AdithyaKesanJayakanth/PLE-SBS-Capstone/README.md

# PLE-SBS — Pre-Launch Emergency: The Slidewire Basket System

A student engineering study of a gravity-driven slidewire escape system for crew and close-out technicians at a crewed launch pad, with a sizing method for any launch pad (span ≈ 100 m + 4 × crew access height) and a worked example for a low, 42 m pad. It goes from the safety problem and its requirements, through physical models and a simulator, to a design that has been run, checked against NASA systems and revised.

> [!IMPORTANT]
> **My special add-on to the existing egress system: one wire, a switch yard and a bay for every pod.**
>
> Existing slidewires give every basket its own wire and brake it at the end of that wire. PLE-SBS keeps the proven ride but moves the braking off the wire. At the bottom, self-indexing points send each pod into its own braked bay beside the bunker, so:
>
> - all the pods share **one wire** and leave about 8 s apart (37 s with a single dock);
> - one wire clears 24 people in 113 s in a design headwind, close to six separate wires (111 s);
> - a pod whose magnetic brake has failed still stops at 1.4 g in its bay's drag-chain bed;
> - nothing needs power: the points, brakes and release interlock are all passive.
>
> See Section 6.2 of the paper and the switch-yard option in the simulator.

**Simulator:** https://adithyakesan.com/ple_sbs/

- **Paper** (≤ 7 pages): `paper/PLE-SBS.pdf`, editable copy `paper/PLE-SBS.docx`, source `paper/paper.md`
- **Simulator**: `web/index.html`. Pick any rocket and pad, choose a single dock or a switch yard, a catch net or drag-chain bed, fail a magnetic brake, and watch the evacuation. A Materials & BOM tab lists what the chosen design is made of.
- **Physics**: `sim/core.js`, one dependency-free file shared by the website and the paper's figures
- **Scale model** (1:50, print-only, the wire is the only purchase): `scale_down/` has the 26 STL files, a fit-and-motion check (also run in FreeCAD), sketches, renders, BOM, build log and test results, including the one-wire switch yard with three self-indexing bays
- **Poster** (A0 landscape): `PLESBS_Poster.pdf`, source `poster/PLESBS_Poster.tex`. Rebuild with `.venv/bin/python poster/make_poster_figs.py && (cd poster && tectonic PLESBS_Poster.tex) && cp poster/PLESBS_Poster.pdf .`

Author: Adithya Kesan Jayakanth, Padma Seshadri Bala Bhavan, K.K. Nagar, Chennai. Mentor and guide: Mrs. Abhitha Peter, Class 12 physics teacher.

## Where the idea came from

PLE-SBS is inspired by the roller coaster. A roller coaster is a machine for giving people forces safely. In an earlier project I built "Safe Thrills", a Python model that designs the most thrilling coaster that stays within human g-force and jerk limits. The lesson that stuck: the ride is good because it runs close to what a body can take, and safe because it never crosses that line.

After I presented my F1 airflow simulations and the roller-coaster model at ISRO's Satish Dhawan Space Centre, the Gaganyaan directors suggested, based on those two projects, the problem of getting a crew off a fuelled launch pad in an emergency. I started from NASA's slidewire baskets at Kennedy's Launch Complex 39 and measured my design against them.

So this is a coaster designed for the worst day instead of the best one. Gravity drives it, a brake limits it, and 1.5 g is the line it must not cross (requirement R4). The brakes are eddy-current brakes of the kind used on roller coasters. The only score is how fast the last person is behind a blast door.

The slidewire basket is NASA's idea. The sizing method for any pad, the finding that passive braking works only in a narrow band of geometry, and the switch yard are mine. ISRO suggested the problem; it did not assign, review or approve the design.

## Run the simulator

Open `web/index.html` in a browser. No build step and no server are needed. Or serve the folder and open `http://localhost:8737/web/`:

```bash
python3 -m http.server 8737
```

## Rebuild the paper

Needs Node 18+, Python 3, pandoc, poppler (`pdfinfo`) and Google Chrome.

```bash
python3 -m venv .venv && .venv/bin/pip install matplotlib numpy
```

```bash
./paper/build.sh
```

This runs the tests, re-runs every study into `data/results.json`, redraws `figures/*.png`, builds the PDF and DOCX, and fails if the PDF is longer than 7 pages. Use `./paper/build.sh --quick` after editing only the text.

## Tests

```bash
node --test test/*.test.js
```

## Publish on GitHub Pages

1. Create a GitHub repository and push this folder.
2. Settings → Pages → Deploy from branch → `main`, folder `/ (root)`.
3. The simulator will be at `https://<user>.github.io/<repo>/web/`. The root `index.html` redirects there.
4. Put that URL into `paper/paper.md` (the `simulator:` line and ref [16]) and rebuild.

## Layout

```
sim/core.js                  physics: hazard, cable, pod dynamics, evacuation, Monte Carlo, trade, sensitivity, scale-model fit
sim/export.js                runs every study in the paper -> data/results.json
figures/make_figures.py      paper figures from data/results.json
paper/                       paper.md (source), template.html + paper.css (layout), build.sh
poster/                      PLESBS_Poster.tex (A0 poster), make_poster_figs.py -> poster/img/
scale_down/                  print-only model: make_parts.py -> stl/, make_drawings.py -> sketch_*.png, BOM.md, README.md
web/                         simulator UI (index.html, app.js, style.css)
data/scale_model.csv         scale-model runs (template; add measurements)
docs/scale-model-protocol.md how to test the 1:50 tabletop rig
docs/scale-model-bom.md      rig parts list, prices, assembly; docs/scale-model-bom.csv
cad/make_parts.py            parametric 3D-printed parts -> cad/stl/*.stl (+ cad/parts_preview.png)
cad/make_drawings.py         rig layout and trolley assembly drawings
test/core.test.js            physics unit tests
site/build.sh                packages the simulator as a static site (published at adithyakesan.com/ple_sbs/)
private/                     author notes (sources, checklist); git-ignored, never published
```

## AI assistance

I used an AI assistant as a programming assistant, tutor and reviewer under the policy in [docs/ai_usage_policy.md](docs/ai_usage_policy.md): drafting and debugging the simulator and its tests, the part generators and the figure scripts, explaining the physics and numerical behaviour when I asked, and reviewing the writing. The requirements, the danger levels, the design decisions and their failures, the sizing rule, the switch-yard add-on and the conclusions are mine, and every number in the paper is produced by the code in this repository and checked against a closed-form case, a reference value or a hand calculation. [docs/ai_use_log.md](docs/ai_use_log.md) lists the assistance actually used and how each output was verified.

## Honesty notes

- All results are model predictions from public data and stated assumptions. This is not a certified safety analysis.
- The reference launcher and pad are generic; their dimensions are estimates.
- Unconfirmed facts are marked `[VERIFY]` in the paper and listed in `docs/author-checklist.md`.
- The scale-model pictures in the paper and poster are renders of the part files; photographs and timed runs go in `scale_down/photos/` and `scale_down/results.csv`.
