AdithyaKesanJayakanth/PLE-SBS-Capstone/scale_down/photos/README.md

# Photographs

Put photographs of the printed model here, named like `01_yard.jpg`, `02_pod.jpg`, `03_points.jpg`, `04_run.jpg`.
The paper and poster use the renders (`render_*.png`) until photographs exist; swap the file names in
`paper/paper.md` (Figure 8) and `poster/PLESBS_Poster.tex` (block 3) and rebuild.
