AdithyaKesanJayakanth/PLE-SBS-Capstone/docs/ai_use_log.md

# AI-use log — PLE-SBS

Kept as required by `docs/ai_usage_policy.md`. "Checked by" names the verification actually performed (test, reference comparison, hand calculation, documentation lookup), not an intention. Dates are the repository's commit dates.

| Period | Tool | Task | Significant assistance received | Changes I made | Checked by |
|---|---|---|---|---|---|
| 2 June 2026 | AI coding assistant | Project set-up | Drafted the build scripts, the paper template and the data layout | Chose the single-physics-file structure so the paper and the website share one model; set the 7-page limit in the build | Build runs end to end; page-count check fails the build when exceeded |
| 4–10 June | AI coding assistant | Hazard model, cable model, pod dynamics | Drafted `sim/core.js` from my written specification of the TNT equivalence, cube-root blast scaling, High's fireball correlations, the taut-string influence line and the pod equation of motion; explained the eddy-current brake's velocity dependence | Decided the two-corner brake sizing, the danger levels and the requirements R1–R7; chose the thermal dose threshold between pain and first-degree burn | Unit tests against closed-form cases (√2gh arrival, incline time, terminal speed, wL²/8T and PL/4T sag); hand calculation of the reference launcher's TNT and blast distance |
| 8–13 June | AI coding assistant | Evacuation simulator and web interface | Drafted the dispatch logic, the headway bisection, the Monte Carlo loop and the browser interface | Set the human timings, the balanced-loading rule and the release-from-inside design; chose what the interface exposes | Time-step halving changes the total by 0.03 s; a stalled pod holds the one behind it; validation against the Shuttle-era basket speed with no tuning |
| 13–15 June | AI coding assistant | Scale-model rig parts and drawings | Drafted the parametric part generator and the drawings | Chose the 1:50 scale, the Froude mapping and the test protocol | Watertight STL check; dimensions read back from the drawings |
| 16 June – 6 July | AI coding assistant | Results export, figures, paper draft | Ran the studies into the results file, drafted the figures and the first draft of the paper from my outline; reviewed later drafts | Wrote the requirements, the design-iteration narrative (D0 to D5), the sizing rule, the switch-yard add-on, the limitations and the conclusion; marked every unconfirmed fact `[VERIFY]` and worked the author checklist | Every number re-read against `data/results.json`; references opened and confirmed (NTRS, HSE, Reveles et al.); Shuttle validation within 3 % |
| 20–21 June | AI coding assistant | Research poster | Laid out the A0 poster from the paper and my notes on the inspiration (the coaster paper, the visit to ISRO, the build-run-redesign loop) | Chose the block structure and what to say in my own words; cut text to fit | All numbers cross-checked against the paper; rebuilt with tectonic |
| 22–27 June | AI coding assistant | Print-only 1:50 model with the switch yard | Drafted the parametric part generator (pods, rails, turnout, cam and star indexer, comb, chain, bumper), the sketches, the renders, the BOM and the room-sizing calculator | Set the constraints (one purchase, P1S bed, 2 m tie point), chose the friction comb and the star-and-cam indexer as model-scale substitutes, and wrote the honesty notes on what is and is not to scale | Every STL watertight and single-body; bounding boxes within the bed; geometry read back from the sketches; mechanism clearances checked against the pannier sweep |
| 25 June | AI coding assistant | Paper and poster update for the model | Drafted the Section 4 paragraph and Figure 8 | Decided what to claim and kept the placeholder for measured runs until they exist | Rebuilt PDF at 7 pages; figure captions state that the pictures are renders |
| 28 June – 3 July | AI coding assistant | Model version 2 after the printed parts did not fit | Audited version 1 against itself (`scale_down/check/audit_v1.py`), redesigned phase 1 around the wheel's seat heights, replaced the star-and-cam indexer with a flap-driven two-finger escapement, wrote the fit-and-motion check and the FreeCAD cross-check, re-sliced the parts and listed what to reprint | Printed version 1 and found that the wagon, the axles and the turnout did not fit; asked for a full fit check in FreeCAD before reprinting | Every part placed in its working position with exact overlap volumes; a wagon driven down all three lanes; the escapement simulated R, C, L; the same clash check repeated with FreeCAD's own booleans (`scale_down/check/assembly_report.md`, `freecad_report.md`); the earlier row's sweep check missed these faults, which is why the check now uses the real parts in place |
| 1–2 July | AI coding assistant | Phase-1 assembly guide, animations and motion check | Placed every phase-1 part for each assembly step and for a run of three wagons, drove the flap, rocker and tongue with the fit check's kinematics, rendered the steps in FreeCAD and made the animations; the assembly-path check found that the tongue could not go onto its post past the rocker bridges, that the last comb leaf blocked the next segment and that the start gate would drop off the wire, and these were redesigned (separate rocker bridge, entry-rail web raised, comb leaves moved back, gate slot turned down) | Asked for FreeCAD screenshots, step-by-step assembly and working animations, and to be sure the printed parts can be put together | Every assembly move replayed in small steps against the parts already in place (`scale_down/assembly/path_check_report.md`); the same moves and the run replayed with FreeCAD's booleans (`freecad_motion_report.md`); the full fit check rerun |
| 3 July | AI coding assistant | Red-team review of phase 1 | Asked to attack the design for hand assembly, fit and whether the experiment can run; found that the plate gap was not positively set, that 0.3 mm lip clearance was too tight for a printed blade, that the plate and boss thicknesses did not suit the layer height, that the snap notches were tight, that the bridge beams could sag onto the teeth, and that the brake comb and bumper cannot stop a pod at scale speed; made the six geometry fixes and corrected the README's tuning advice | Asked for the review and then for the fixes | Forces and stack tolerances computed from the part constants; both fit checks, the path check and the FreeCAD checks rerun on the changed parts; changed parts re-sliced |
