AdithyaKesanJayakanth/PLE-SBS-Capstone/scale_down/render_overall.png

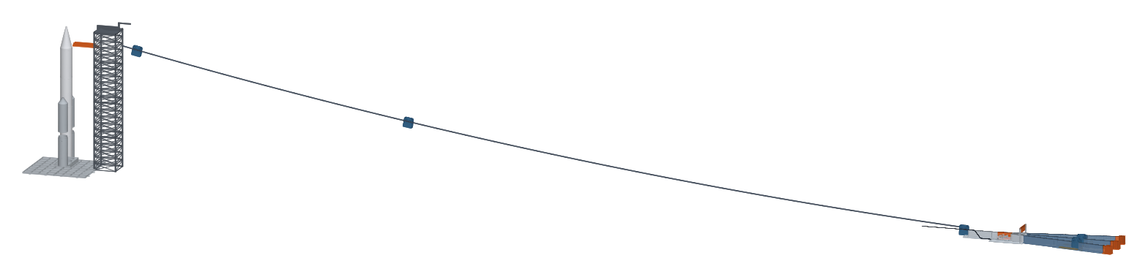
scale_down/render_overall.png
