AdithyaKesanJayakanth/PLE-SBS-Capstone/scale_down/render_overall_dimensioned.png

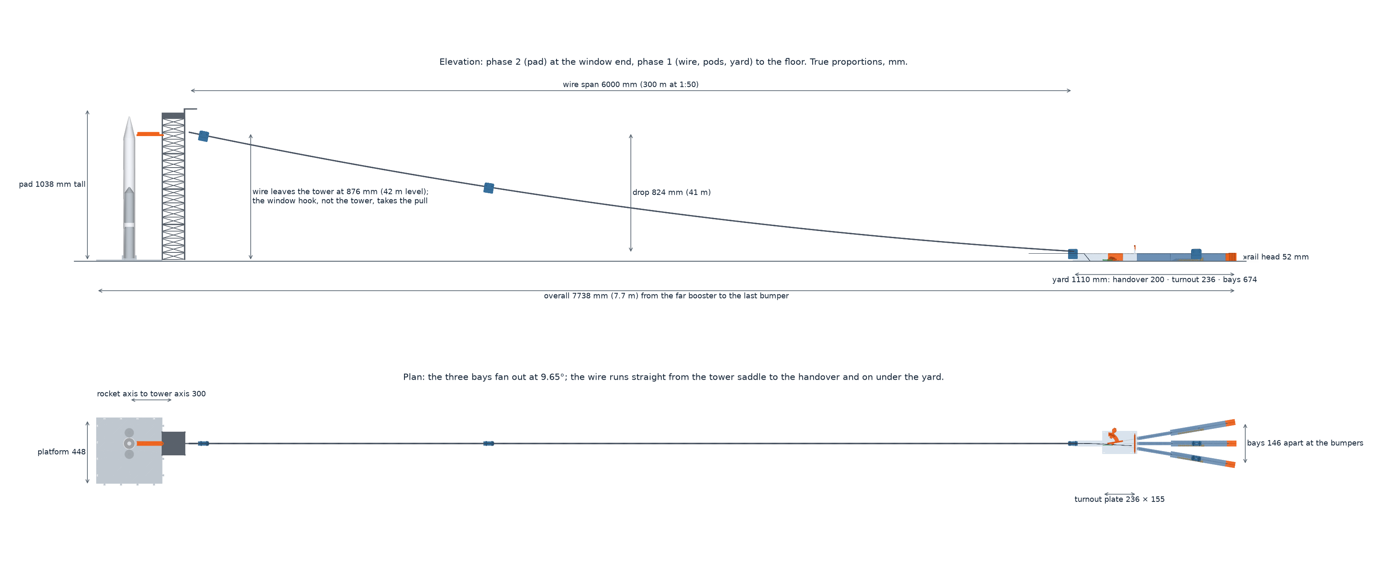
scale_down/render_overall_dimensioned.png
