AdithyaKesanJayakanth/PLE-SBS-Capstone/scale_down/render_pad_dimensioned.png

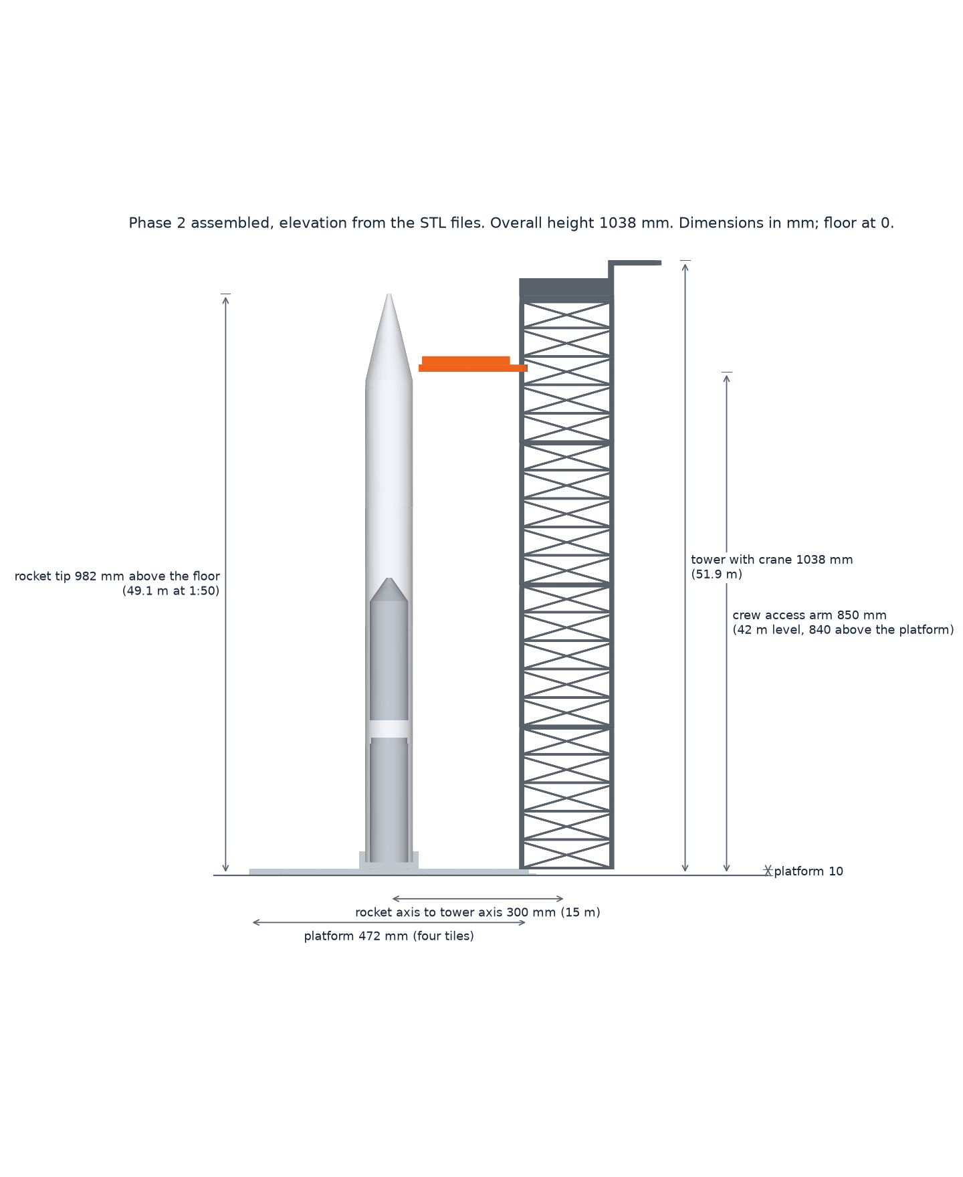
scale_down/render_pad_dimensioned.png
