AdithyaKesanJayakanth/PLE-SBS-Capstone/scale_down/render_pad_side.png

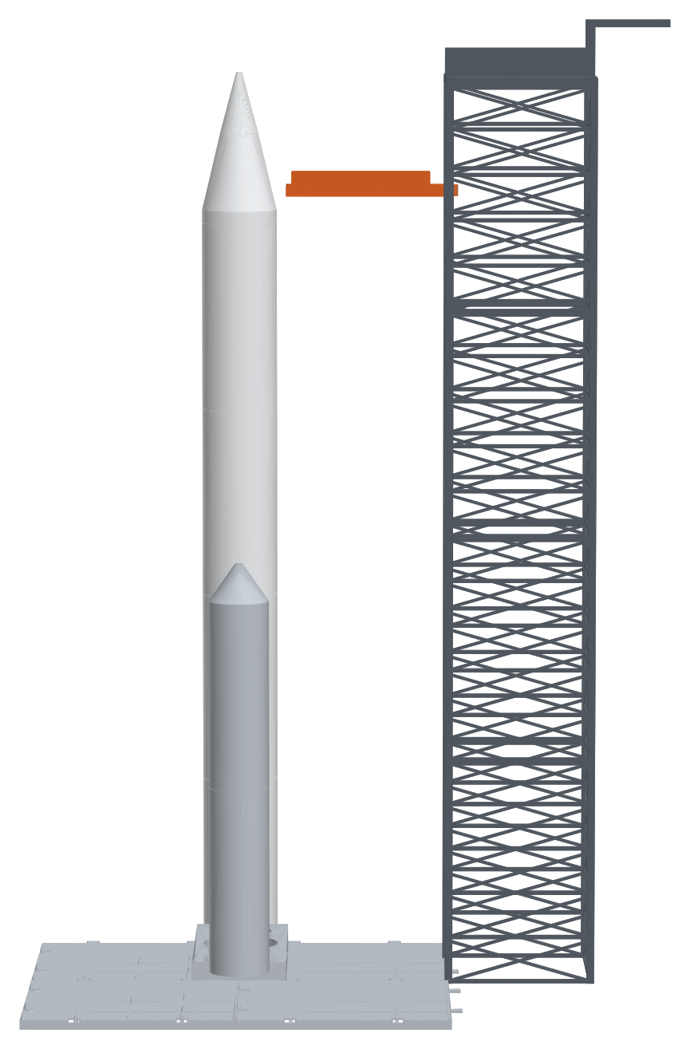
scale_down/render_pad_side.png
