AdithyaKesanJayakanth/PLE-SBS-Capstone/scale_down/sketch_8_launchpad.png

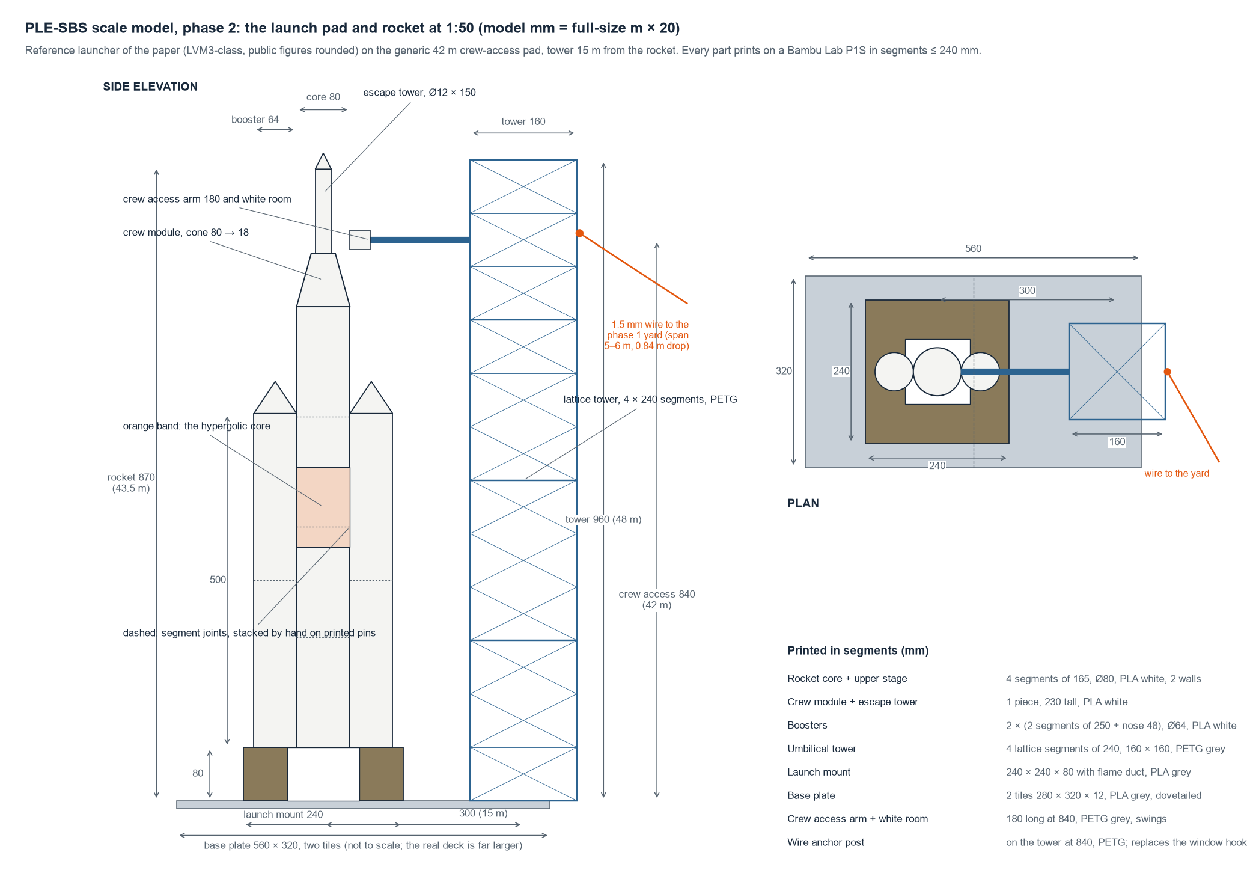
scale_down/sketch_8_launchpad.png
