AdithyaKesanJayakanth/PLE-SBS-Capstone/scale_down/BOM_phase2.md

# Phase 2 bill of materials: launch pad and rocket at 1:50

Files: `stl_phase2/` (13 STL files, 27 pieces), generated by `make_pad_parts.py`; the same table is in `pad_parts.csv`; preview `pad_parts_preview.png`; assembled render `render_pad.png`; dimensions `sketch_8_pad_phase2.png`. Nothing to buy except filament. The model is cosmetic: the wire's pull goes to the window hook, not the printed tower.

## 1. Printed parts

| # | File | Qty | Size (mm) | Filament | Colour | g each | g total | Orientation | What it is |
|---:|---|---:|---|---|---|---:|---:|---|---|
| 1 | core_segment_x4.stl | 4 | Ø80 × 210 | PLA Basic | Jade White | 50 | 200 | standing, spigot up | core stage tube, 200 mm plus a 10 mm spigot; two strut holes each side |
| 2 | capsule_x1.stl | 1 | Ø80 × 160 | PLA Basic | Jade White | 50 | 50 | standing, tip up | frustum and nose; socket takes the top core spigot |
| 3 | booster_lower_x2.stl | 2 | Ø64 × 250 | PLA Basic | Light Grey | 50 | 100 | standing, spigot up | lower booster tube; strut holes |
| 4 | booster_upper_x2.stl | 2 | Ø64 × 240 | PLA Basic | Light Grey | 55 | 110 | standing, nose up | upper booster tube with the nose |
| 5 | booster_strut_x4.stl | 4 | 10 × 10 × 13 | PLA Basic | Light Grey | 1 | 4 | on its side | double peg: core hole to booster hole |
| 6 | tower_section_x4.stl | 4 | 160 × 160 × 250 | PLA Basic | Dark Grey | 110 | 440 | standing, pegs up | lattice section; pegs into the holes of the one above |
| 7 | tower_crown_x1.stl | 1 | 240 × 160 × 68 | PLA Basic | Dark Grey | 60 | 60 | flat, crane up | cap with crane girder, mast and jib |
| 8 | arm_bracket_x1.stl | 1 | 16 × 28 × 30 | PLA Basic | Dark Grey | 8 | 8 | standing | C-clip onto a corner post at 840 mm; carries the pin |
| 9 | access_arm_x1.stl | 1 | 184 × 30 × 26 | PLA Basic | Orange | 45 | 45 | flat, rails up | crew access arm; pivot boss one end, yoke to the capsule the other |
| 10 | arm_pin_x1.stl | 1 | Ø6 × 46 | PETG HF | Orange | 2 | 2 | standing on the head | pivot pin |
| 11 | wire_saddle_x1.stl | 1 | 24 × 28 × 30 | PLA Basic | Dark Grey | 10 | 10 | standing | C-clip onto a post; groove the wire lies in as it leaves the tower |
| 12 | launch_mount_x1.stl | 1 | 100 × 230 × 30 | PLA Basic | Light Grey | 80 | 80 | flat, pockets up | three pockets hold the core and both boosters |
| 13 | platform_tile_x4.stl | 4 | 248 × 248 × 10 | PLA Basic | Light Grey | 150 | 600 | flat, ribs up, then turned over | launch platform; dovetails as in the yard |
| | **Total** | **27** | | | | | **1,709** | | |

## 2. Filament by colour, as sliced

Exact grams from OrcaSlicer (P1S 0.4 mm profiles, settings of section 3); see `print_pack/README.md` for the per-file figures.

| Colour | Filament | Parts | Sliced | With 20 % margin |
|---|---|---|---:|---:|
| Jade White | PLA Basic | 1, 2 | 476 g | 570 g |
| Light Grey | PLA Basic | 3, 4, 5, 12, 13 | 1,185 g | 1,420 g |
| Dark Grey | PLA Basic | 6, 7, 8, 11 | 804 g | 965 g |
| Orange | PLA Basic | 9 | 45 g | 55 g |
| Orange | PETG HF | 10 | 2 g | 5 g |
| **Phase 2** | | | **2,511 g** | **3,015 g** |

The platform tiles are 678 g of that; without them phase 2 is 1,833 g and the Light Grey drops to 507 g.

## 3. Print settings

| Setting | Value |
|---|---|
| Nozzle, layer | 0.4 mm, 0.2 mm |
| Walls | 2 for the tubes (they are thin shells); 3 for the tower, crown, mount and tiles |
| Infill | 15 % gyroid (tiles, mount, crown); tubes and lattice have none |
| Supports | none; the tower braces are 3 mm bars at under 45° |
| Brim | 5 mm on the tubes and the tower sections (tall, small footprint) |
| Minimum layer time | leave the default; the Ø64 and Ø80 tubes are limited by it, not by speed |

Printing time from the slicer: 65 hours; the tower sections are 25 h and the platform tiles 12 h.

## 4. Assembly

1. Tower: stack the four sections, pegs into holes, crown on top. Clip the arm bracket and the wire saddle to the corner post nearest the rocket, bracket at 840 mm above the platform.
2. Rocket: core segments on the launch mount, spigots up, capsule last. Boosters into their pockets, lower then upper; push a strut through each pair of holes.
3. Arm: pin it to the bracket; it swings to rest its yoke on the capsule.
4. Platform: tiles joined with the dovetails, ribs down; launch mount centred; the tower stands 300 mm from the rocket axis.
5. Wire: lay it in the saddle's groove on its way from the yard to the window hook. The hook takes the load.
