AdithyaKesanJayakanth/PLE-SBS-Capstone/scale_down/print_pack/parts_table.md

# All printed parts, by phase

Plate numbers are a suggested print order within each phase. A file sliced as one piece but needed four times takes four plates. Dimensions are the piece as it sits on the bed, in mm. Weights and times are the slicer's (OrcaSlicer, Bambu Lab P1S 0.4 mm profiles); the time is for all the pieces in that row.

## Phase 1: wire, pods and switch yard

| Plate | Part | Qty | Dimensions (mm) | Filament | Colour | g each | g total | Time |
|---|---|---:|---|---|---|---:|---:|---|
| P1-01 | fit_coupon_x1 | 1 | 118.0 × 36.0 × 15.0 | PETG HF | Orange | 21.5 | 21.5 | 0h 59m |
| P1-02 | wheel_x6 | 6 | 24.0 × 24.0 × 8.0 | PLA Basic | Cobalt Blue | 3.5 | 20.9 | 1h 06m |
| P1-03 | axle_pin_x6 | 6 | 8.0 × 8.0 × 32.4 | PETG HF | Orange | 0.6 | 3.4 | 0h 52m |
| P1-04 | trolley_plate_x6 | 6 | 64.0 × 40.0 × 15.8 | PLA Basic | Cobalt Blue | 8.2 | 49.1 | 1h 27m |
| P1-05 | pannier_x6 | 6 | 64.0 × 10.2 × 54.8 | PLA Basic | Cobalt Blue | 17.5 | 105.2 | 2h 25m |
| P1-06 | turnout_base_x1 | 1 | 249.0 × 155.0 × 109.0 | PLA Basic | Light Grey | 159.9 | 159.9 | 3h 38m |
| P1-07 | tongue_x1 | 1 | 106.0 × 88.7 × 49.5 | PLA Basic | Orange | 22.5 | 22.5 | 0h 41m |
| P1-08 | rocker_bridge_x1 | 1 | 39.4 × 53.0 × 17.0 | PLA Basic | Light Grey | 6.6 | 6.6 | 0h 25m |
| P1-09 | rocker_x1 | 1 | 30.6 × 77.0 × 13.4 | PLA Basic | Orange | 8.3 | 8.3 | 0h 28m |
| P1-10 | rocker_pin_x1 | 1 | 6.5 × 6.5 × 44.0 | PETG HF | Orange | 0.5 | 0.5 | 0h 14m |
| P1-11 | bias_spring_x1 | 1 | 67.4 × 2.2 × 8.0 | PETG HF | Orange | 1.0 | 1.0 | 0h 14m |
| P1-12 | flap_x1 | 1 | 34.5 × 114.0 × 9.0 | PLA Basic | Orange | 14.8 | 14.8 | 0h 25m |
| P1-13 | gantry_axle_x1 | 1 | 4.0 × 134.0 × 3.5 | PETG HF | Orange | 2.1 | 2.1 | 0h 12m |
| P1-14 | handover_x1 | 1 | 212.0 × 40.0 × 53.5 | PLA Basic | Light Grey | 49.1 | 49.1 | 1h 06m |
| P1-15 | window_hook_x1 | 1 | 84.0 × 74.0 × 46.0 | PETG HF | Orange | 49.6 | 49.6 | 1h 25m |
| P1-16 | wedge_x1 | 1 | 32.0 × 5.4 × 22.0 | PETG HF | Orange | 3.2 | 3.2 | 0h 39m |
| P1-17 | lead_rail_230_x3 | 3 | 242.0 × 22.0 × 53.5 | PLA Basic | Light Grey | 43.8 | 131.5 | 2h 29m |
| P1-18 | brake_comb_190_x3 | 3 | 202.0 × 40.0 × 53.5 | PLA Basic | Light Grey | 50.2 | 150.5 | 3h 27m |
| P1-19 | chain_bed_190_x3 | 3 | 202.0 × 40.0 × 53.5 | PLA Basic | Light Grey | 44.3 | 132.9 | 2h 34m |
| P1-20 | chain_11_links_x3 | 3 | 156.0 × 10.0 × 10.0 | PLA Basic | Light Grey | 5.7 | 17.1 | 0h 59m |
| P1-21 | sled_x3 | 3 | 20.0 × 13.0 × 22.0 | PLA Basic | Light Grey | 3.3 | 10.0 | 0h 23m |
| P1-22 | bumper_x3 | 3 | 64.0 × 40.0 × 56.0 | PETG HF | Orange | 35.4 | 106.2 | 4h 45m |
| P1-23 | start_gate_x1 | 1 | 30.0 × 14.0 × 25.0 | PLA Basic | Light Grey | 5.8 | 5.8 | 0h 19m |
| P1-24 | gate_lever_x1 | 1 | 28.9 × 28.5 × 4.6 | PLA Basic | Light Grey | 1.4 | 1.4 | 0h 09m |
| P1-25 | gate_key_x1 | 1 | 30.0 × 3.1 × 6.6 | PETG HF | Orange | 0.7 | 0.7 | 0h 14m |
| P1-26 | gate_pin_x1 | 1 | 6.0 × 6.0 × 26.0 | PETG HF | Orange | 0.4 | 0.4 | 0h 11m |
| | **Phase 1 total** | **58** | | | | | **1,074** | **31h 46m** |

| Filament | Colour | g |
|---|---|---:|
| PETG HF | Orange | 189 |
| PLA Basic | Cobalt Blue | 175 |
| PLA Basic | Light Grey | 665 |
| PLA Basic | Orange | 46 |

26 part files, 58 pieces, 26 plates.

## Phase 2: launch pad and rocket

| Plate | Part | Qty | Dimensions (mm) | Filament | Colour | g each | g total | Time |
|---|---|---:|---|---|---|---:|---:|---|
| P2-01 | core_segment_x4 | 4 | 80.0 × 80.0 × 210.0 | PLA Basic | Jade White | 101.1 | 404.2 | 8h 48m |
| P2-02 | capsule_x1 | 1 | 80.0 × 80.0 × 160.0 | PLA Basic | Jade White | 71.6 | 71.6 | 1h 52m |
| P2-03 | booster_lower_x2 | 2 | 64.0 × 64.0 × 210.0 | PLA Basic | Light Grey | 80.4 | 160.8 | 3h 53m |
| P2-04 | booster_upper_x2 | 2 | 64.0 × 64.0 × 240.0 | PLA Basic | Light Grey | 92.4 | 184.8 | 4h 18m |
| P2-05 | booster_strut_x4 | 4 | 10.0 × 10.0 × 13.2 | PLA Basic | Light Grey | 0.3 | 1.2 | 0h 16m |
| P2-06 to P2-09 | tower_section_x4 | 4 | 160.0 × 160.0 × 250.0 | PLA Basic | Dark Grey | 166.1 | 664.2 | 25h 26m |
| P2-10 | tower_crown_x1 | 1 | 240.0 × 160.0 × 68.0 | PLA Basic | Dark Grey | 118.3 | 118.3 | 2h 33m |
| P2-11 | arm_bracket_x1 | 1 | 16.0 × 28.0 × 30.0 | PLA Basic | Dark Grey | 10.1 | 10.1 | 0h 25m |
| P2-12 | access_arm_x1 | 1 | 183.9 × 30.0 × 26.0 | PLA Basic | Orange | 44.9 | 44.9 | 1h 03m |
| P2-13 | arm_pin_x1 | 1 | 10.0 × 10.0 × 46.0 | PETG HF | Orange | 1.8 | 1.8 | 0h 32m |
| P2-14 | wire_saddle_x1 | 1 | 24.0 × 28.0 × 30.0 | PLA Basic | Dark Grey | 11.1 | 11.1 | 0h 25m |
| P2-15 | launch_mount_x1 | 1 | 100.0 × 230.0 × 30.0 | PLA Basic | Light Grey | 160.4 | 160.4 | 3h 28m |
| P2-16 to P2-19 | platform_tile_x4 | 4 | 236.0 × 236.0 × 10.0 | PLA Basic | Light Grey | 169.4 | 677.6 | 11h 49m |
| | **Phase 2 total** | **27** | | | | | **2,511** | **64h 48m** |

| Filament | Colour | g |
|---|---|---:|
| PETG HF | Orange | 2 |
| PLA Basic | Dark Grey | 804 |
| PLA Basic | Jade White | 476 |
| PLA Basic | Light Grey | 1,185 |
| PLA Basic | Orange | 45 |

13 part files, 27 pieces, 19 plates.

## Both phases

85 pieces on 45 plates, **3,585 g** of filament, about **96h 34m** of printing.
