AdithyaKesanJayakanth/PLE-SBS-Capstone/scale_down/parts.csv

file | qty | material | colour | grams_each | x_mm | y_mm | z_mm | note
fit_coupon_x1.stl | 1 | PETG | Orange | 11 | 118.0 | 36.0 | 15.0 | print first: posts and bored rings at 0.15 to 0.40 mm per side
wheel_x6.stl | 6 | PLA | Cobalt Blue | 2 | 24.0 | 24.0 | 8.0 | V-groove wheel; rides the wire and the rail head
axle_pin_x6.stl | 6 | PETG | Orange | 0 | 8.0 | 8.0 | 32.4 | 4 mm pin through pannier, plate, wheel, plate, pannier; snap bump
trolley_plate_x6.stl | 6 | PLA | Cobalt Blue | 6 | 64.0 | 40.0 | 15.8 | two identical plates per wagon; prints flat, peg up
pannier_x6.stl | 6 | PLA | Cobalt Blue | 11 | 64.0 | 10.2 | 54.8 | basket; two identical per wagon, clamped by the axle pins
turnout_base_x1.stl | 1 | PLA | Light Grey | 117 | 249.0 | 155.0 | 109.0 | plate, entry and exit rails, pivot, stops, rocker bridges, gantry posts
tongue_x1.stl | 1 | PLA | Orange | 13 | 106.0 | 88.7 | 49.5 | switch blade with the ring of four teeth
rocker_bridge_x1.stl | 1 | PLA | Light Grey | 3 | 39.4 | 53.0 | 17.0 | two beams over the tooth ring; carries the rocker pin and the tilt stops; sits on four pegs
rocker_x1.stl | 1 | PLA | Orange | 6 | 30.6 | 77.0 | 13.4 | escapement rocker; prints upside down
rocker_pin_x1.stl | 1 | PETG | Orange | 0 | 6.5 | 6.5 | 44.0 | 3 mm rocker axle with snap bump
bias_spring_x1.stl | 1 | PETG | Orange | 0 | 67.4 | 2.2 | 8.0 | leaf spring that pushes the tongue toward the next lane
flap_x1.stl | 1 | PLA | Orange | 8 | 34.5 | 114.0 | 9.0 | trigger flap with crank; prints on its downstream face
gantry_axle_x1.stl | 1 | PETG | Orange | 1 | 4.0 | 134.0 | 3.5 | 4 mm flap axle, prints on its flat
handover_x1.stl | 1 | PLA | Light Grey | 35 | 212.0 | 40.0 | 53.5 | wire-to-rail handover; the wire dives through it
window_hook_x1.stl | 1 | PETG | Orange | 50 | 84.0 | 74.0 | 46.0 | top anchor: capstan post and wedge pocket
wedge_x1.stl | 1 | PETG | Orange | 2 | 32.0 | 5.4 | 22.0 | pinches the wire in the window hook
lead_rail_230_x3.stl | 3 | PLA | Light Grey | 27 | 242.0 | 22.0 | 53.5 | first bay segment, narrow strip
brake_comb_190_x3.stl | 3 | PLA | Light Grey | 31 | 202.0 | 40.0 | 53.5 | rail with 12 leaves under the right basket and the chain trough under the left
chain_bed_190_x3.stl | 3 | PLA | Light Grey | 28 | 202.0 | 40.0 | 53.5 | rail with the chain trough, end to end; the sled starts here
chain_11_links_x3.stl | 3 | PLA | Light Grey | 3 | 156.0 | 10.0 | 10.0 | print-in-place drag chain
sled_x3.stl | 3 | PLA | Light Grey | 2 | 20.0 | 13.0 | 22.0 | pushed by the left basket; drags the chain tied to its back
bumper_x3.stl | 3 | PETG | Orange | 21 | 64.0 | 40.0 | 56.0 | zig-zag spring at the end of each bay
start_gate_x1.stl | 1 | PLA | Light Grey | 4 | 30.0 | 14.0 | 25.0 | clamps on the wire behind the waiting wagon
gate_lever_x1.stl | 1 | PLA | Light Grey | 1 | 28.9 | 28.5 | 4.6 | hook over the wagon's rear spacer peg
gate_key_x1.stl | 1 | PETG | Orange | 0 | 30.0 | 3.1 | 6.6 | tapered key that locks the gate on the wire
gate_pin_x1.stl | 1 | PETG | Orange | 0 | 6.0 | 6.0 | 26.0 | lever pivot pin
