AdithyaKesanJayakanth/PLE-SBS-Capstone/scale_down/check/phase1_assembly.FCStd

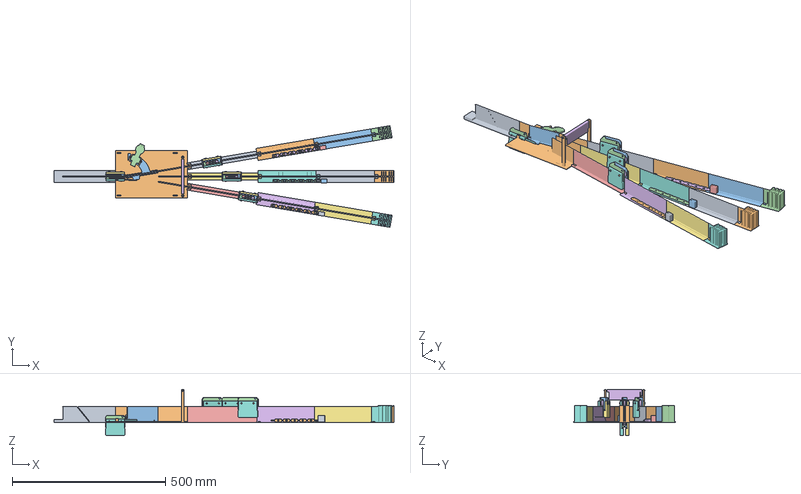
[picture p33: CAD file, 2026-07-03]
scale_down/check/phase1_assembly.FCStd
1110.0 x 332.0 x 151.8 mm
handover
turnout_plate
tongue_L
rocker_rest
rocker_pin
flap
gantry_axle
spring
lead_L
brake_L
chainbed_L
bumper_L
sled_L
chain_L
lead_C
brake_C
chainbed_C
bumper_C
sled_C
chain_C
lead_R
brake_R
chainbed_R
bumper_R
sled_R
chain_R
wagon_R_plate_R
wagon_R_plate_L
wagon_R_wheel_rear
wagon_R_wheel_front
wagon_R_pannier_R
wagon_R_pannier_L
wagon_R_pin_rear
wagon_R_pin_front
wagon_C_plate_R
wagon_C_plate_L
wagon_C_wheel_rear
wagon_C_wheel_front
wagon_C_pannier_R
wagon_C_pannier_L
wagon_C_pin_rear
wagon_C_pin_front
wagon_L_plate_R
wagon_L_plate_L
wagon_L_wheel_rear
wagon_L_wheel_front
wagon_L_pannier_R
wagon_L_pannier_L
wagon_L_pin_rear
wagon_L_pin_front
pod_plate_R
pod_plate_L
pod_wheel_rear
pod_wheel_front
pod_pannier_R
pod_pannier_L
pod_pin_rear
pod_pin_front
