AdithyaKesanJayakanth/PLE-SBS-Capstone/cad/stl/keeper_sleeve_x4.stl

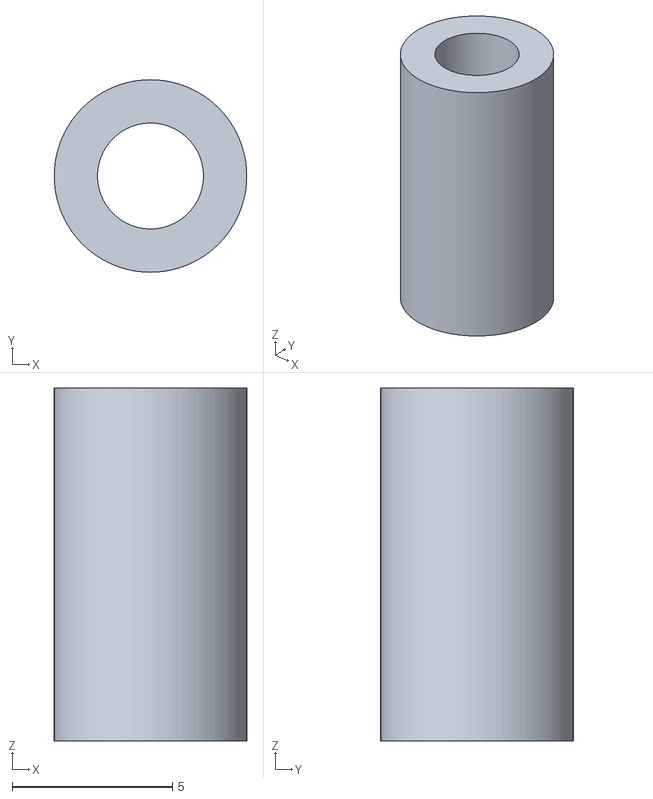
[picture p34: CAD file, 2026-06-14]
cad/stl/keeper_sleeve_x4.stl
6.00 x 6.00 x 11.0
