AdithyaKesanJayakanth/PLE-SBS-Capstone/scale_down/print_pack/phase1/reprint_v2/set1/sliced_p1s/tongue_x1.gcode.3mf

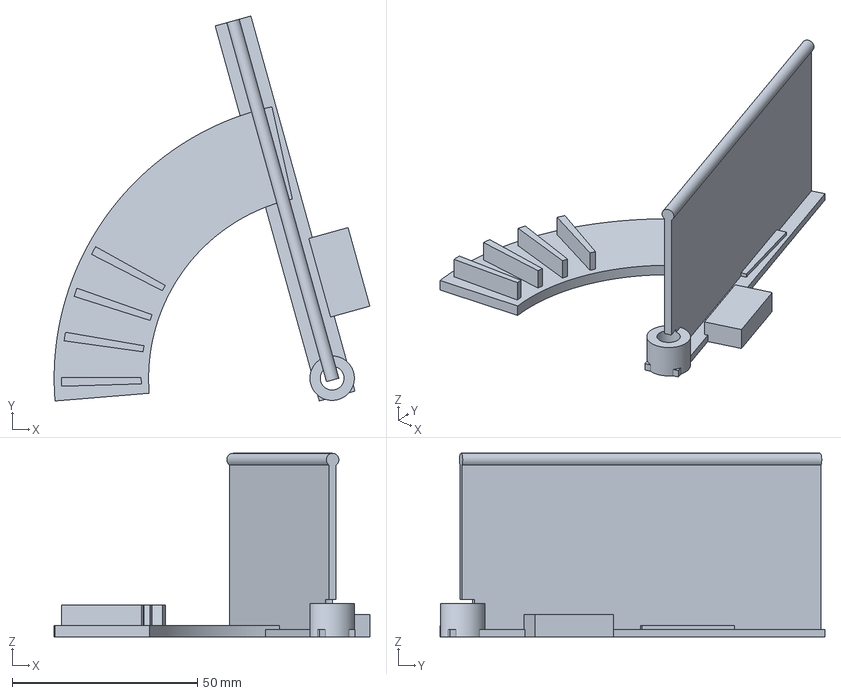
[picture p35: CAD file, 2026-07-03]
scale_down/print_pack/phase1/reprint_v2/set1/sliced_p1s/tongue_x1.gcode.3mf
85.2 x 103.9 x 49.5 mm
