AdithyaKesanJayakanth/PLE-SBS-Capstone/scale_down/print_pack/phase1/reprint_v2/set1/stl/tongue_x1.stl

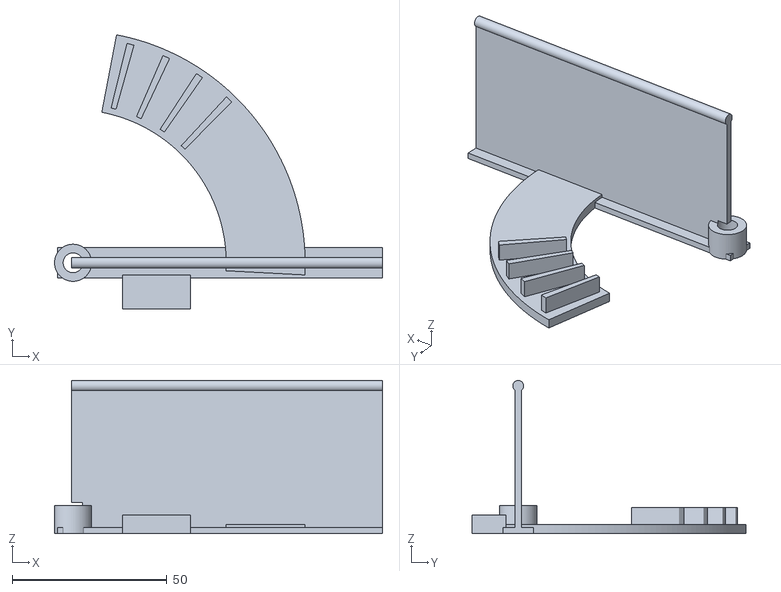
[picture p36: CAD file, 2026-07-03]
scale_down/print_pack/phase1/reprint_v2/set1/stl/tongue_x1.stl
106.0 x 88.7 x 49.5
