AdithyaKesanJayakanth/PLE-SBS-Capstone/scale_down/print_pack/phase1/reprint_v2/set2/sliced_p1s/brake_comb_190_x3.gcode.3mf

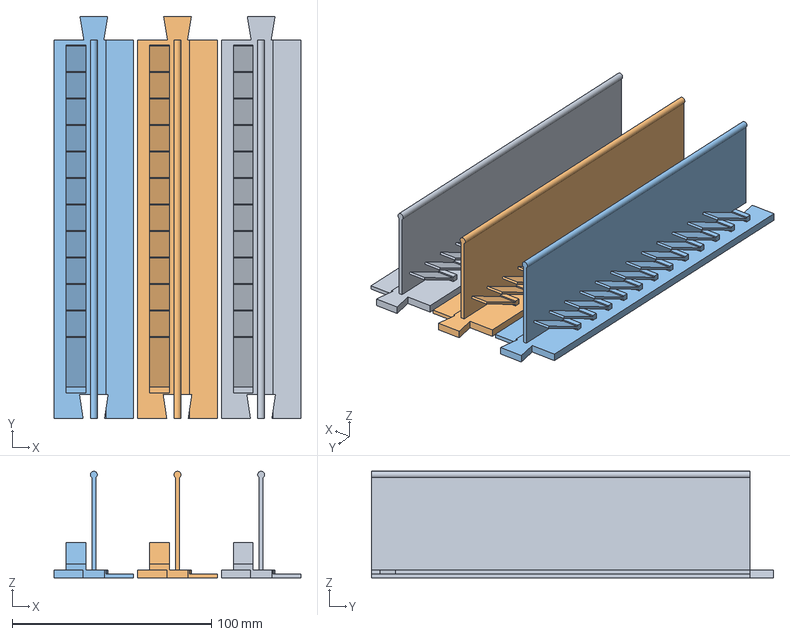
[picture p37: CAD file, 2026-07-03]
scale_down/print_pack/phase1/reprint_v2/set2/sliced_p1s/brake_comb_190_x3.gcode.3mf
124.0 x 202.0 x 53.5 mm
brake_comb_190_x3.stl x 3
