AdithyaKesanJayakanth/PLE-SBS-Capstone/scale_down/print_pack/phase1/reprint_v2/set2/stl/gate_lever_x1.stl

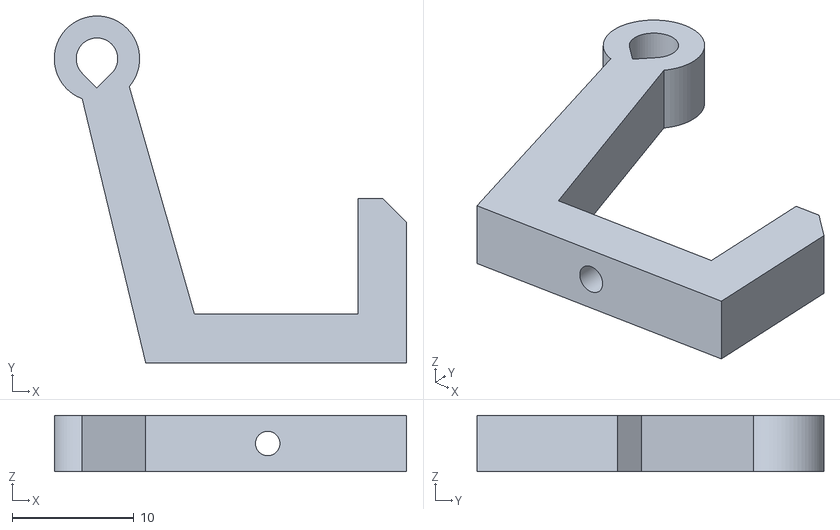
[picture p38: CAD file, 2026-07-03]
scale_down/print_pack/phase1/reprint_v2/set2/stl/gate_lever_x1.stl
28.9 x 28.5 x 4.60
