AdithyaKesanJayakanth/PLE-SBS-Capstone/scale_down/print_pack/phase1/sliced_p1s/gate_key_x1.gcode.3mf

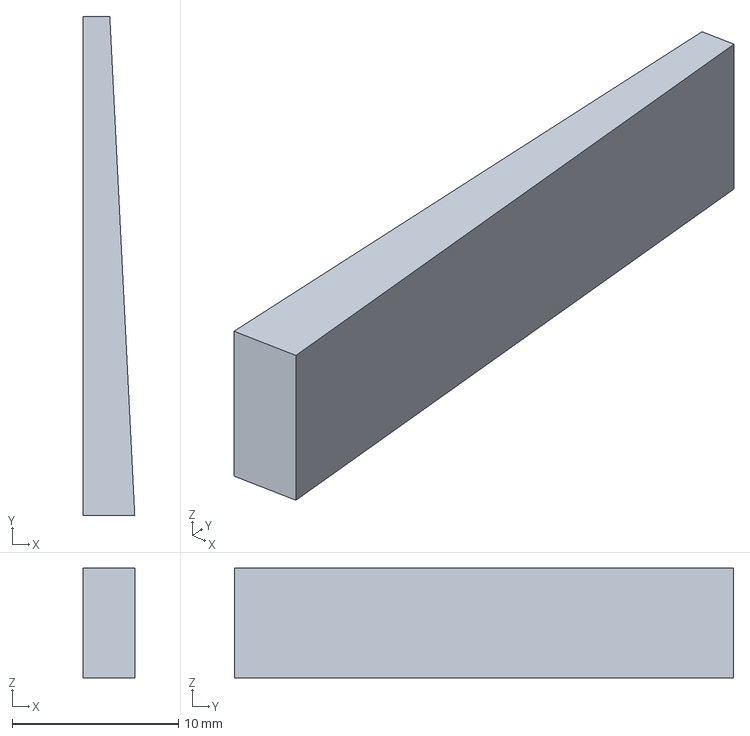
[picture p39: CAD file, 2026-06-30]
scale_down/print_pack/phase1/sliced_p1s/gate_key_x1.gcode.3mf
3.10 x 30.0 x 6.60 mm
