AdithyaKesanJayakanth/PLE-SBS-Capstone/scale_down/print_pack/phase1/stl/lead_rail_230_x3.stl

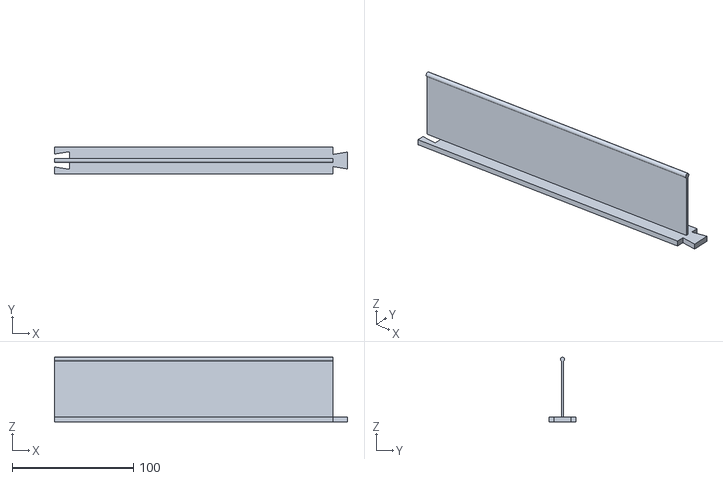
[picture p40: CAD file, 2026-06-29]
scale_down/print_pack/phase1/stl/lead_rail_230_x3.stl
242.0 x 22.0 x 53.5
