AdithyaKesanJayakanth/PLE-SBS-Capstone/scale_down/print_pack/phase2/sliced_p1s/wire_saddle_x1.gcode.3mf

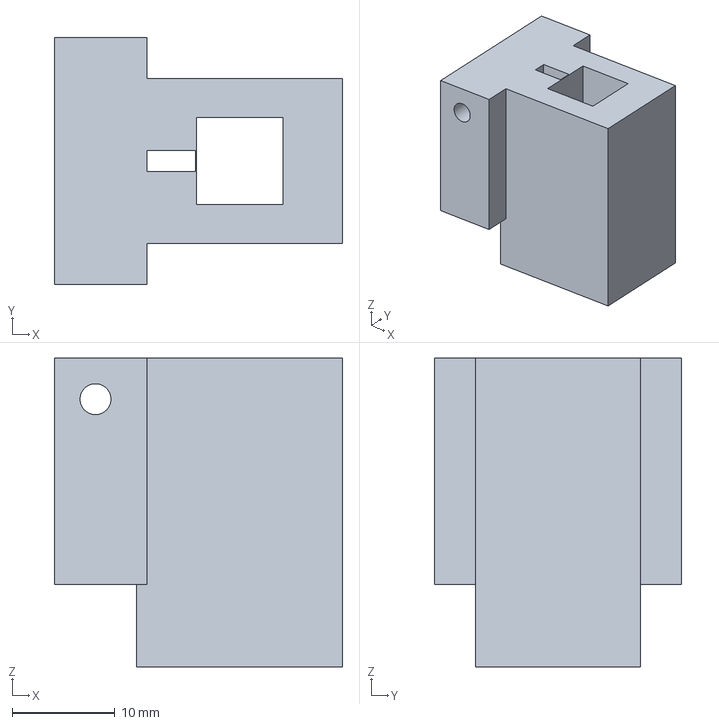
[picture p41: CAD file, 2026-06-27]
scale_down/print_pack/phase2/sliced_p1s/wire_saddle_x1.gcode.3mf
28.0 x 24.0 x 30.0 mm
