AdithyaKesanJayakanth/PLE-SBS-Capstone/scale_down/stl_phase2/arm_bracket_x1.stl

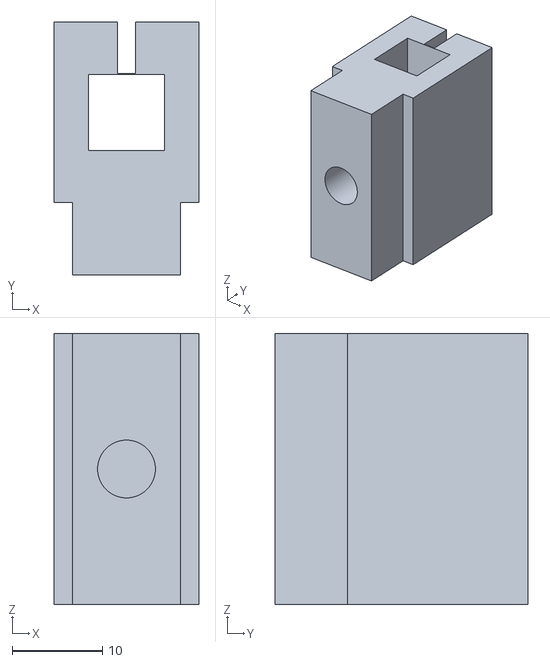
[picture p42: CAD file, 2026-06-27]
scale_down/stl_phase2/arm_bracket_x1.stl
16.0 x 28.0 x 30.0
