AdithyaKesanJayakanth/PLE-SBS-Capstone/cad/stl/magnet_channel_150mm_x4.stl

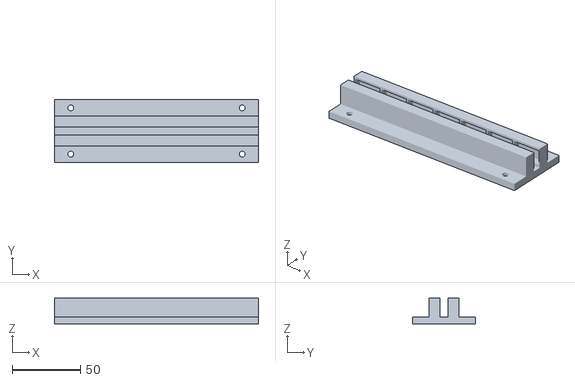
[picture p43: CAD file, 2026-06-14]
cad/stl/magnet_channel_150mm_x4.stl
150.0 x 46.0 x 19.0
