AdithyaKesanJayakanth/PLE-SBS-Capstone/scale_down/print_pack/phase1/reprint_v2/set1/sliced_p1s/trolley_plate_x6.gcode.3mf

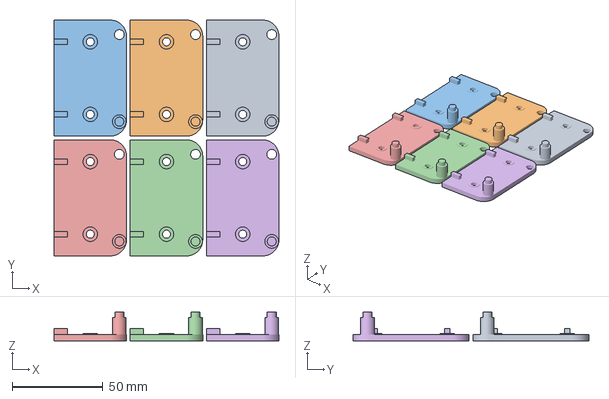
[picture p44: CAD file, 2026-07-03]
scale_down/print_pack/phase1/reprint_v2/set1/sliced_p1s/trolley_plate_x6.gcode.3mf
124.0 x 130.0 x 15.8 mm
trolley_plate_x6.stl x 6
