AdithyaKesanJayakanth/PLE-SBS-Capstone/scale_down/print_pack/phase1/reprint_v2/set1/stl/pannier_x6.stl

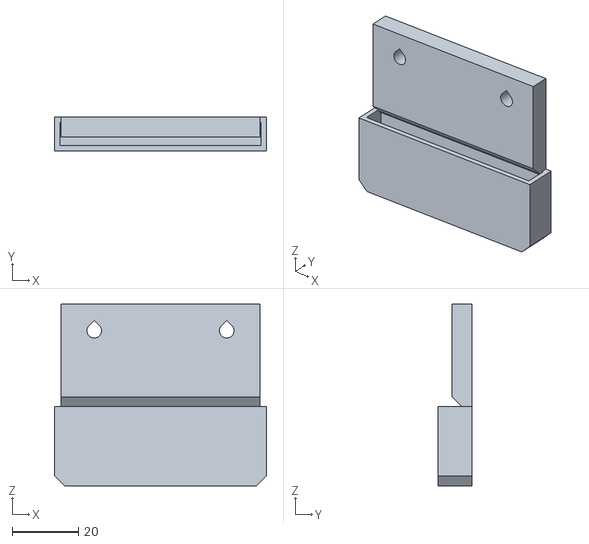
[picture p45: CAD file, 2026-07-03]
scale_down/print_pack/phase1/reprint_v2/set1/stl/pannier_x6.stl
64.0 x 10.2 x 54.8
