AdithyaKesanJayakanth/PLE-SBS-Capstone/scale_down/print_pack/phase1/reprint_v2/set2/sliced_p1s/sled_x3.gcode.3mf

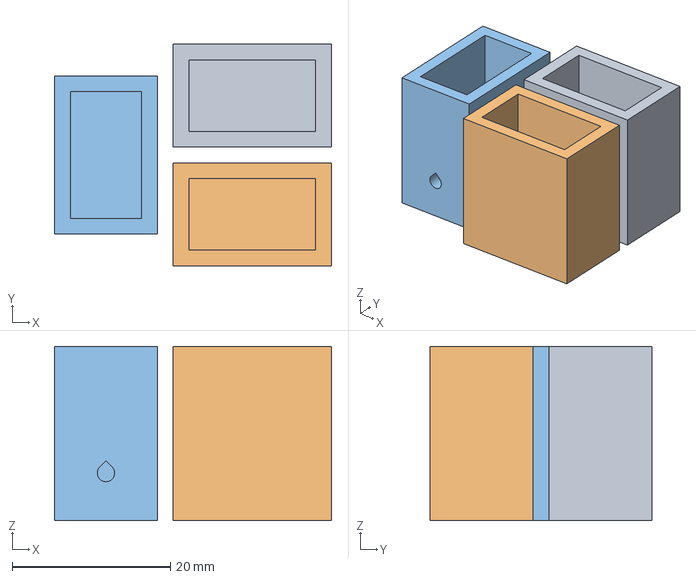
[picture p46: CAD file, 2026-07-03]
scale_down/print_pack/phase1/reprint_v2/set2/sliced_p1s/sled_x3.gcode.3mf
35.0 x 28.0 x 22.0 mm
sled_x3.stl x 3
