AdithyaKesanJayakanth/PLE-SBS-Capstone/scale_down/print_pack/phase1/sliced_p1s/fit_coupon_x1.gcode.3mf

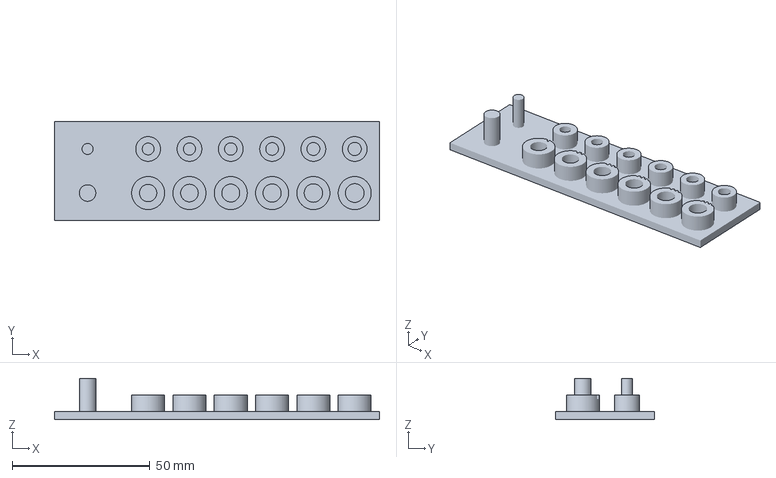
[picture p48: CAD file, 2026-06-30]
scale_down/print_pack/phase1/sliced_p1s/fit_coupon_x1.gcode.3mf
118.0 x 36.0 x 15.0 mm
