AdithyaKesanJayakanth/PLE-SBS-Capstone/scale_down/print_pack/phase1/stl/wheel_x6.stl

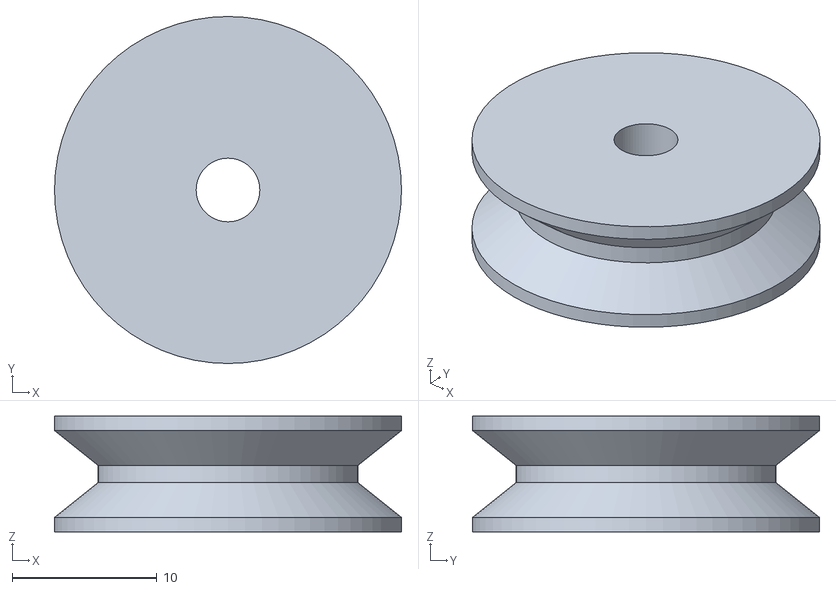
[picture p49: CAD file, 2026-06-29]
scale_down/print_pack/phase1/stl/wheel_x6.stl
24.0 x 24.0 x 8.00
