AdithyaKesanJayakanth/PLE-SBS-Capstone/cad/stl/basket_x2.stl

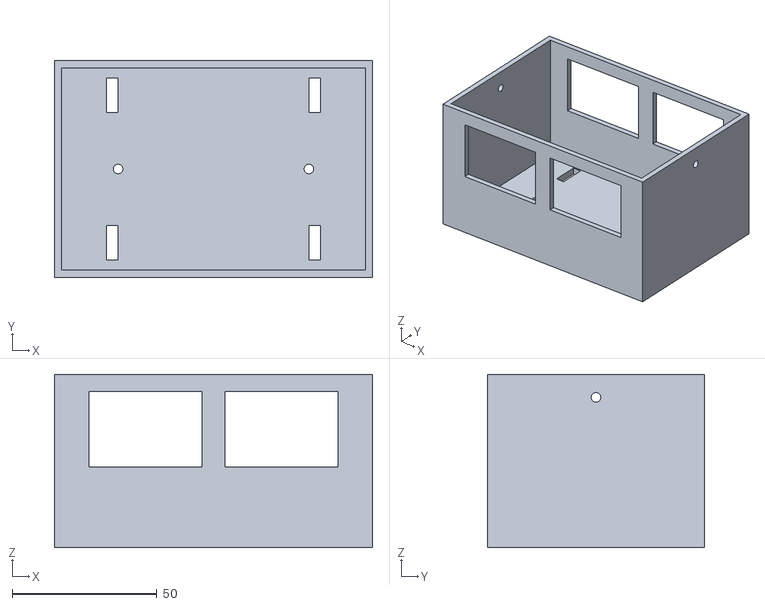
[picture p50: CAD file, 2026-06-14]
cad/stl/basket_x2.stl
110.0 x 75.0 x 60.0
