AdithyaKesanJayakanth/PLE-SBS-Capstone/scale_down/print_pack/phase1/reprint_v2/set1/sliced_p1s/turnout_base_x1.gcode.3mf

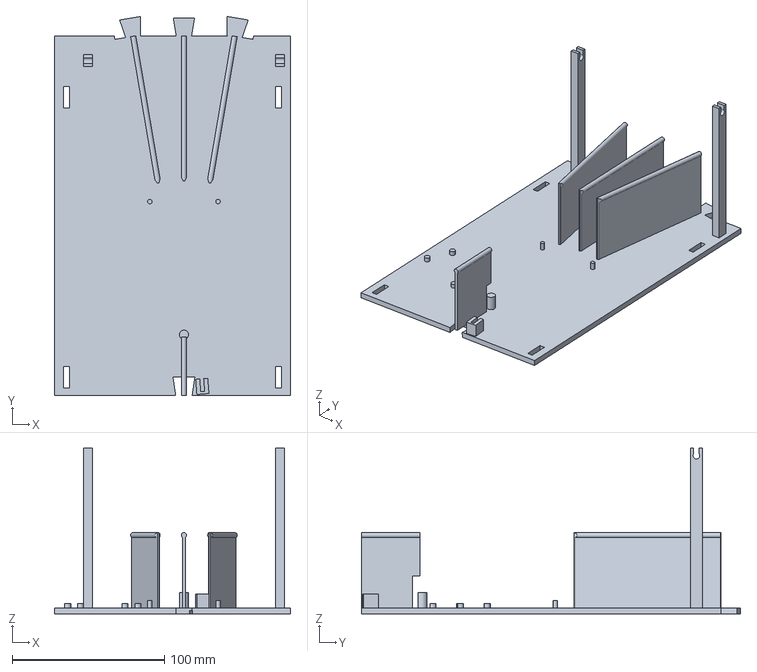
[picture p51: CAD file, 2026-07-03]
scale_down/print_pack/phase1/reprint_v2/set1/sliced_p1s/turnout_base_x1.gcode.3mf
155.0 x 249.0 x 109.0 mm
