AdithyaKesanJayakanth/PLE-SBS-Capstone/scale_down/print_pack/phase1/reprint_v2/set1/stl/flap_x1.stl

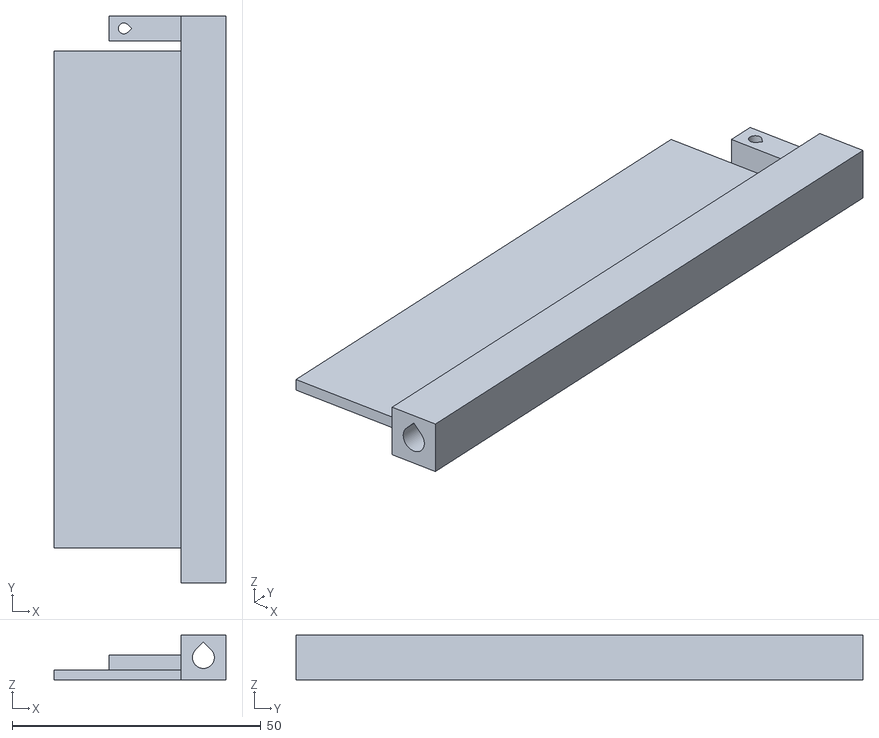
[picture p52: CAD file, 2026-07-03]
scale_down/print_pack/phase1/reprint_v2/set1/stl/flap_x1.stl
34.5 x 114.0 x 9.00
