AdithyaKesanJayakanth/PLE-SBS-Capstone/scale_down/print_pack/phase1/reprint_v2/set2/sliced_p1s/start_gate_x1.gcode.3mf

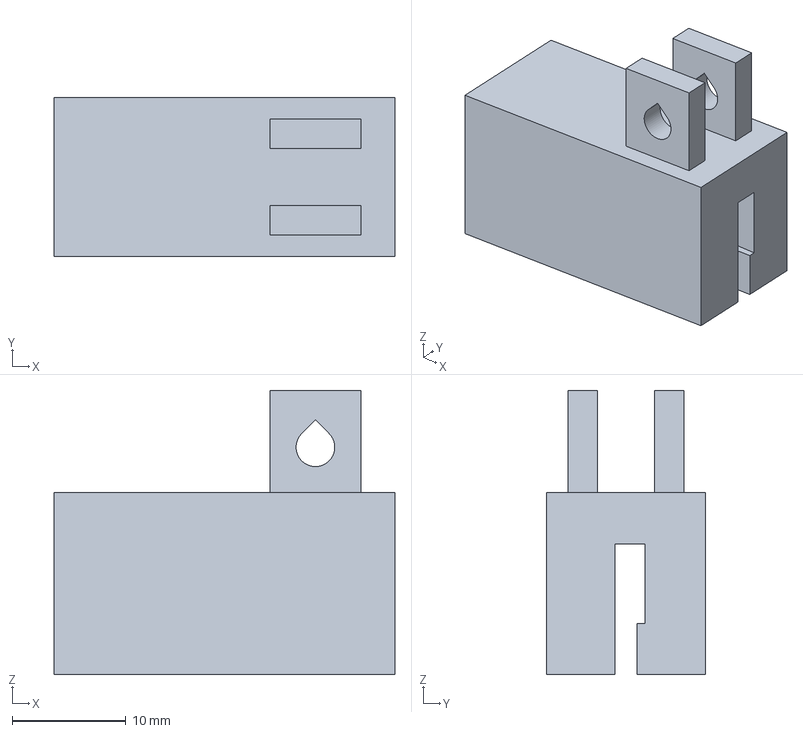
[picture p53: CAD file, 2026-07-03]
scale_down/print_pack/phase1/reprint_v2/set2/sliced_p1s/start_gate_x1.gcode.3mf
30.0 x 14.0 x 25.0 mm
