AdithyaKesanJayakanth/PLE-SBS-Capstone/scale_down/print_pack/phase1/reprint_v2/set2/stl/sled_x3.stl

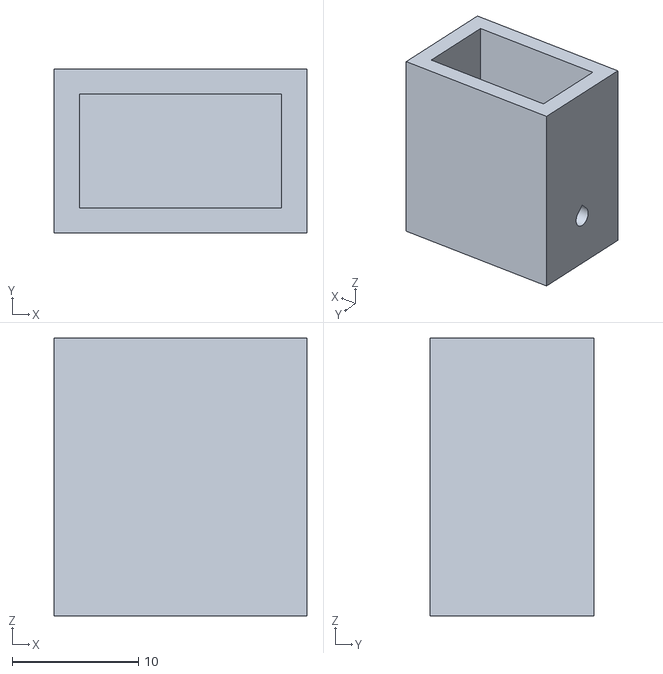
[picture p54: CAD file, 2026-07-02]
scale_down/print_pack/phase1/reprint_v2/set2/stl/sled_x3.stl
20.0 x 13.0 x 22.0
