AdithyaKesanJayakanth/PLE-SBS-Capstone/scale_down/print_pack/phase1/sliced_p1s/chain_11_links_x3.gcode.3mf

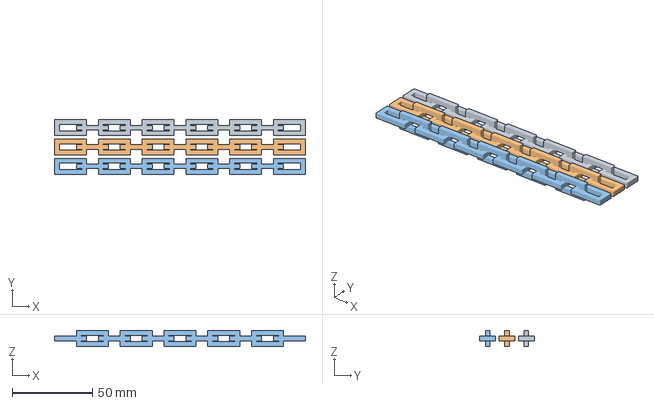
[picture p55: CAD file, 2026-06-30]
scale_down/print_pack/phase1/sliced_p1s/chain_11_links_x3.gcode.3mf
156.0 x 34.0 x 10.0 mm
chain_11_links_x3.stl x 3
