AdithyaKesanJayakanth/PLE-SBS-Capstone/scale_down/print_pack/phase1/stl/gate_pin_x1.stl

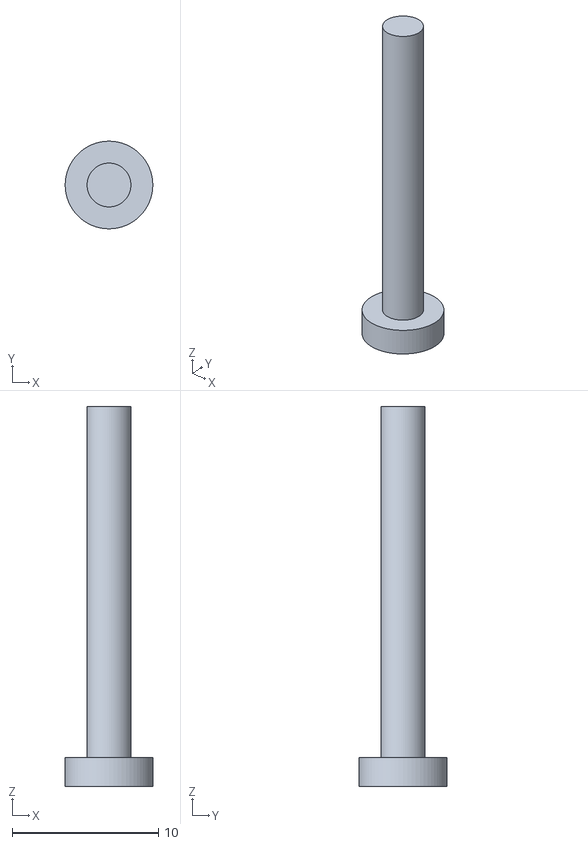
[picture p56: CAD file, 2026-06-29]
scale_down/print_pack/phase1/stl/gate_pin_x1.stl
6.00 x 6.00 x 26.0
