AdithyaKesanJayakanth/PLE-SBS-Capstone/scale_down/print_pack/phase2/sliced_p1s/tower_crown_x1.gcode.3mf

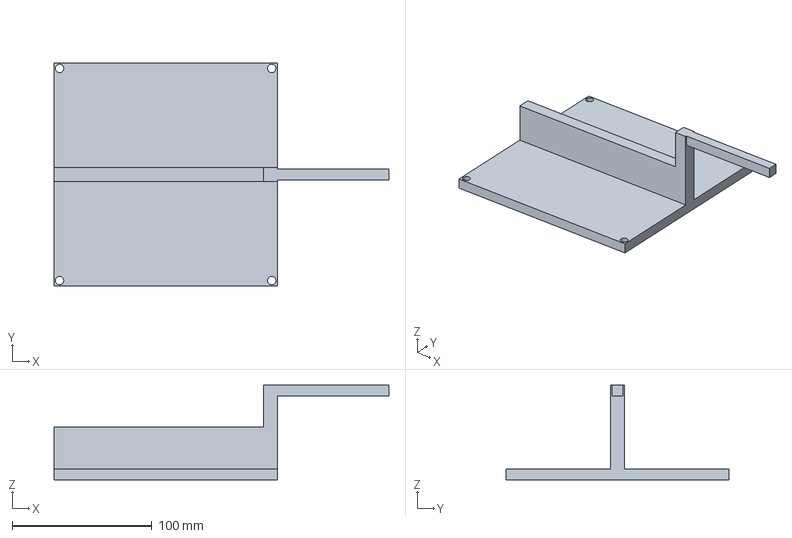
[picture p57: CAD file, 2026-06-27]
scale_down/print_pack/phase2/sliced_p1s/tower_crown_x1.gcode.3mf
240.0 x 160.0 x 68.0 mm
