AdithyaKesanJayakanth/PLE-SBS-Capstone/scale_down/print_pack/phase2/stl/capsule_x1.stl

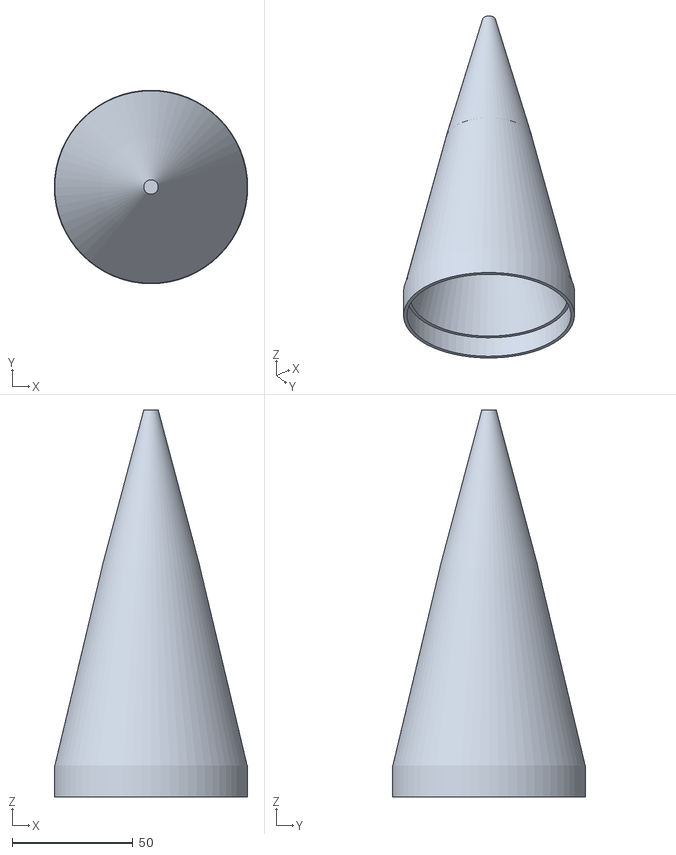
[picture p58: CAD file, 2026-06-27]
scale_down/print_pack/phase2/stl/capsule_x1.stl
80.0 x 80.0 x 160.0
