AdithyaKesanJayakanth/PLE-SBS-Capstone/scale_down/stl_phase2/tower_section_x4.stl

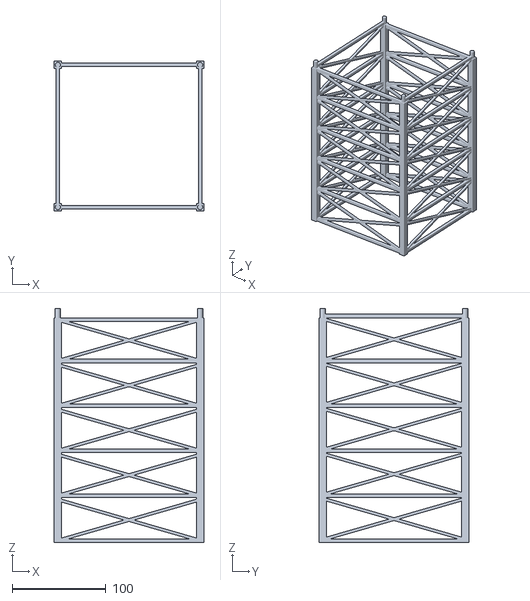
[picture p59: CAD file, 2026-06-27]
scale_down/stl_phase2/tower_section_x4.stl
160.0 x 160.0 x 250.0
