AdithyaKesanJayakanth/PLE-SBS-Capstone/cad/stl/trolley_plate_x4.stl

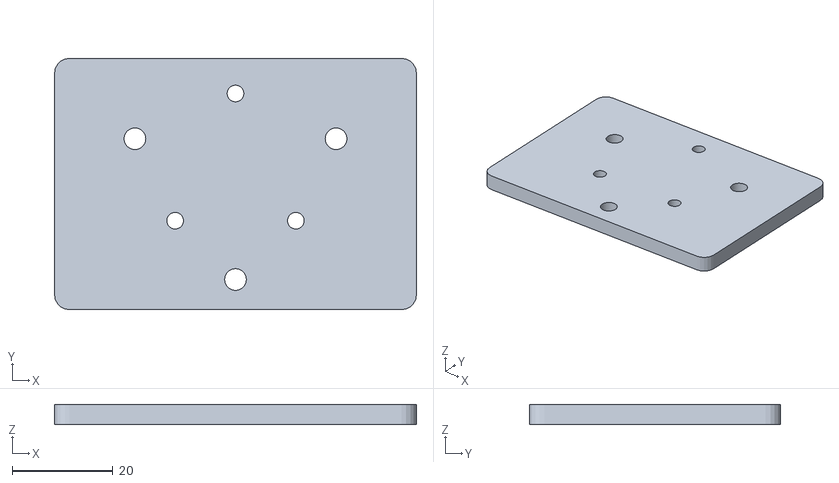
[picture p60: CAD file, 2026-06-14]
cad/stl/trolley_plate_x4.stl
72.0 x 50.0 x 4.00
