AdithyaKesanJayakanth/PLE-SBS-Capstone/scale_down/print_pack/phase1/sliced_p1s/wedge_x1.gcode.3mf

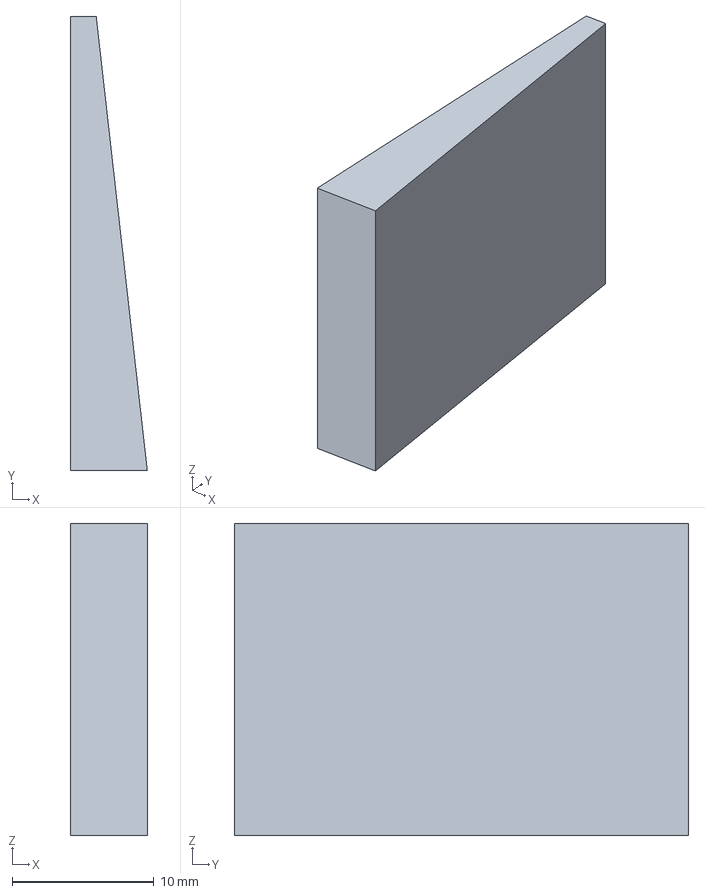
[picture p62: CAD file, 2026-06-30]
scale_down/print_pack/phase1/sliced_p1s/wedge_x1.gcode.3mf
5.40 x 32.0 x 22.0 mm
