AdithyaKesanJayakanth/PLE-SBS-Capstone/scale_down/print_pack/phase2/sliced_p1s/launch_mount_x1.gcode.3mf

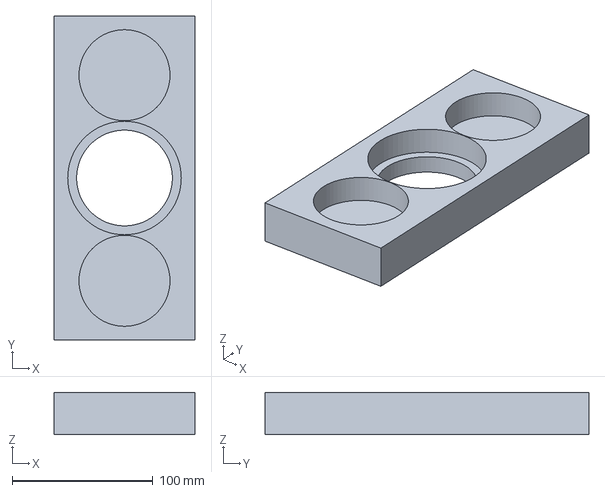
[picture p63: CAD file, 2026-06-27]
scale_down/print_pack/phase2/sliced_p1s/launch_mount_x1.gcode.3mf
100.0 x 230.0 x 30.0 mm
