AdithyaKesanJayakanth/PLE-SBS-Capstone/scale_down/stl/chain_11_links_x3.stl

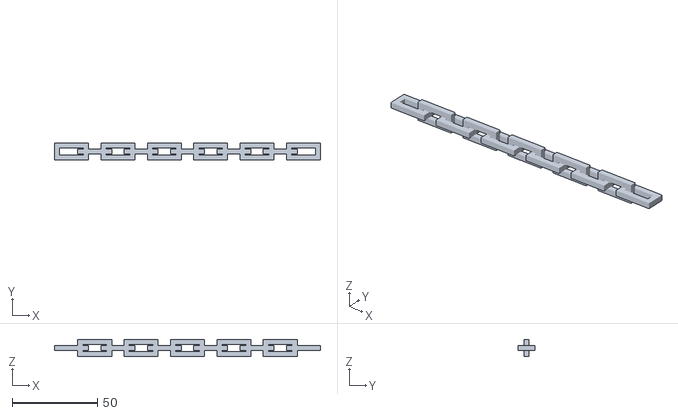
[picture p64: CAD file, 2026-06-27]
scale_down/stl/chain_11_links_x3.stl
156.0 x 10.0 x 10.0
