AdithyaKesanJayakanth/PLE-SBS-Capstone/scale_down/stl_phase2/booster_lower_x2.stl

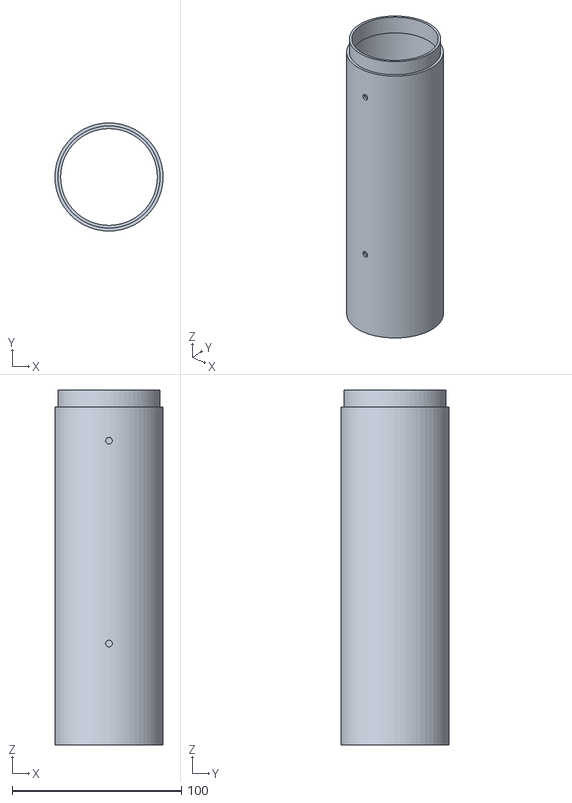
[picture p65: CAD file, 2026-06-27]
scale_down/stl_phase2/booster_lower_x2.stl
64.0 x 64.0 x 210.0
