AdithyaKesanJayakanth/PLE-SBS-Capstone/cad/stl/start_gate_x1.stl

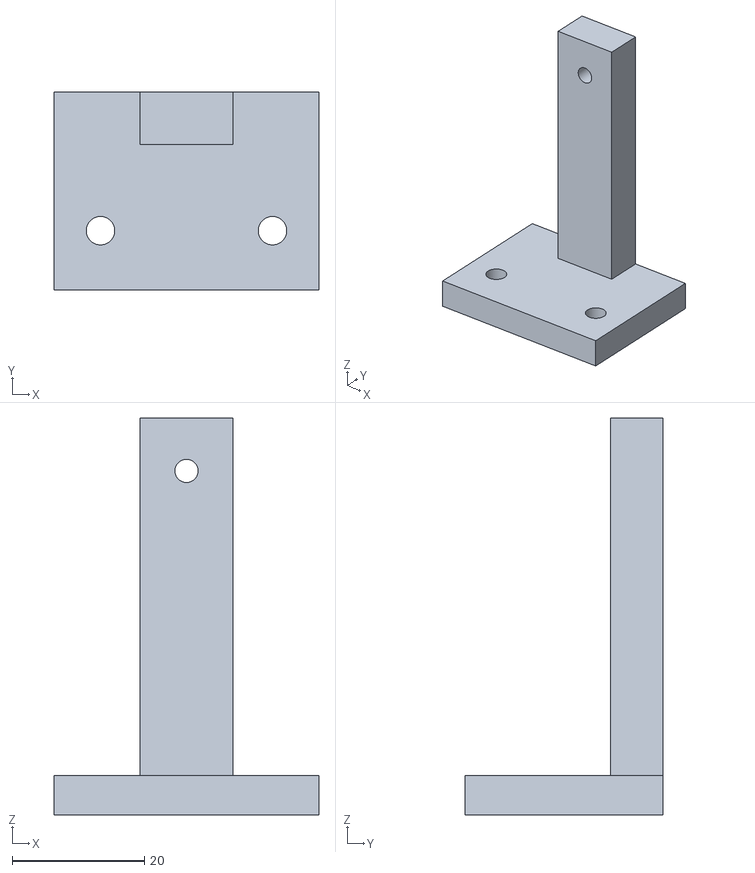
[picture p66: CAD file, 2026-06-14]
cad/stl/start_gate_x1.stl
40.0 x 30.0 x 60.0
