AdithyaKesanJayakanth/PLE-SBS-Capstone/scale_down/print_pack/phase1/reprint_v2/set1/sliced_p1s/pannier_x6.gcode.3mf

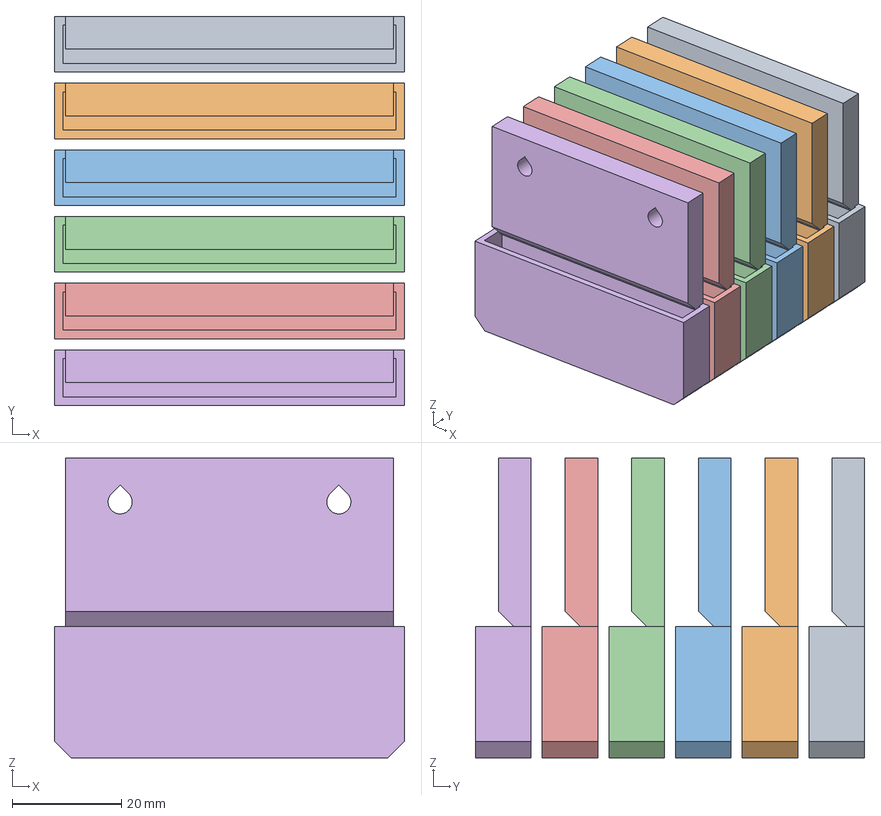
[picture p67: CAD file, 2026-07-03]
scale_down/print_pack/phase1/reprint_v2/set1/sliced_p1s/pannier_x6.gcode.3mf
64.0 x 71.2 x 54.8 mm
pannier_x6.stl x 6
