AdithyaKesanJayakanth/PLE-SBS-Capstone/scale_down/print_pack/phase1/reprint_v2/set1/stl/rocker_bridge_x1.stl

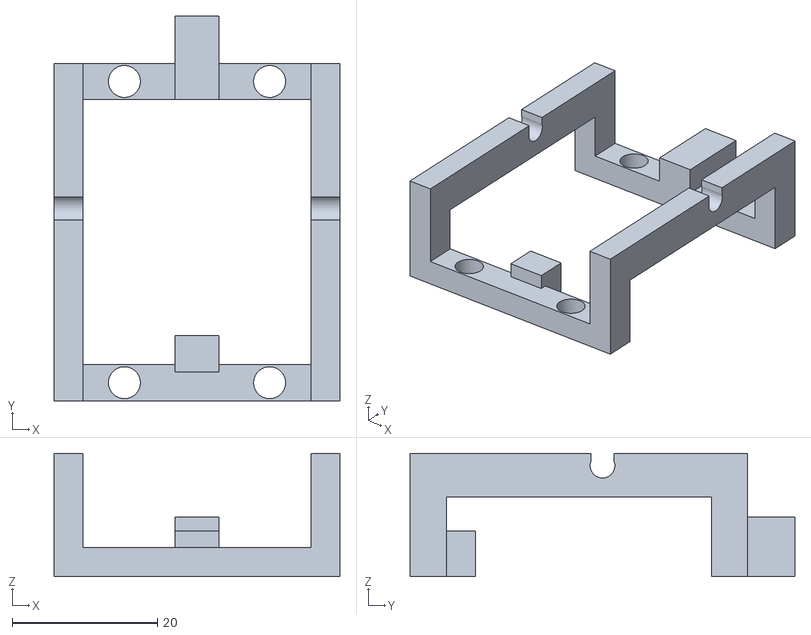
[picture p68: CAD file, 2026-07-03]
scale_down/print_pack/phase1/reprint_v2/set1/stl/rocker_bridge_x1.stl
39.4 x 53.0 x 17.0
