AdithyaKesanJayakanth/PLE-SBS-Capstone/scale_down/print_pack/phase1/reprint_v2/set2/stl/chain_bed_190_x3.stl

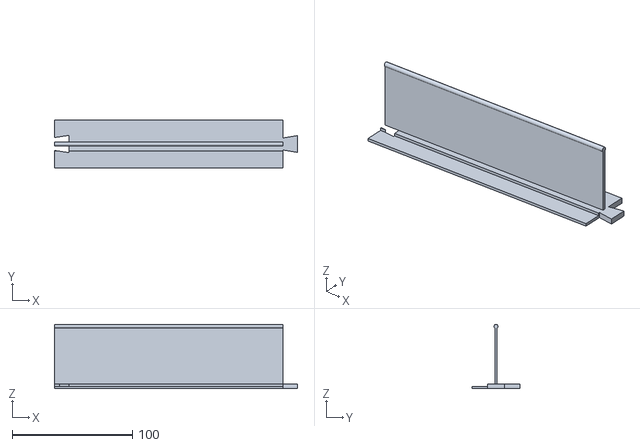
[picture p69: CAD file, 2026-07-02]
scale_down/print_pack/phase1/reprint_v2/set2/stl/chain_bed_190_x3.stl
202.0 x 40.0 x 53.5
