AdithyaKesanJayakanth/PLE-SBS-Capstone/scale_down/print_pack/phase1/sliced_p1s/lead_rail_230_x3.gcode.3mf

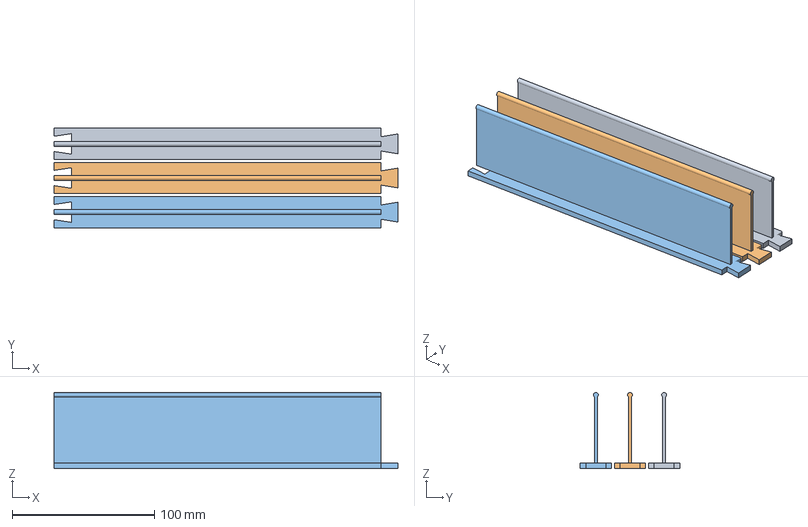
[picture p70: CAD file, 2026-06-30]
scale_down/print_pack/phase1/sliced_p1s/lead_rail_230_x3.gcode.3mf
242.0 x 70.0 x 53.5 mm
lead_rail_230_x3.stl x 3
