AdithyaKesanJayakanth/PLE-SBS-Capstone/scale_down/print_pack/phase2/sliced_p1s/platform_tile_x4.gcode.3mf

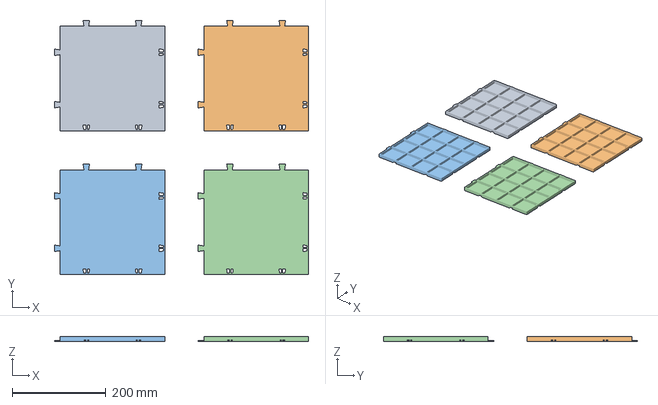
[picture p71: CAD file, 2026-06-27]
scale_down/print_pack/phase2/sliced_p1s/platform_tile_x4.gcode.3mf
543.2 x 543.2 x 10.0 mm
platform_tile_x4.stl x 4
