AdithyaKesanJayakanth/PLE-SBS-Capstone/cad/stl/hanger_x2.stl

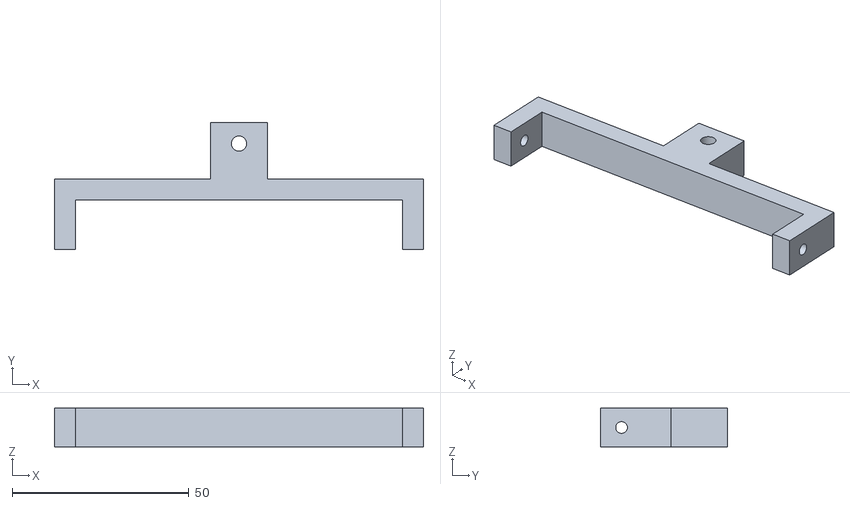
[picture p72: CAD file, 2026-06-14]
cad/stl/hanger_x2.stl
104.4 x 36.0 x 11.0
