AdithyaKesanJayakanth/PLE-SBS-Capstone/scale_down/print_pack/phase1/reprint_v2/set1/sliced_p1s/rocker_x1.gcode.3mf

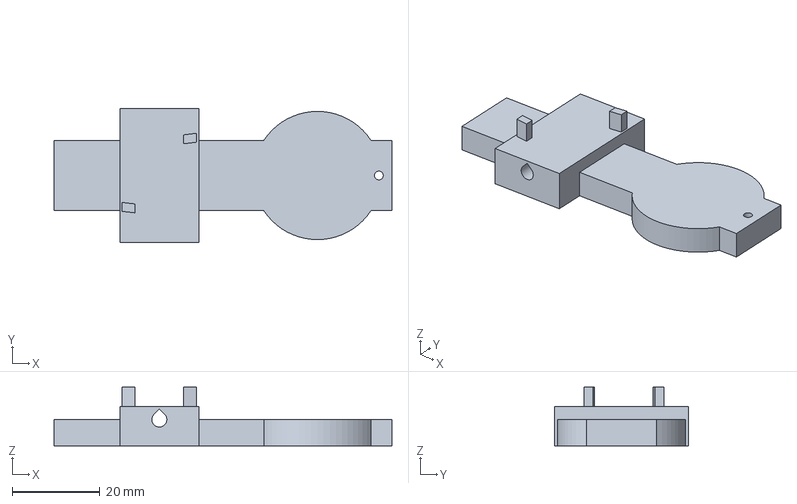
[picture p73: CAD file, 2026-07-03]
scale_down/print_pack/phase1/reprint_v2/set1/sliced_p1s/rocker_x1.gcode.3mf
77.0 x 30.6 x 13.4 mm
