AdithyaKesanJayakanth/PLE-SBS-Capstone/scale_down/print_pack/phase1/reprint_v2/set1/stl/trolley_plate_x6.stl

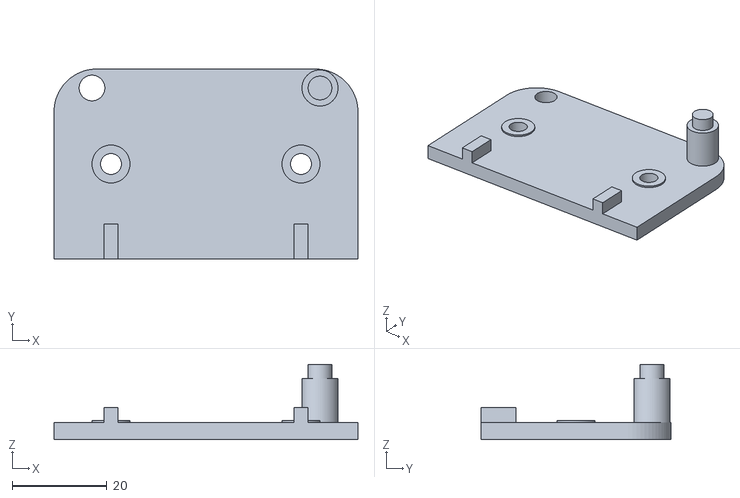
[picture p74: CAD file, 2026-07-03]
scale_down/print_pack/phase1/reprint_v2/set1/stl/trolley_plate_x6.stl
64.0 x 40.0 x 15.8
