AdithyaKesanJayakanth/PLE-SBS-Capstone/scale_down/print_pack/phase1/reprint_v2/set2/sliced_p1s/bumper_x3.gcode.3mf

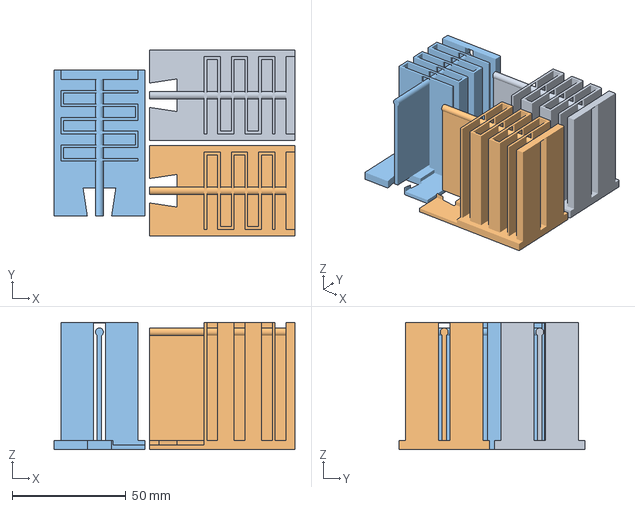
[picture p75: CAD file, 2026-06-30]
scale_down/print_pack/phase1/reprint_v2/set2/sliced_p1s/bumper_x3.gcode.3mf
106.0 x 82.0 x 56.0 mm
bumper_x3.stl x 3
