AdithyaKesanJayakanth/PLE-SBS-Capstone/scale_down/print_pack/phase1/reprint_v2/set2/stl/window_hook_x1.stl

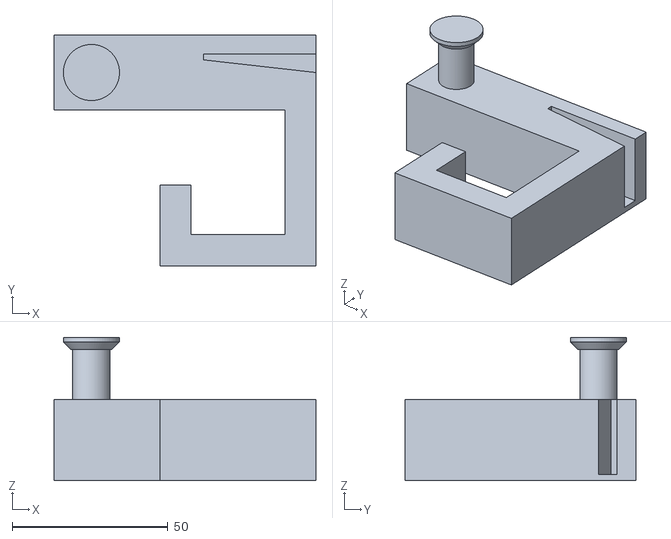
[picture p76: CAD file, 2026-06-29]
scale_down/print_pack/phase1/reprint_v2/set2/stl/window_hook_x1.stl
84.0 x 74.0 x 46.0
