AdithyaKesanJayakanth/PLE-SBS-Capstone/scale_down/print_pack/phase1/sliced_p1s/wheel_x6.gcode.3mf

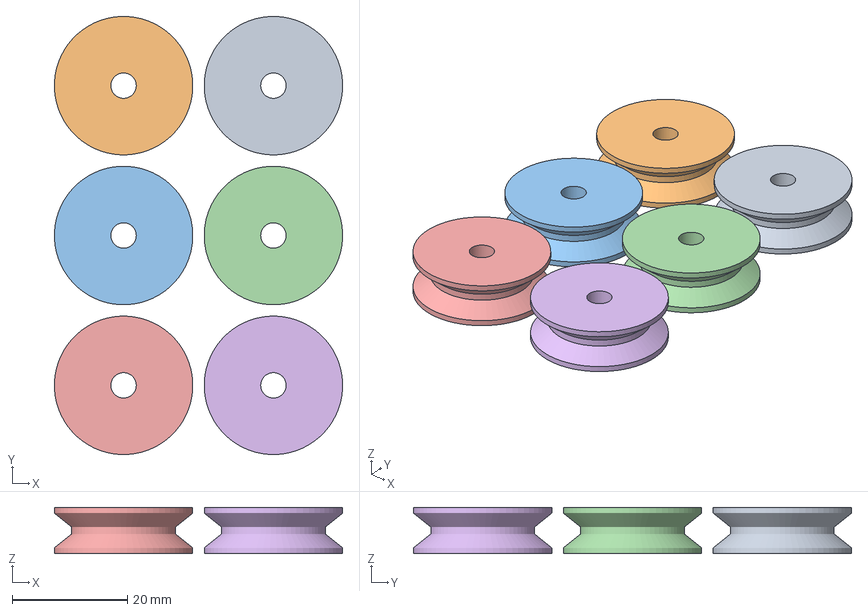
[picture p77: CAD file, 2026-06-30]
scale_down/print_pack/phase1/sliced_p1s/wheel_x6.gcode.3mf
49.9 x 75.9 x 8.00 mm
wheel_x6.stl x 6
