AdithyaKesanJayakanth/PLE-SBS-Capstone/scale_down/print_pack/phase2/sliced_p1s/booster_strut_x4.gcode.3mf

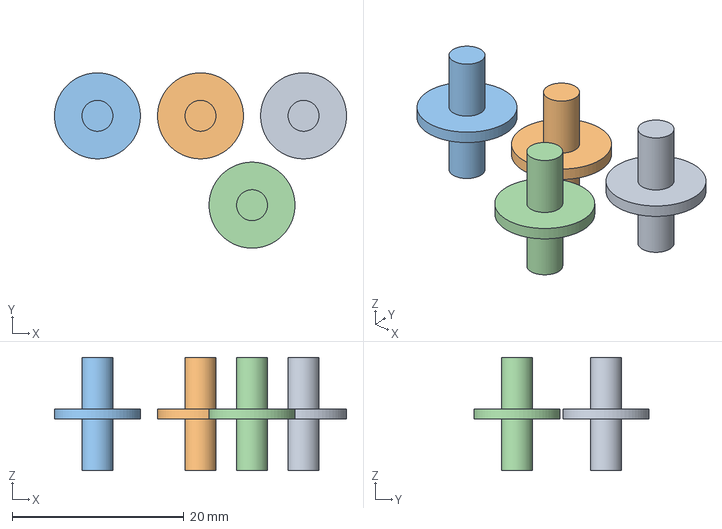
[picture p78: CAD file, 2026-06-27]
scale_down/print_pack/phase2/sliced_p1s/booster_strut_x4.gcode.3mf
34.0 x 20.4 x 13.2 mm
booster_strut_x4.stl x 4
