AdithyaKesanJayakanth/PLE-SBS-Capstone/scale_down/print_pack/phase2/stl/booster_strut_x4.stl

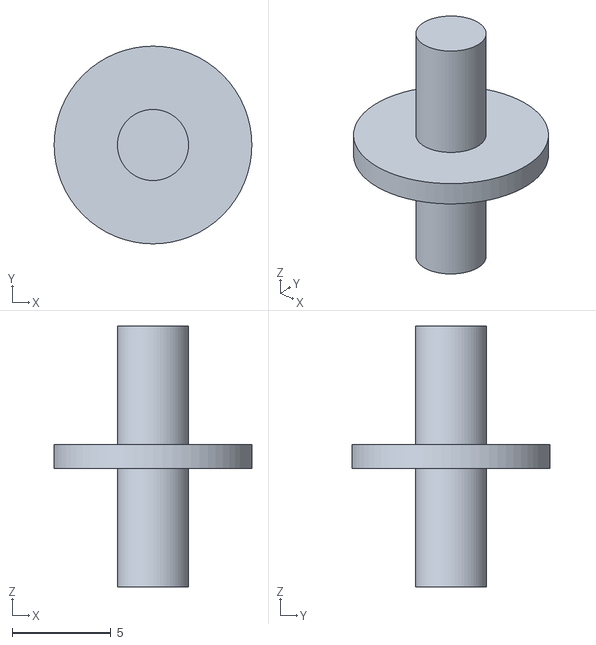
[picture p79: CAD file, 2026-06-27]
scale_down/print_pack/phase2/stl/booster_strut_x4.stl
10.0 x 10.0 x 13.2
