AdithyaKesanJayakanth/PLE-SBS-Capstone/cad/stl/start_pin_x2.stl

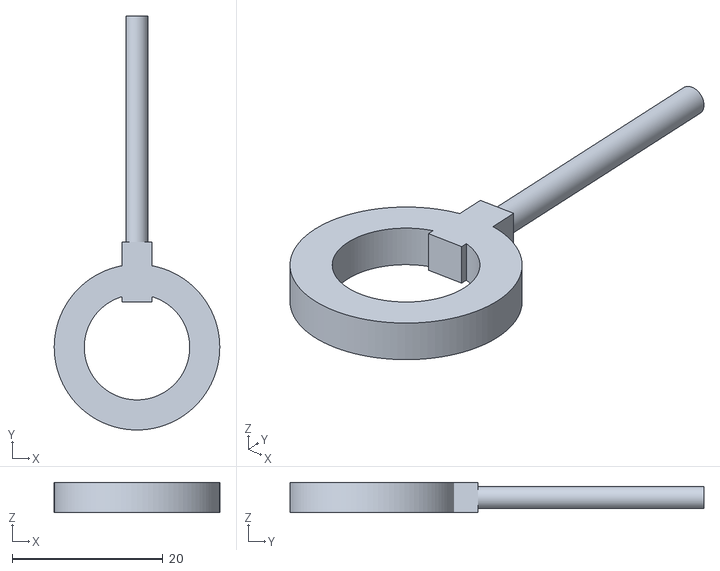
[picture p80: CAD file, 2026-06-14]
cad/stl/start_pin_x2.stl
22.0 x 55.0 x 4.00
