AdithyaKesanJayakanth/PLE-SBS-Capstone/scale_down/print_pack/phase1/reprint_v2/set1/sliced_p1s/axle_pin_x6.gcode.3mf

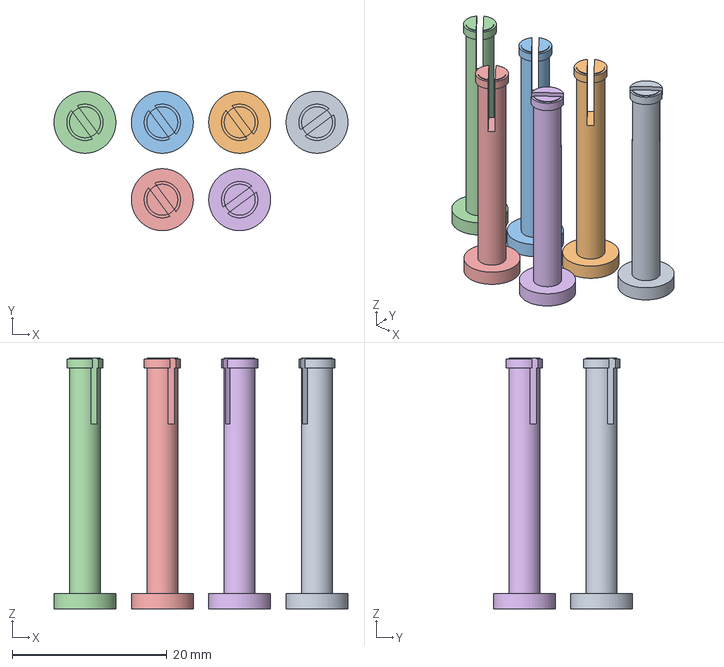
[picture p81: CAD file, 2026-07-03]
scale_down/print_pack/phase1/reprint_v2/set1/sliced_p1s/axle_pin_x6.gcode.3mf
38.0 x 18.0 x 32.4 mm
axle_pin_x6.stl x 6
