AdithyaKesanJayakanth/PLE-SBS-Capstone/scale_down/print_pack/phase1/reprint_v2/set2/stl/bumper_x3.stl

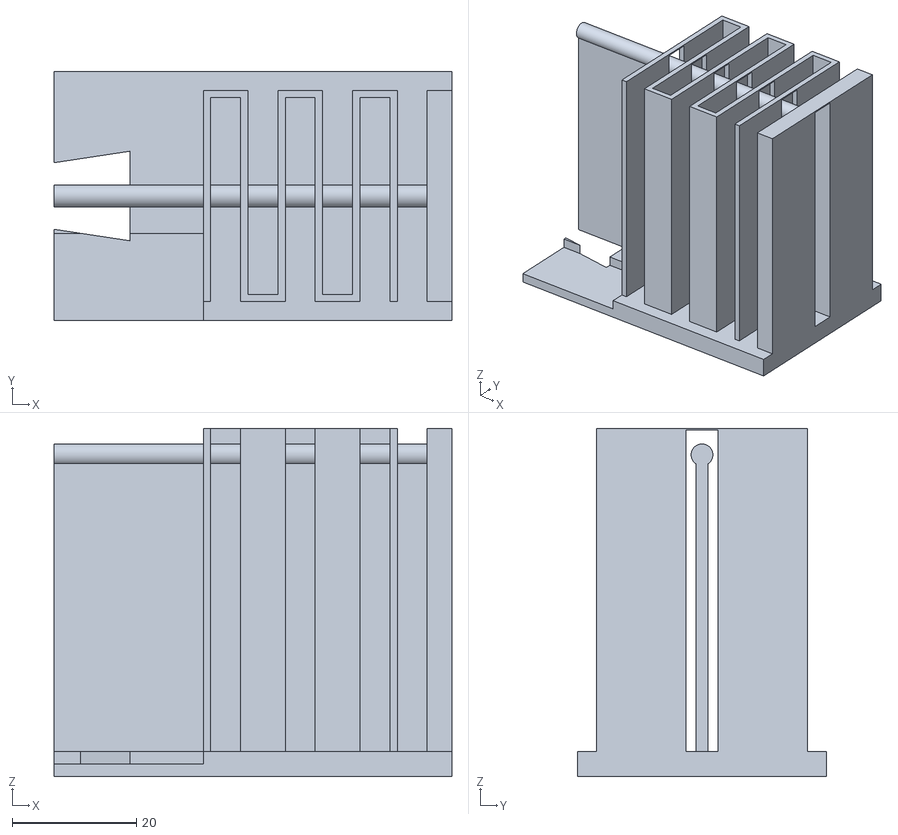
[picture p82: CAD file, 2026-06-29]
scale_down/print_pack/phase1/reprint_v2/set2/stl/bumper_x3.stl
64.0 x 40.0 x 56.0
