AdithyaKesanJayakanth/PLE-SBS-Capstone/scale_down/print_pack/phase2/sliced_p1s/booster_lower_x2.gcode.3mf

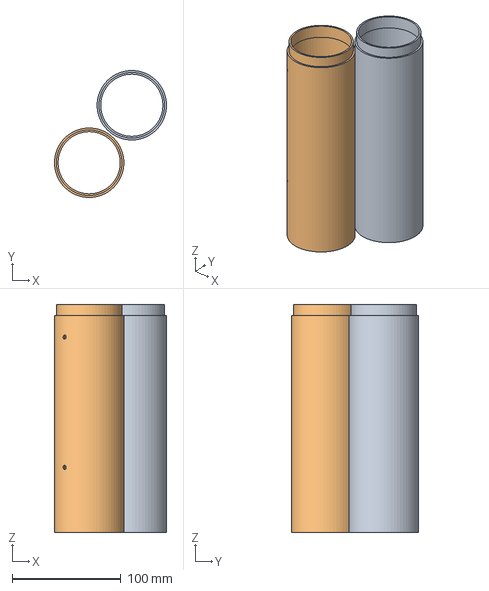
[picture p83: CAD file, 2026-06-27]
scale_down/print_pack/phase2/sliced_p1s/booster_lower_x2.gcode.3mf
103.3 x 117.0 x 210.0 mm
booster_lower_x2.stl x 2
