AdithyaKesanJayakanth/PLE-SBS-Capstone/scale_down/print_pack/phase2/stl/platform_tile_x4.stl

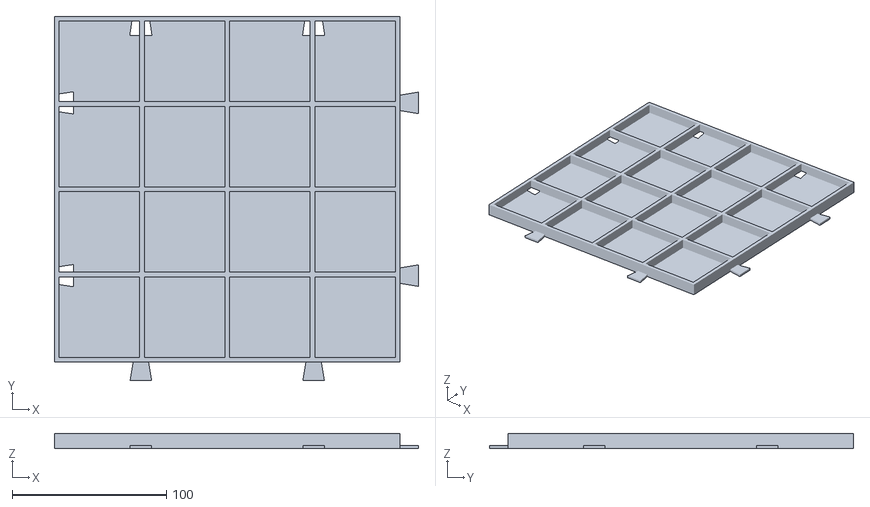
[picture p84: CAD file, 2026-06-27]
scale_down/print_pack/phase2/stl/platform_tile_x4.stl
236.0 x 236.0 x 10.0
