AdithyaKesanJayakanth/PLE-SBS-Capstone/cad/stl/wheel_x4.stl

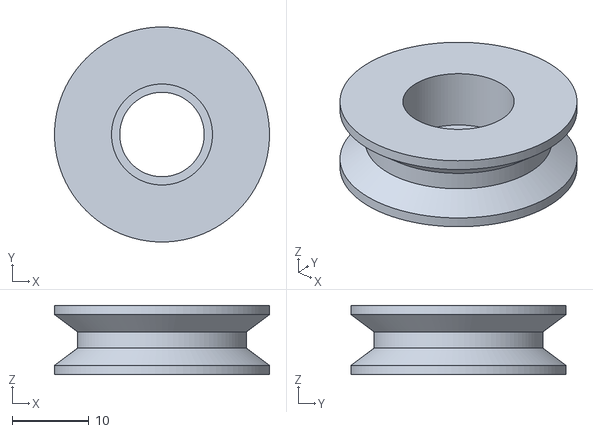
[picture p85: CAD file, 2026-06-14]
cad/stl/wheel_x4.stl
28.0 x 28.0 x 9.00
