AdithyaKesanJayakanth/PLE-SBS-Capstone/scale_down/print_pack/phase1/reprint_v2/set1/stl/axle_pin_x6.stl

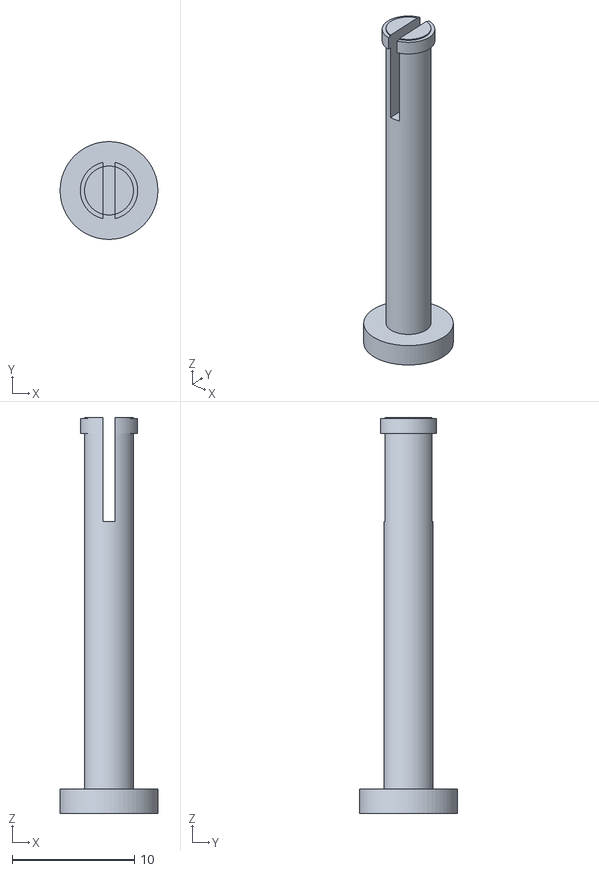
[picture p86: CAD file, 2026-07-03]
scale_down/print_pack/phase1/reprint_v2/set1/stl/axle_pin_x6.stl
8.00 x 8.00 x 32.4
