AdithyaKesanJayakanth/PLE-SBS-Capstone/scale_down/print_pack/phase2/sliced_p1s/access_arm_x1.gcode.3mf

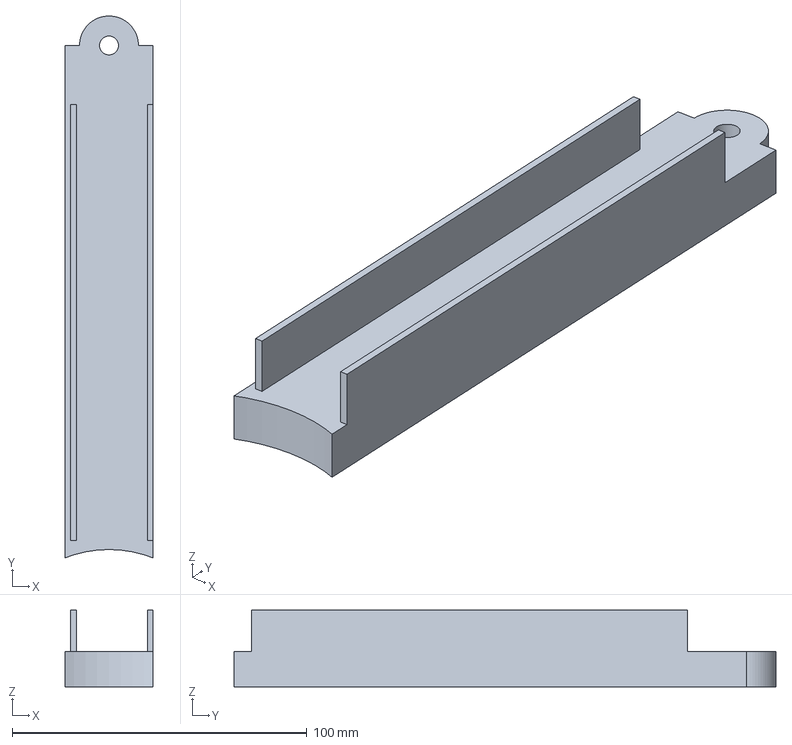
[picture p87: CAD file, 2026-06-27]
scale_down/print_pack/phase2/sliced_p1s/access_arm_x1.gcode.3mf
30.0 x 183.9 x 26.0 mm
