AdithyaKesanJayakanth/PLE-SBS-Capstone/cad/stl/fin_clamp_x2.stl

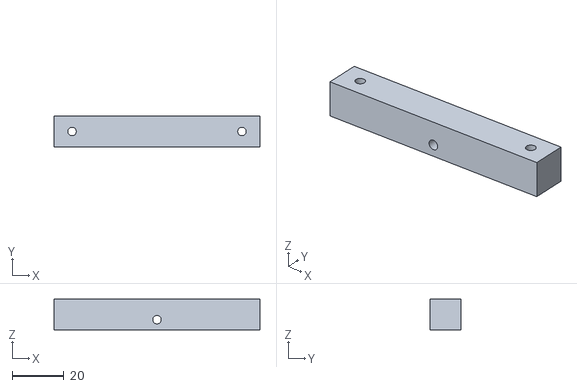
[picture p89: CAD file, 2026-06-14]
cad/stl/fin_clamp_x2.stl
80.0 x 12.0 x 12.0
