AdithyaKesanJayakanth/PLE-SBS-Capstone/scale_down/print_pack/phase1/reprint_v2/set1/sliced_p1s/handover_x1.gcode.3mf

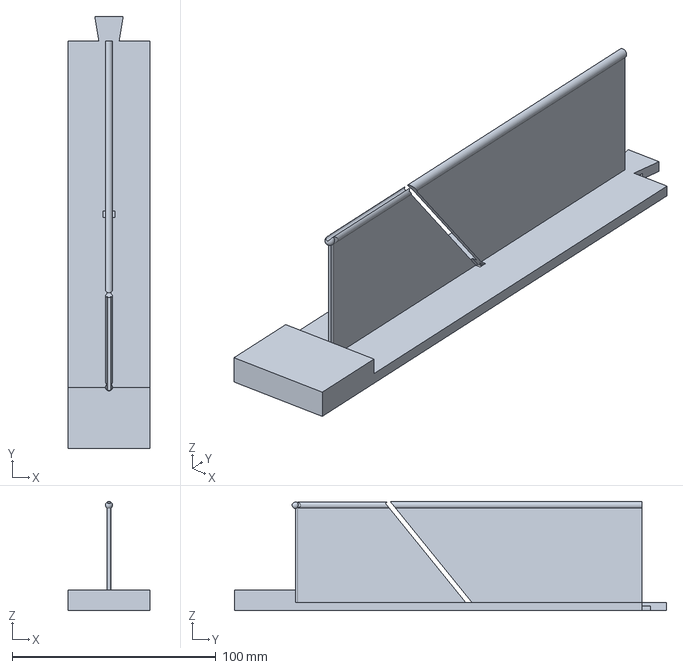
[picture p90: CAD file, 2026-06-30]
scale_down/print_pack/phase1/reprint_v2/set1/sliced_p1s/handover_x1.gcode.3mf
40.0 x 212.0 x 53.5 mm
