AdithyaKesanJayakanth/PLE-SBS-Capstone/scale_down/print_pack/phase1/reprint_v2/set1/stl/bias_spring_x1.stl

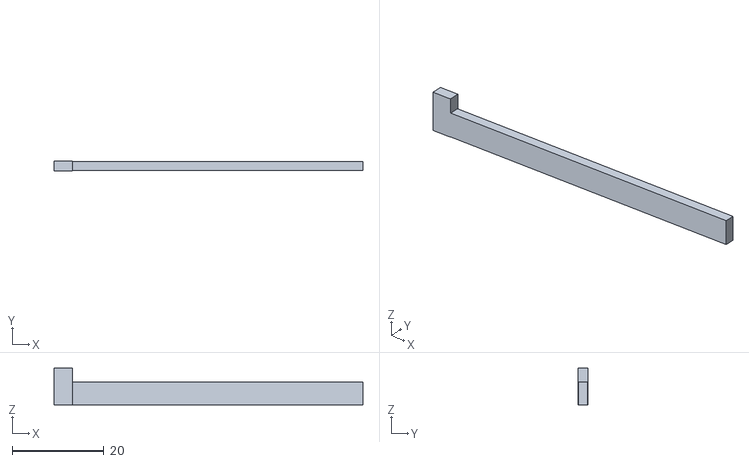
[picture p91: CAD file, 2026-06-29]
scale_down/print_pack/phase1/reprint_v2/set1/stl/bias_spring_x1.stl
67.4 x 2.20 x 8.00
