AdithyaKesanJayakanth/PLE-SBS-Capstone/scale_down/print_pack/phase1/reprint_v2/set1/sliced_p1s/gantry_axle_x1.gcode.3mf

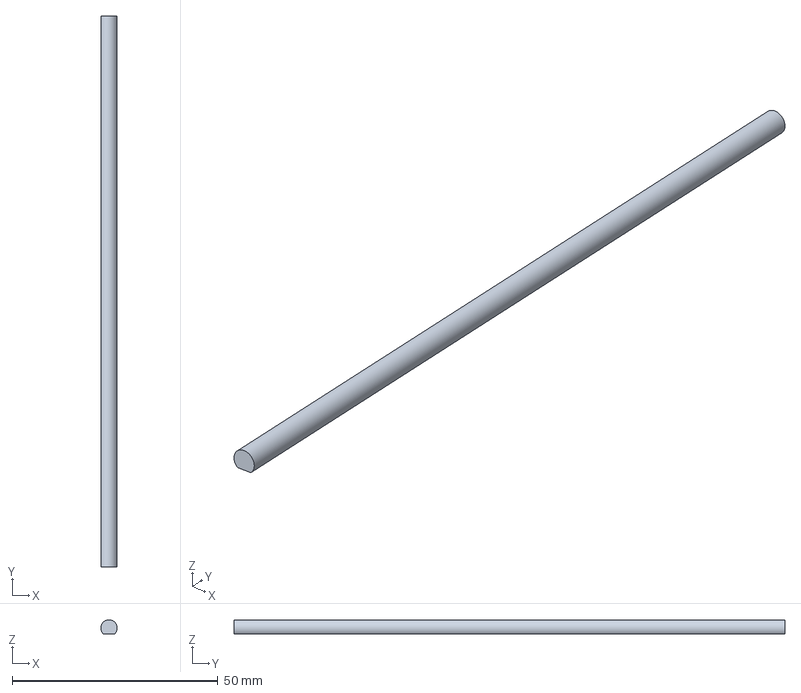
[picture p92: CAD file, 2026-06-30]
scale_down/print_pack/phase1/reprint_v2/set1/sliced_p1s/gantry_axle_x1.gcode.3mf
4.00 x 134.0 x 3.50 mm
