AdithyaKesanJayakanth/PLE-SBS-Capstone/scale_down/print_pack/phase2/sliced_p1s/arm_pin_x1.gcode.3mf

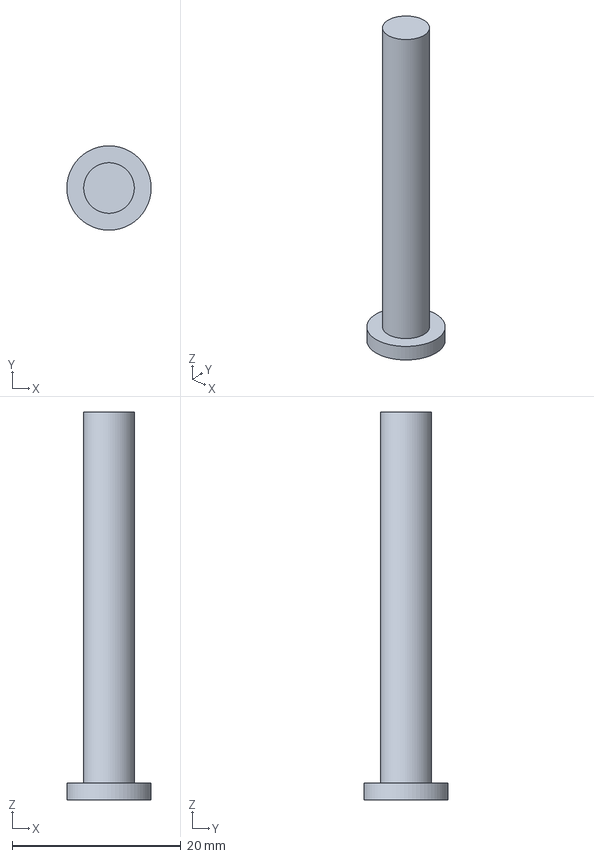
[picture p93: CAD file, 2026-06-27]
scale_down/print_pack/phase2/sliced_p1s/arm_pin_x1.gcode.3mf
9.99 x 9.99 x 46.0 mm
