AdithyaKesanJayakanth/PLE-SBS-Capstone/scale_down/print_pack/phase2/stl/core_segment_x4.stl

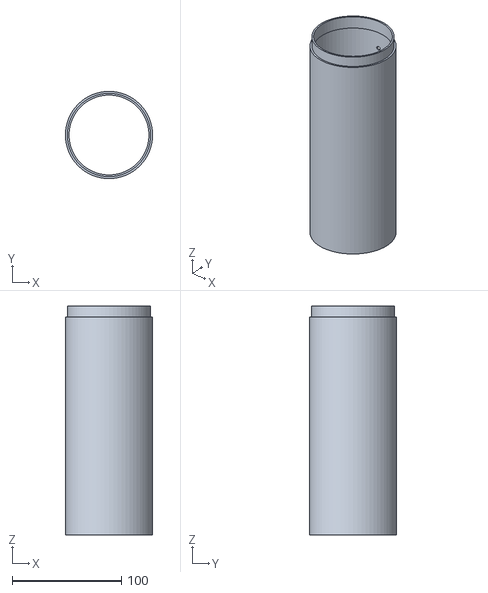
[picture p94: CAD file, 2026-06-27]
scale_down/print_pack/phase2/stl/core_segment_x4.stl
80.0 x 80.0 x 210.0
