AdithyaKesanJayakanth/PLE-SBS-Capstone/scale_down/print_pack/phase1/reprint_v2/set1/sliced_p1s/rocker_pin_x1.gcode.3mf

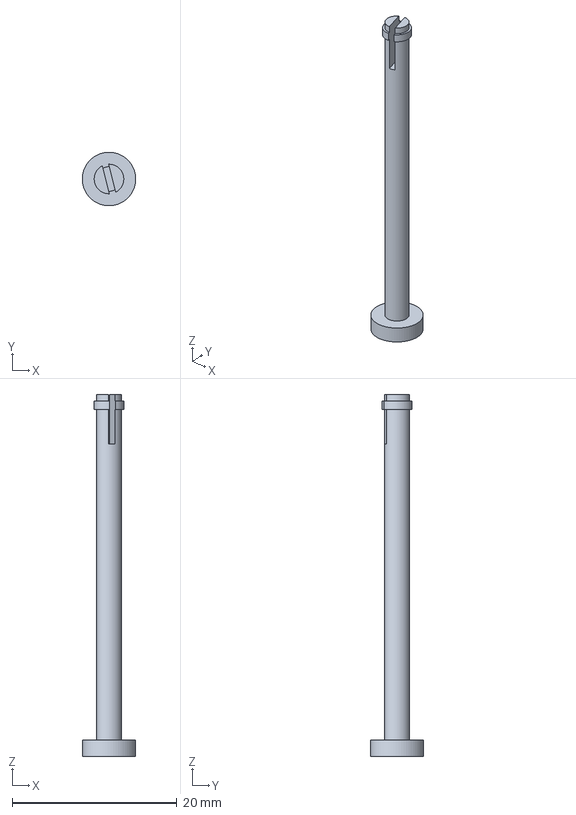
[picture p95: CAD file, 2026-06-30]
scale_down/print_pack/phase1/reprint_v2/set1/sliced_p1s/rocker_pin_x1.gcode.3mf
6.49 x 6.49 x 44.0 mm
