AdithyaKesanJayakanth/PLE-SBS-Capstone/scale_down/print_pack/phase2/sliced_p1s/core_segment_x4.gcode.3mf

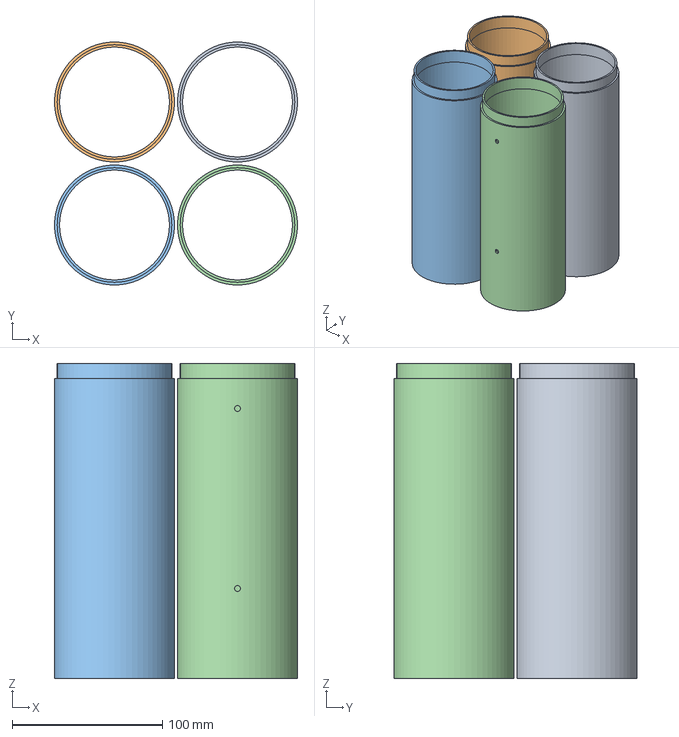
[picture p96: CAD file, 2026-06-27]
scale_down/print_pack/phase2/sliced_p1s/core_segment_x4.gcode.3mf
162.0 x 162.0 x 210.0 mm
core_segment_x4.stl x 4
