AdithyaKesanJayakanth/PLE-SBS-Capstone/scale_down/print_pack/phase2/sliced_p1s/booster_upper_x2.gcode.3mf

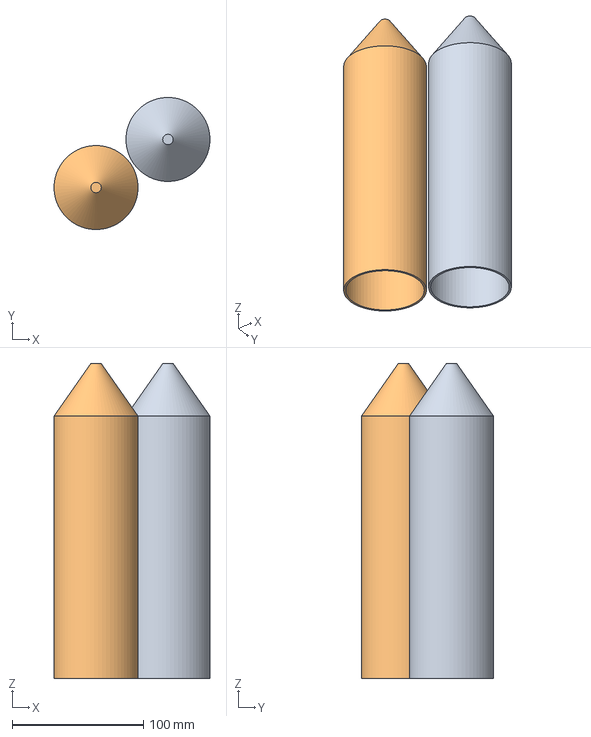
[picture p97: CAD file, 2026-06-27]
scale_down/print_pack/phase2/sliced_p1s/booster_upper_x2.gcode.3mf
118.7 x 100.5 x 240.0 mm
booster_upper_x2.stl x 2
