AdithyaKesanJayakanth/PLE-SBS-Capstone/scale_down/print_pack/phase2/sliced_p1s/tower_section_x4.gcode.3mf

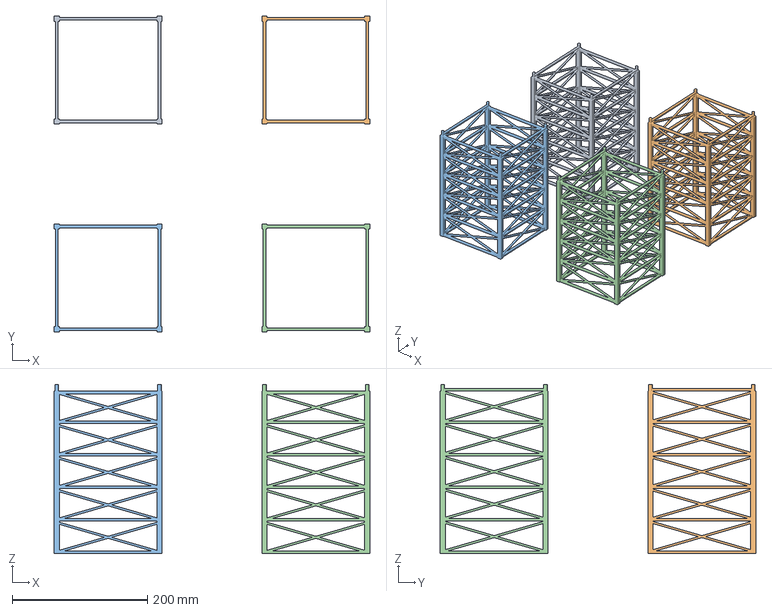
[picture p98: CAD file, 2026-06-27]
scale_down/print_pack/phase2/sliced_p1s/tower_section_x4.gcode.3mf
467.2 x 467.2 x 250.0 mm
tower_section_x4.stl x 4
