AdithyaKesanJayakanth/PLE-SBS-Capstone/(list of files, cad)

Other CAD files:
scale_down/print_pack/phase2/stl/wire_saddle_x1.stl
scale_down/print_pack/phase2/sliced_p1s/arm_bracket_x1.gcode.3mf
scale_down/print_pack/phase2/stl/arm_bracket_x1.stl
scale_down/stl_phase2/wire_saddle_x1.stl
scale_down/stl/fit_coupon_x1.stl
scale_down/print_pack/phase1/reprint_v2/set1/sliced_p1s/flap_x1.gcode.3mf
scale_down/print_pack/phase1/reprint_v2/set1/stl/turnout_base_x1.stl
scale_down/print_pack/phase1/reprint_v2/set2/stl/start_gate_x1.stl
scale_down/print_pack/phase1/stl/fit_coupon_x1.stl
scale_down/print_pack/phase2/stl/tower_crown_x1.stl
scale_down/print_pack/phase1/reprint_v2/set2/sliced_p1s/gate_lever_x1.gcode.3mf
scale_down/print_pack/phase2/stl/booster_lower_x2.stl
scale_down/stl_phase2/capsule_x1.stl
scale_down/print_pack/phase1/stl/wedge_x1.stl
scale_down/stl_phase2/tower_crown_x1.stl
scale_down/print_pack/phase1/reprint_v2/set1/stl/rocker_x1.stl
scale_down/print_pack/phase1/reprint_v2/set2/sliced_p1s/window_hook_x1.gcode.3mf
scale_down/print_pack/phase1/sliced_p1s/gate_pin_x1.gcode.3mf
scale_down/print_pack/phase1/stl/gate_key_x1.stl
scale_down/stl_phase2/platform_tile_x4.stl
scale_down/print_pack/phase1/reprint_v2/set1/sliced_p1s/rocker_bridge_x1.gcode.3mf
scale_down/print_pack/phase2/stl/access_arm_x1.stl
scale_down/print_pack/phase2/sliced_p1s/capsule_x1.gcode.3mf
scale_down/print_pack/phase2/stl/booster_upper_x2.stl
scale_down/stl_phase2/access_arm_x1.stl
scale_down/print_pack/phase1/reprint_v2/set1/stl/handover_x1.stl
scale_down/stl_phase2/core_segment_x4.stl
scale_down/print_pack/phase1/reprint_v2/set1/stl/rocker_pin_x1.stl
scale_down/print_pack/phase2/stl/arm_pin_x1.stl
scale_down/stl_phase2/booster_strut_x4.stl
scale_down/print_pack/phase1/reprint_v2/set1/sliced_p1s/bias_spring_x1.gcode.3mf
scale_down/print_pack/phase1/reprint_v2/set1/stl/gantry_axle_x1.stl
scale_down/print_pack/phase2/stl/launch_mount_x1.stl
scale_down/stl_phase2/launch_mount_x1.stl
scale_down/print_pack/phase2/stl/tower_section_x4.stl
scale_down/stl_phase2/arm_pin_x1.stl
