AdithyaKesanJayakanth/PLE-SBS-Capstone/scale_down/print_pack/README.md

# PLE-SBS print pack for the Bambu Lab P1S (0.4 mm nozzle)

Each phase folder has `stl/` (every part, already in its print orientation), `sheets/` (one PNG per part with front, side and top views and the bounding dimensions in mm) and `sliced_p1s/` (one `.gcode.3mf` per part, sliced with OrcaSlicer using the Bambu Lab P1S 0.4 nozzle profile, Bambu PLA Basic or PETG HF, with the quantity already arranged on the plate; open in Bambu Studio or send to the printer).
Grams and times are the slicer's own figures: filament volume times the filament's density, and the slicer's time estimate.

## Phase 1

| File | Qty | Material | Colour | Size (mm) | Layer | Plates | g each | g total | Time |
|---|---:|---|---|---|---|---:|---:|---:|---|
| axle_pin_x6.stl | 6 | PETG | Orange | 8.0 × 8.0 × 32.4 | 0.12 | 1 | 0.6 | 3.4 | 0h 52m |
| bias_spring_x1.stl | 1 | PETG | Orange | 67.4 × 2.2 × 8.0 | 0.12 | 1 | 1.0 | 1.0 | 0h 14m |
| brake_comb_190_x3.stl | 3 | PLA | Light Grey | 202.0 × 40.0 × 53.5 | 0.20 | 1 | 50.2 | 150.5 | 3h 27m |
| bumper_x3.stl | 3 | PETG | Orange | 64.0 × 40.0 × 56.0 | 0.12 | 1 | 35.4 | 106.2 | 4h 45m |
| chain_11_links_x3.stl | 3 | PLA | Light Grey | 156.0 × 10.0 × 10.0 | 0.12 | 1 | 5.7 | 17.1 | 0h 59m |
| chain_bed_190_x3.stl | 3 | PLA | Light Grey | 202.0 × 40.0 × 53.5 | 0.20 | 1 | 44.3 | 132.9 | 2h 34m |
| fit_coupon_x1.stl | 1 | PETG | Orange | 118.0 × 36.0 × 15.0 | 0.12 | 1 | 21.5 | 21.5 | 0h 59m |
| flap_x1.stl | 1 | PLA | Orange | 34.5 × 114.0 × 9.0 | 0.20 | 1 | 14.8 | 14.8 | 0h 25m |
| gantry_axle_x1.stl | 1 | PETG | Orange | 4.0 × 134.0 × 3.5 | 0.12 | 1 | 2.1 | 2.1 | 0h 12m |
| gate_key_x1.stl | 1 | PETG | Orange | 30.0 × 3.1 × 6.6 | 0.12 | 1 | 0.7 | 0.7 | 0h 14m |
| gate_lever_x1.stl | 1 | PLA | Light Grey | 28.9 × 28.5 × 4.6 | 0.20 | 1 | 1.4 | 1.4 | 0h 09m |
| gate_pin_x1.stl | 1 | PETG | Orange | 6.0 × 6.0 × 26.0 | 0.12 | 1 | 0.4 | 0.4 | 0h 11m |
| handover_x1.stl | 1 | PLA | Light Grey | 212.0 × 40.0 × 53.5 | 0.20 | 1 | 49.1 | 49.1 | 1h 06m |
| lead_rail_230_x3.stl | 3 | PLA | Light Grey | 242.0 × 22.0 × 53.5 | 0.20 | 1 | 43.8 | 131.5 | 2h 29m |
| pannier_x6.stl | 6 | PLA | Cobalt Blue | 64.0 × 10.2 × 54.8 | 0.20 | 1 | 17.5 | 105.2 | 2h 25m |
| rocker_bridge_x1.stl | 1 | PLA | Light Grey | 39.4 × 53.0 × 17.0 | 0.20 | 1 | 6.6 | 6.6 | 0h 25m |
| rocker_pin_x1.stl | 1 | PETG | Orange | 6.5 × 6.5 × 44.0 | 0.12 | 1 | 0.5 | 0.5 | 0h 14m |
| rocker_x1.stl | 1 | PLA | Orange | 30.6 × 77.0 × 13.4 | 0.12 | 1 | 8.3 | 8.3 | 0h 28m |
| sled_x3.stl | 3 | PLA | Light Grey | 20.0 × 13.0 × 22.0 | 0.20 | 1 | 3.3 | 10.0 | 0h 23m |
| start_gate_x1.stl | 1 | PLA | Light Grey | 30.0 × 14.0 × 25.0 | 0.20 | 1 | 5.8 | 5.8 | 0h 19m |
| tongue_x1.stl | 1 | PLA | Orange | 106.0 × 88.7 × 49.5 | 0.20 | 1 | 22.5 | 22.5 | 0h 41m |
| trolley_plate_x6.stl | 6 | PLA | Cobalt Blue | 64.0 × 40.0 × 15.8 | 0.20 | 1 | 8.2 | 49.1 | 1h 27m |
| turnout_base_x1.stl | 1 | PLA | Light Grey | 249.0 × 155.0 × 109.0 | 0.20 | 1 | 159.9 | 159.9 | 3h 38m |
| wedge_x1.stl | 1 | PETG | Orange | 32.0 × 5.4 × 22.0 | 0.12 | 1 | 3.2 | 3.2 | 0h 39m |
| wheel_x6.stl | 6 | PLA | Cobalt Blue | 24.0 × 24.0 × 8.0 | 0.12 | 1 | 3.5 | 20.9 | 1h 06m |
| window_hook_x1.stl | 1 | PETG | Orange | 84.0 × 74.0 × 46.0 | 0.20 | 1 | 49.6 | 49.6 | 1h 25m |

Phase 1 total: **1074 g**, 31h 46m of printing.

## Phase 2

| File | Qty | Material | Colour | Size (mm) | Layer | Plates | g each | g total | Time |
|---|---:|---|---|---|---|---:|---:|---:|---|
| access_arm_x1.stl | 1 | PLA | Orange | 183.9 × 30.0 × 26.0 | 0.20 | 1 | 44.9 | 44.9 | 1h 03m |
| arm_bracket_x1.stl | 1 | PLA | Dark Grey | 16.0 × 28.0 × 30.0 | 0.20 | 1 | 10.1 | 10.1 | 0h 25m |
| arm_pin_x1.stl | 1 | PETG | Orange | 10.0 × 10.0 × 46.0 | 0.12 | 1 | 1.8 | 1.8 | 0h 32m |
| booster_lower_x2.stl | 2 | PLA | Light Grey | 64.0 × 64.0 × 210.0 | 0.20 | 1 | 80.4 | 160.8 | 3h 53m |
| booster_strut_x4.stl | 4 | PLA | Light Grey | 10.0 × 10.0 × 13.2 | 0.12 | 1 | 0.3 | 1.2 | 0h 16m |
| booster_upper_x2.stl | 2 | PLA | Light Grey | 64.0 × 64.0 × 240.0 | 0.20 | 1 | 92.4 | 184.8 | 4h 18m |
| capsule_x1.stl | 1 | PLA | Jade White | 80.0 × 80.0 × 160.0 | 0.20 | 1 | 71.6 | 71.6 | 1h 52m |
| core_segment_x4.stl | 4 | PLA | Jade White | 80.0 × 80.0 × 210.0 | 0.20 | 1 | 101.1 | 404.2 | 8h 48m |
| launch_mount_x1.stl | 1 | PLA | Light Grey | 100.0 × 230.0 × 30.0 | 0.20 | 1 | 160.4 | 160.4 | 3h 28m |
| platform_tile_x4.stl | 4 | PLA | Light Grey | 236.0 × 236.0 × 10.0 | 0.20 | 4 | 169.4 | 677.6 | 11h 49m |
| tower_crown_x1.stl | 1 | PLA | Dark Grey | 240.0 × 160.0 × 68.0 | 0.20 | 1 | 118.3 | 118.3 | 2h 33m |
| tower_section_x4.stl | 4 | PLA | Dark Grey | 160.0 × 160.0 × 250.0 | 0.20 | 4 | 166.1 | 664.2 | 25h 26m |
| wire_saddle_x1.stl | 1 | PLA | Dark Grey | 24.0 × 28.0 × 30.0 | 0.20 | 1 | 11.1 | 11.1 | 0h 25m |

Phase 2 total: **2511 g**, 64h 48m of printing.

## Filament totals

| Material | Colour | Phase 1 g | Phase 2 g | Total g |
|---|---|---:|---:|---:|
| PETG | Orange | 189 | 2 | 190 |
| PLA | Cobalt Blue | 175 | 0 | 175 |
| PLA | Dark Grey | 0 | 804 | 804 |
| PLA | Jade White | 0 | 476 | 476 |
| PLA | Light Grey | 665 | 1185 | 1850 |
| PLA | Orange | 46 | 45 | 90 |

Grand total **3585 g** of filament through the nozzle, both phases, excluding purge, brims already included, failures not included.
