AdithyaKesanJayakanth/PLE-SBS-Capstone/scale_down/assembly/README.md

# Phase 1: step-by-step assembly, checked in FreeCAD

Screenshots rendered by FreeCAD from the part files (`freecad_render.py`), placed by `make_storyboard.py`. Every move shown here was collision-checked: `path_check_report.md` (exact booleans) and `freecad_motion_report.md` (FreeCAD's own booleans).

Full video of assembly, fitting and the three-wagon run: `video/phase1_full.mp4` (about four minutes).

- Insertion paths clear: 31 of 31
- Three-wagon run: 0 clashes
- FreeCAD motion check: 0 unexplained overlaps over 512 frames

Animations: `video/phase1_wagon.mp4`, `video/phase1_yard.mp4`, `video/phase1_ends.mp4`, `video/phase1_run.mp4`.

## Wagon

Two identical plates, two wheels, two identical panniers and two printed axle pins. There are no screws: each pin goes through pannier, plate, wheel, plate and pannier, and its split end snaps out of the far side.

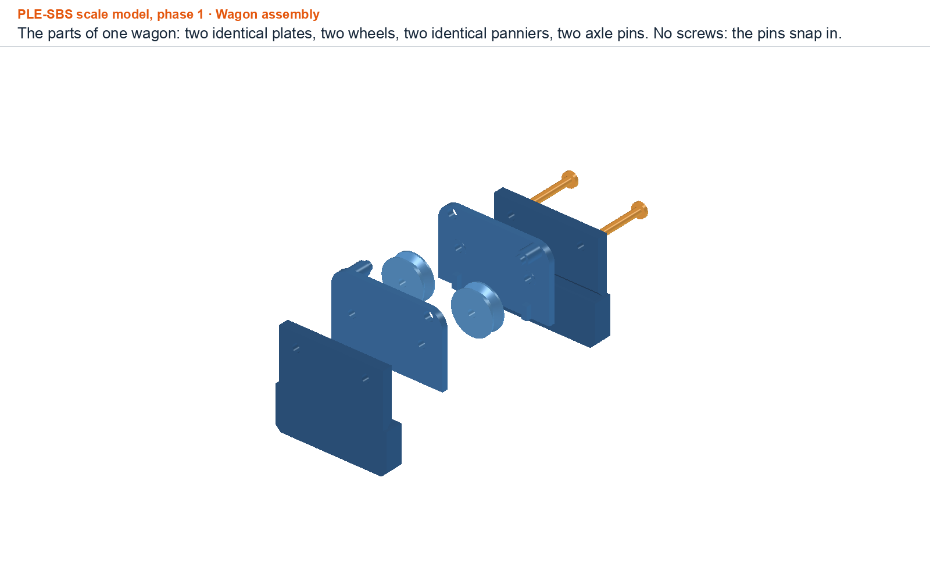
[picture p99: scale_down/assembly/steps/wagon_00_parts.png]
The parts of one wagon: two identical plates, two wheels, two identical panniers, two axle pins. No screws: the pins snap in.


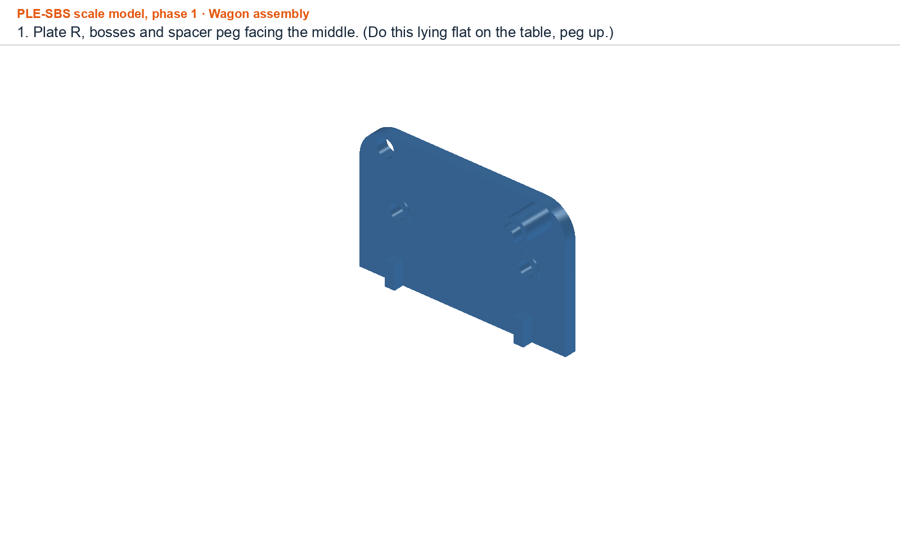
[picture p100: scale_down/assembly/steps/wagon_01_plate.png]
1. Plate R, bosses and spacer peg facing the middle. (Do this lying flat on the table, peg up.)


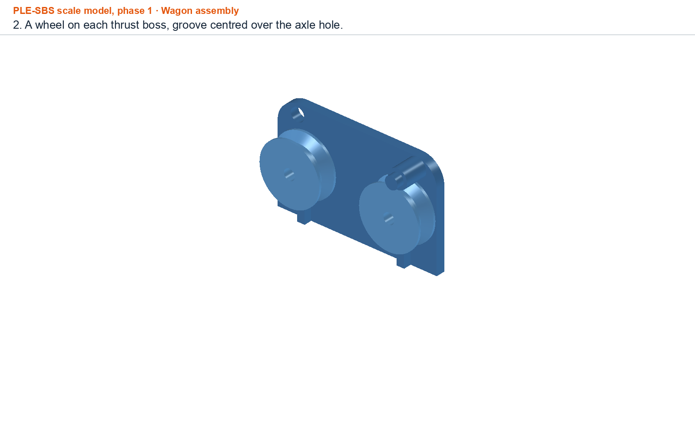
[picture p101: scale_down/assembly/steps/wagon_02_wheels.png]
2. A wheel on each thrust boss, groove centred over the axle hole.


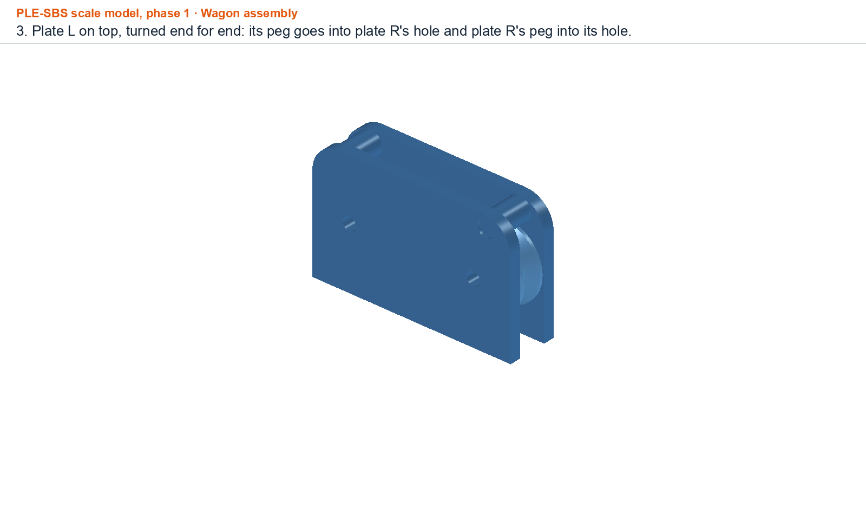
[picture p102: scale_down/assembly/steps/wagon_03_plate_L.png]
3. Plate L on top, turned end for end: its peg goes into plate R's hole and plate R's peg into its hole.


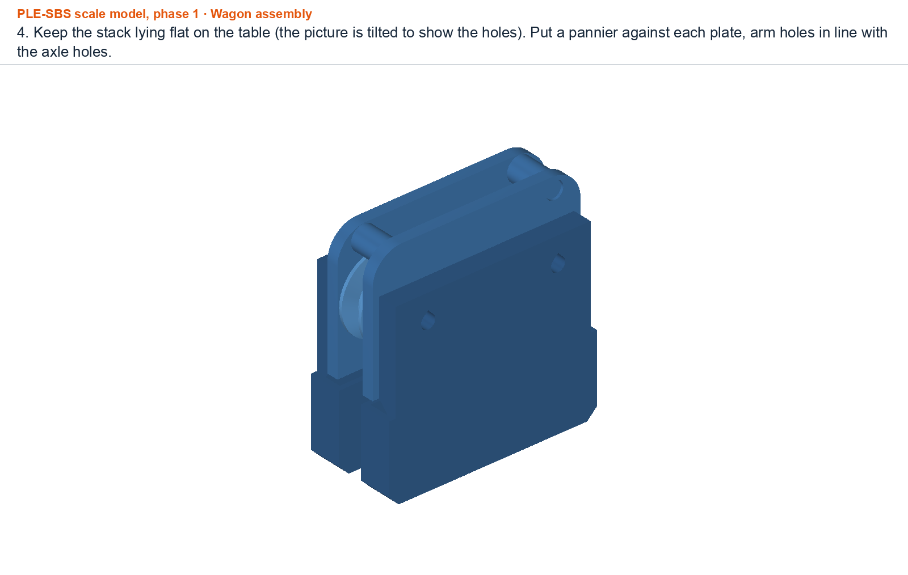
[picture p103: scale_down/assembly/steps/wagon_04_panniers.png]
4. Keep the stack lying flat on the table (the picture is tilted to show the holes). Put a pannier against each plate, arm holes in line with the axle holes.


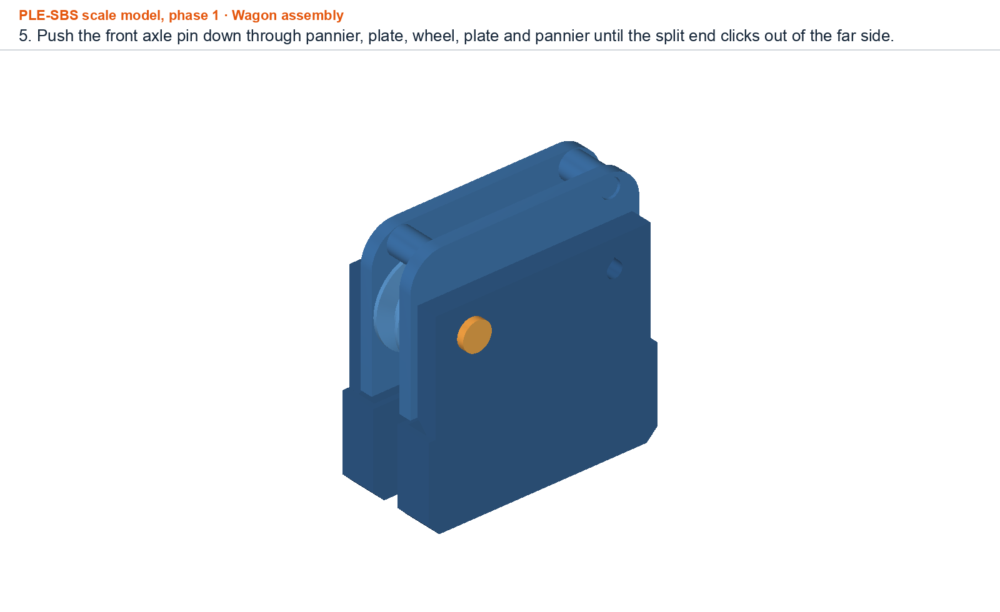
[picture p104: scale_down/assembly/steps/wagon_05_pin_front.png]
5. Push the front axle pin down through pannier, plate, wheel, plate and pannier until the split end clicks out of the far side.


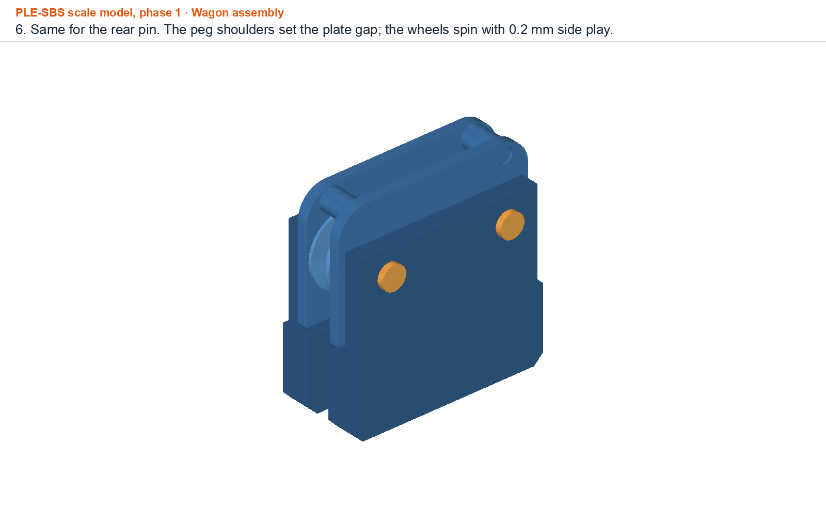
[picture p105: scale_down/assembly/steps/wagon_06_pin_rear.png]
6. Same for the rear pin. The peg shoulders set the plate gap; the wheels spin with 0.2 mm side play.


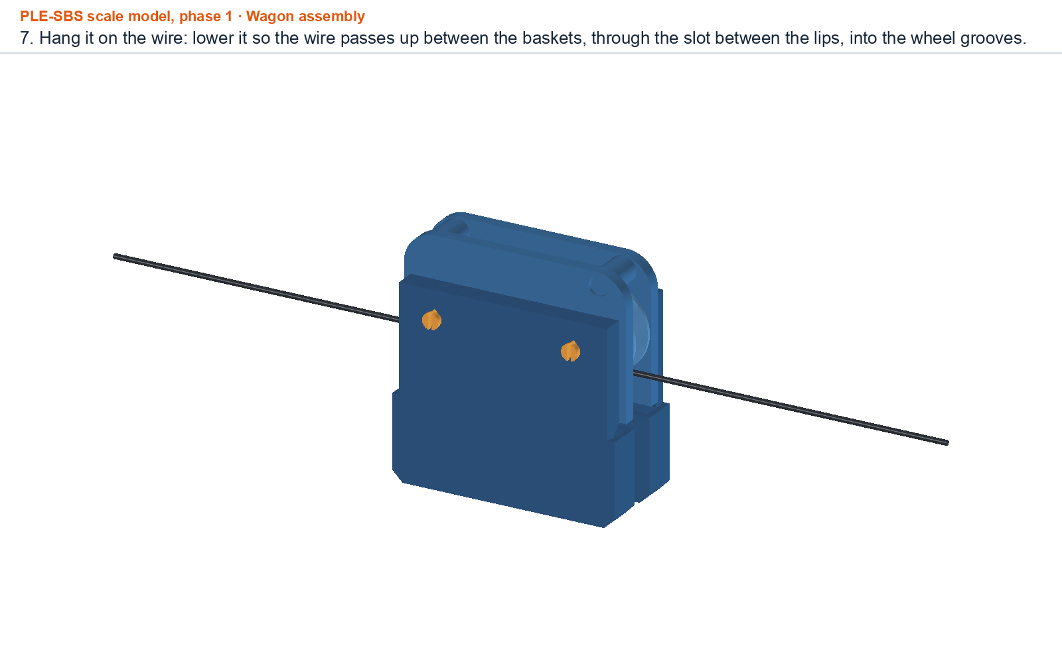
[picture p106: scale_down/assembly/steps/wagon_07_on_wire.png]
7. Hang it on the wire: lower it so the wire passes up between the baskets, through the slot between the lips, into the wheel grooves.


## Yard

Always lower the piece with the slot onto the piece with the tab. The tongue goes in before the rocker bridge, and slides under the end of the entry rail.

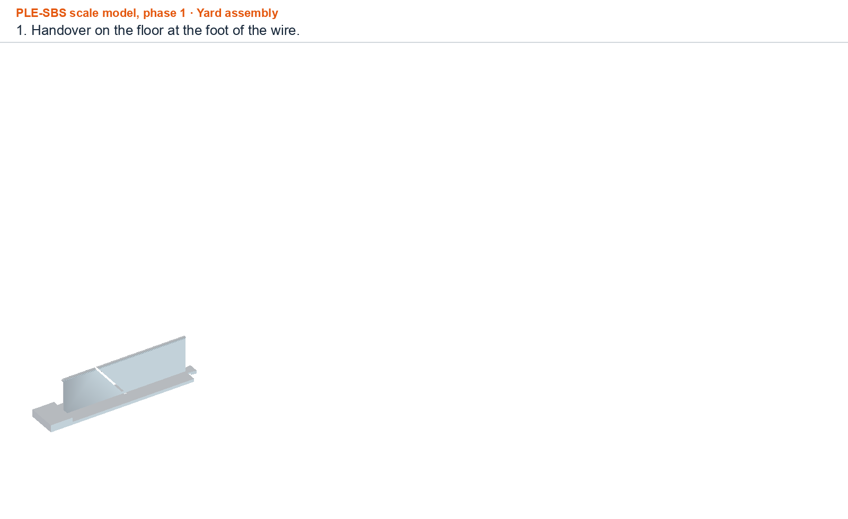
[picture p107: scale_down/assembly/steps/yard_01_handover.png]
1. Handover on the floor at the foot of the wire.


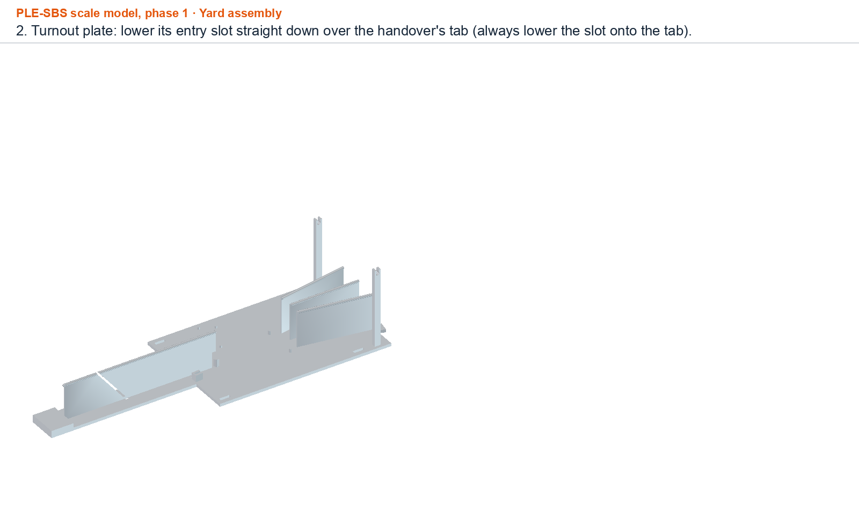
[picture p108: scale_down/assembly/steps/yard_02_turnout.png]
2. Turnout plate: lower its entry slot straight down over the handover's tab (always lower the slot onto the tab).


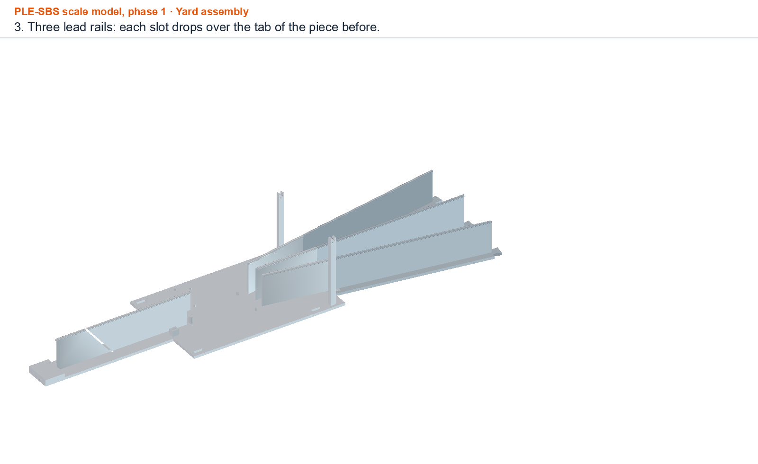
[picture p109: scale_down/assembly/steps/yard_03_lead.png]
3. Three lead rails: each slot drops over the tab of the piece before.


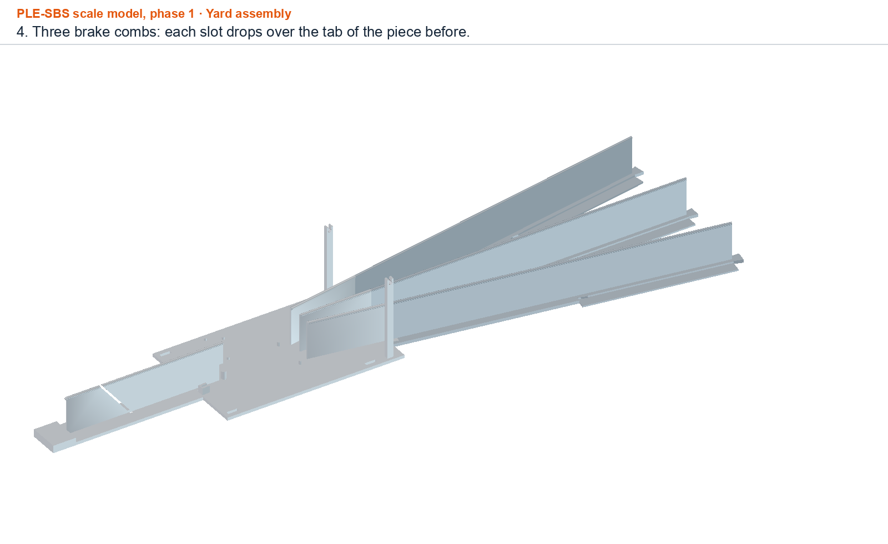
[picture p110: scale_down/assembly/steps/yard_04_brake.png]
4. Three brake combs: each slot drops over the tab of the piece before.


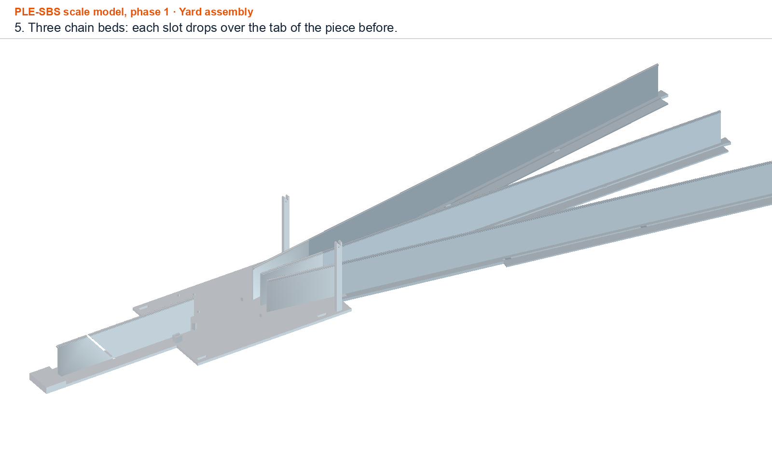
[picture p111: scale_down/assembly/steps/yard_05_chainbed.png]
5. Three chain beds: each slot drops over the tab of the piece before.


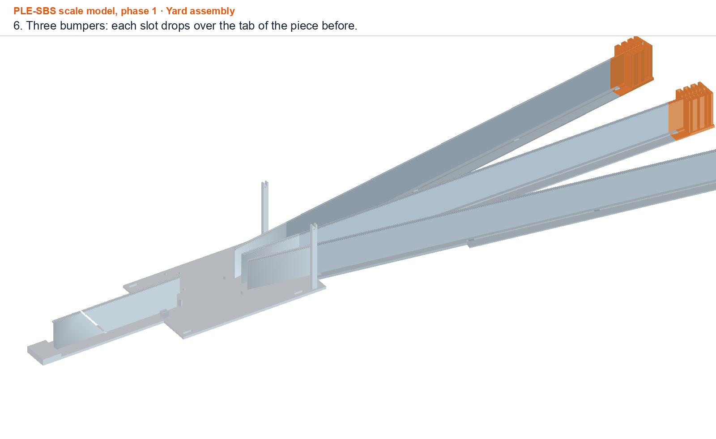
[picture p112: scale_down/assembly/steps/yard_06_bumper.png]
6. Three bumpers: each slot drops over the tab of the piece before.


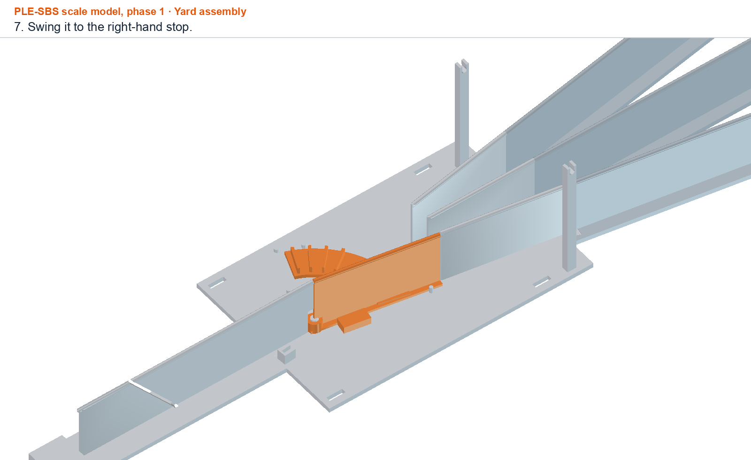
[picture p113: scale_down/assembly/steps/yard_07_tongue.png]
7. Swing it to the right-hand stop.


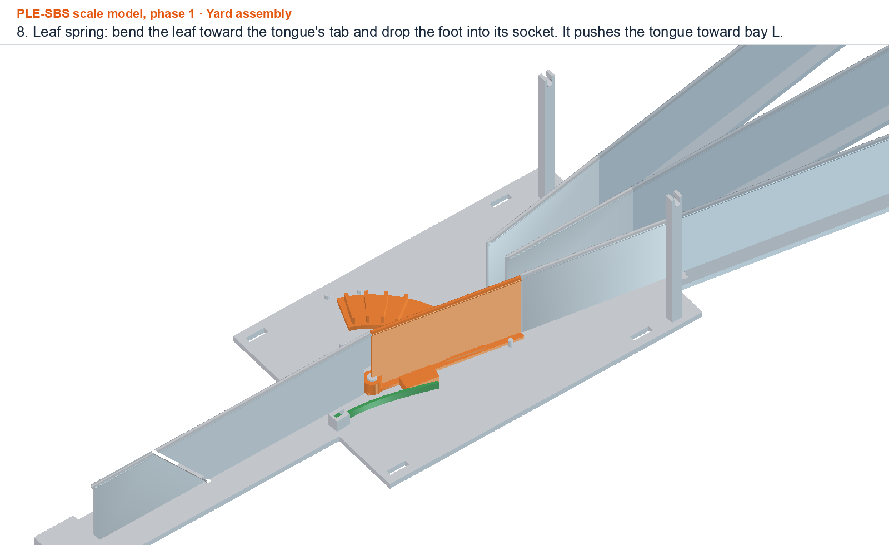
[picture p114: scale_down/assembly/steps/yard_08_spring.png]
8. Leaf spring: bend the leaf toward the tongue's tab and drop the foot into its socket. It pushes the tongue toward bay L.


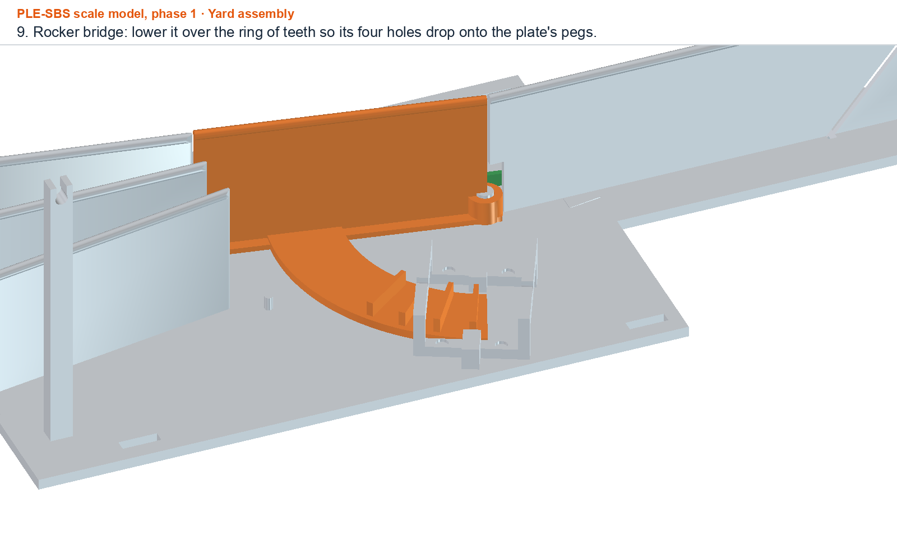
[picture p115: scale_down/assembly/steps/yard_09_bridge.png]
9. Rocker bridge: lower it over the ring of teeth so its four holes drop onto the plate's pegs.


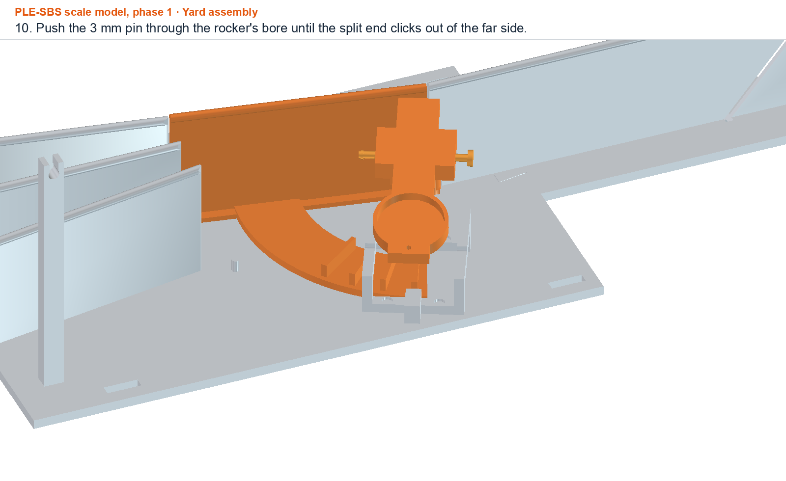
[picture p116: scale_down/assembly/steps/yard_10_rocker_pin.png]
10. Push the 3 mm pin through the rocker's bore until the split end clicks out of the far side.


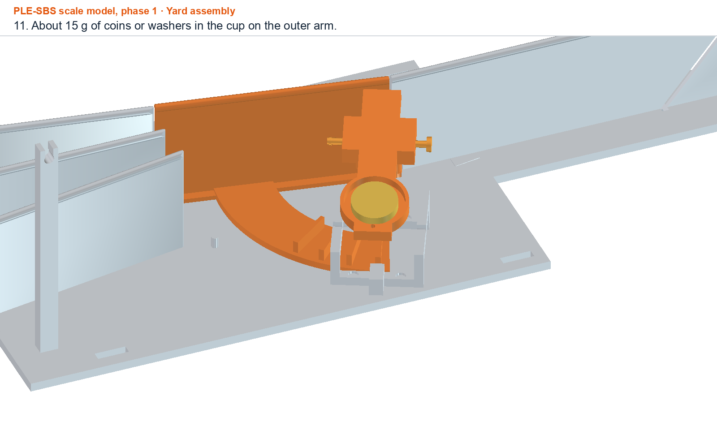
[picture p117: scale_down/assembly/steps/yard_11_coins.png]
11. About 15 g of coins or washers in the cup on the outer arm.


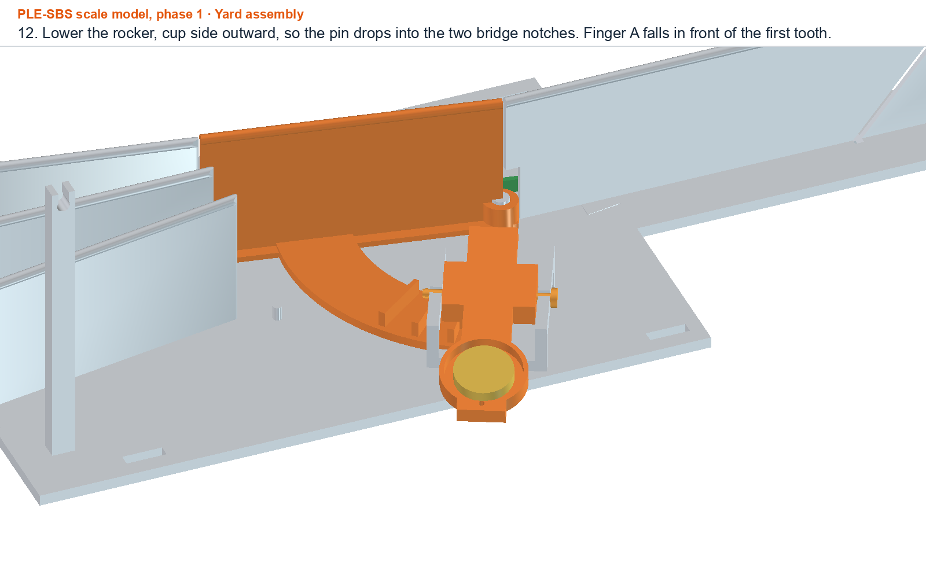
[picture p118: scale_down/assembly/steps/yard_12_rocker.png]
12. Lower the rocker, cup side outward, so the pin drops into the two bridge notches. Finger A falls in front of the first tooth.


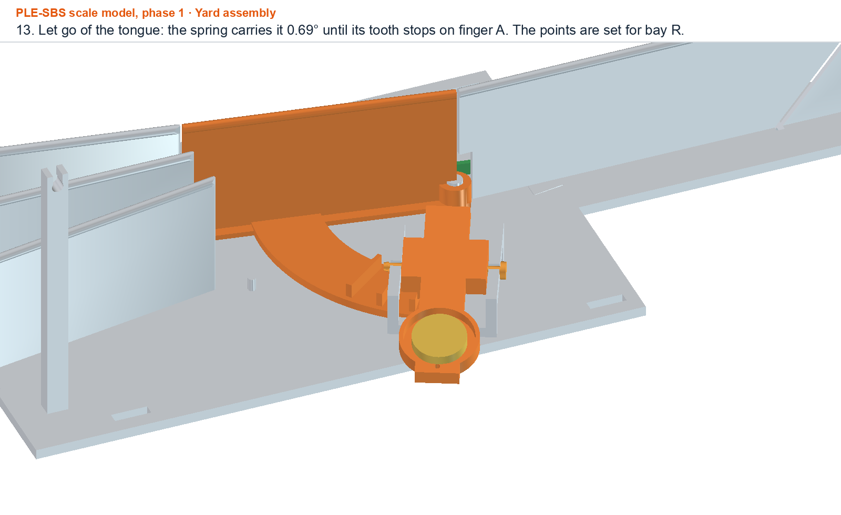
[picture p119: scale_down/assembly/steps/yard_13_set_R.png]
13. Let go of the tongue: the spring carries it 0.69° until its tooth stops on finger A. The points are set for bay R.


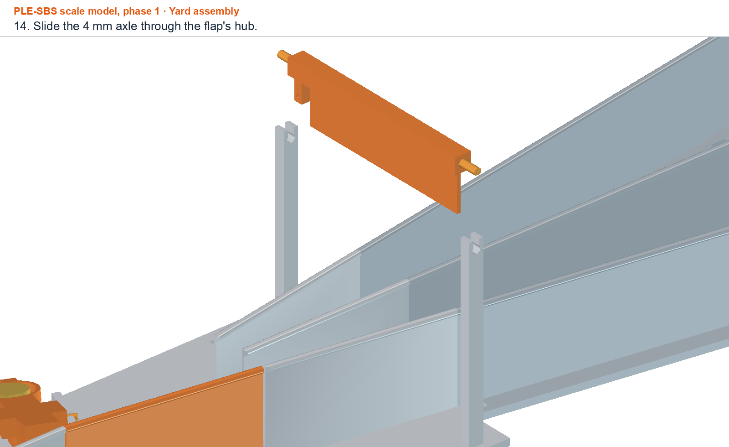
[picture p120: scale_down/assembly/steps/yard_14_axle.png]
14. Slide the 4 mm axle through the flap's hub.


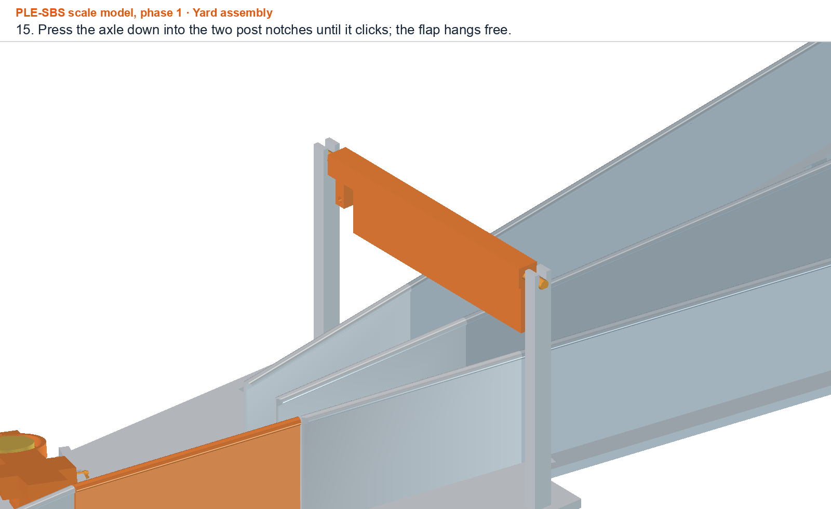
[picture p121: scale_down/assembly/steps/yard_15_flap.png]
15. Press the axle down into the two post notches until it clicks; the flap hangs free.


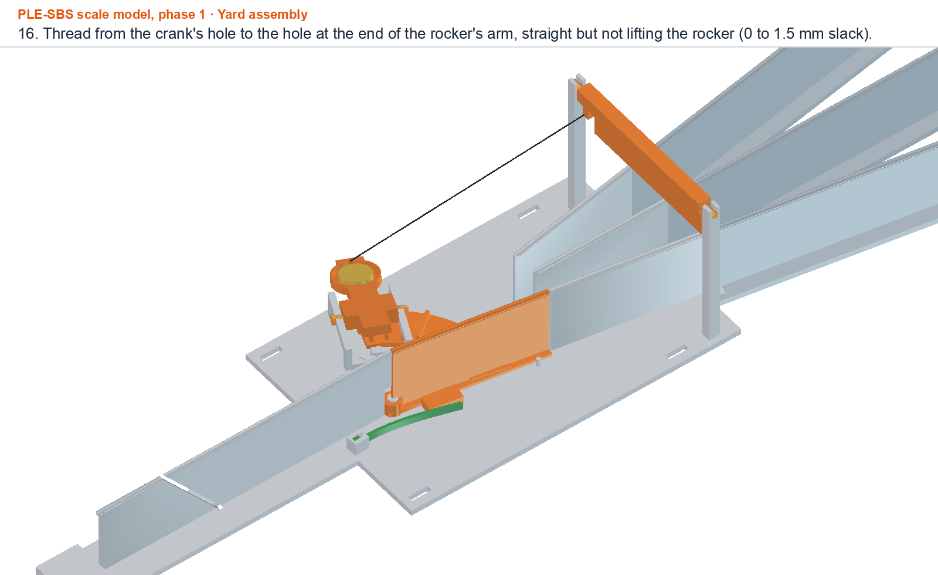
[picture p122: scale_down/assembly/steps/yard_16_thread.png]
16. Thread from the crank's hole to the hole at the end of the rocker's arm, straight but not lifting the rocker (0 to 1.5 mm slack).


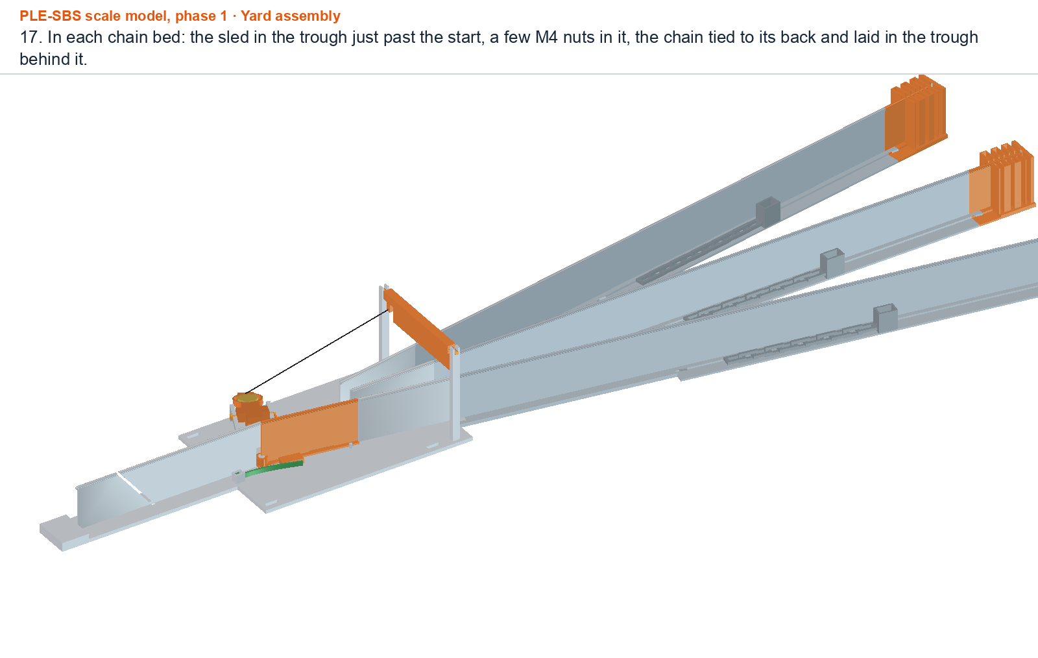
[picture p123: scale_down/assembly/steps/yard_17_sleds.png]
17. In each chain bed: the sled in the trough just past the start, a few M4 nuts in it, the chain tied to its back and laid in the trough behind it.


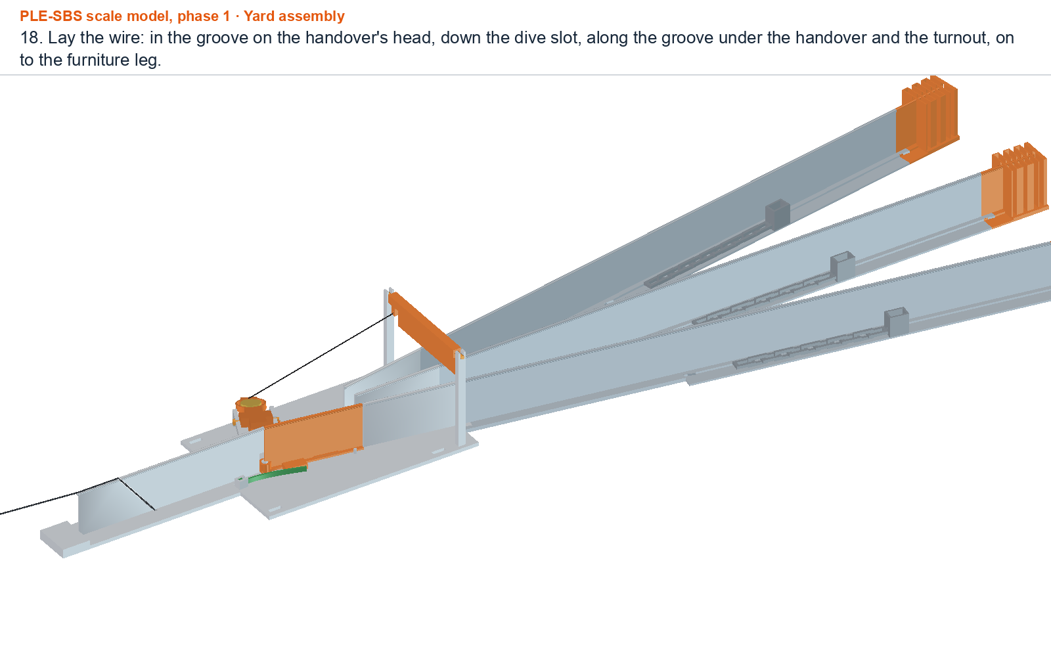
[picture p124: scale_down/assembly/steps/yard_18_wire.png]
18. Lay the wire: in the groove on the handover's head, down the dive slot, along the groove under the handover and the turnout, on to the furniture leg.


## Wire ends and start gate

The window hook holds the wire with three turns and a wedge. The start gate hangs on the wire, is locked by a tapered key, and holds the waiting wagon by its rear spacer peg.

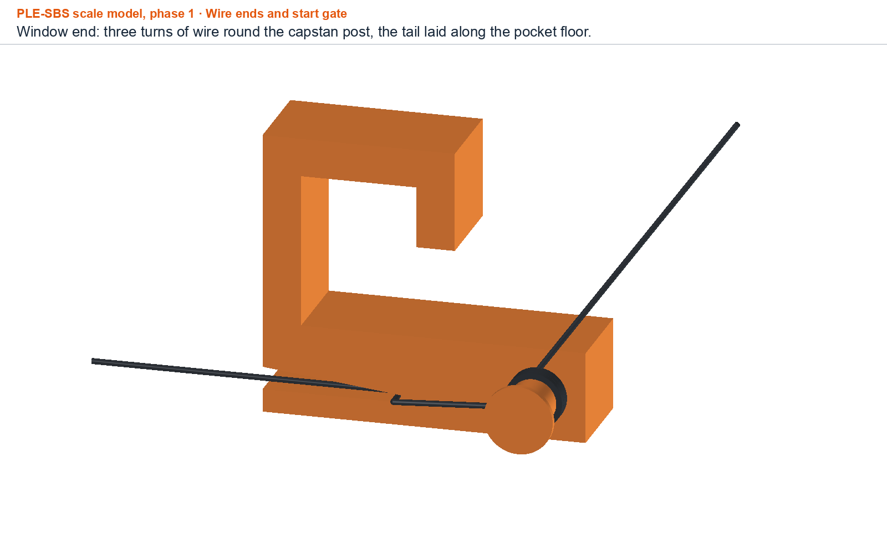
[picture p125: scale_down/assembly/steps/ends_01_hook_wire.png]
Window end: three turns of wire round the capstan post, the tail laid along the pocket floor.


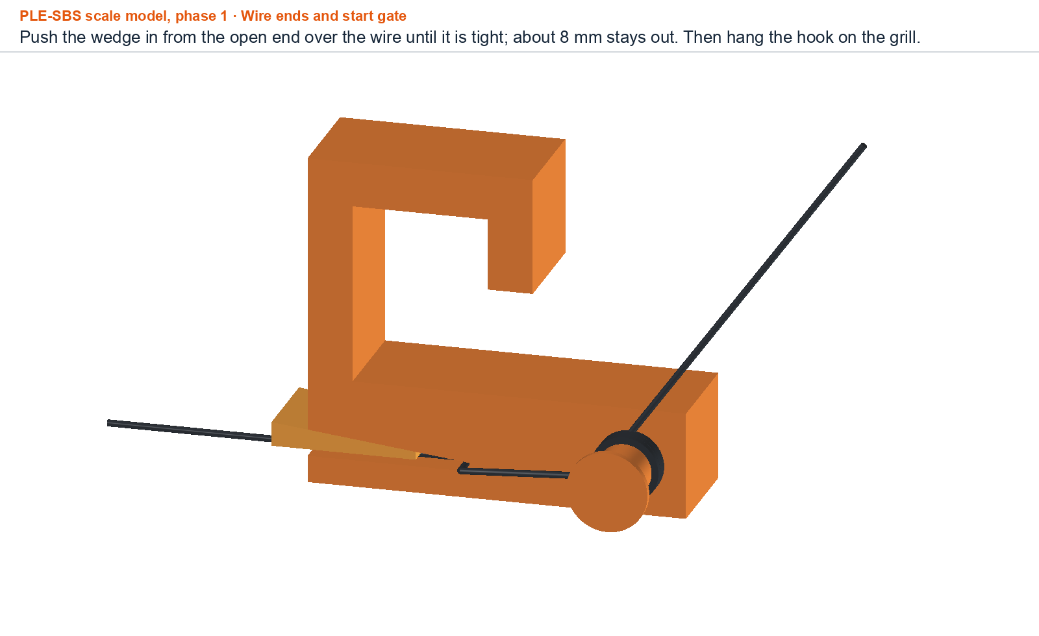
[picture p126: scale_down/assembly/steps/ends_02_wedge.png]
Push the wedge in from the open end over the wire until it is tight; about 8 mm stays out. Then hang the hook on the grill.


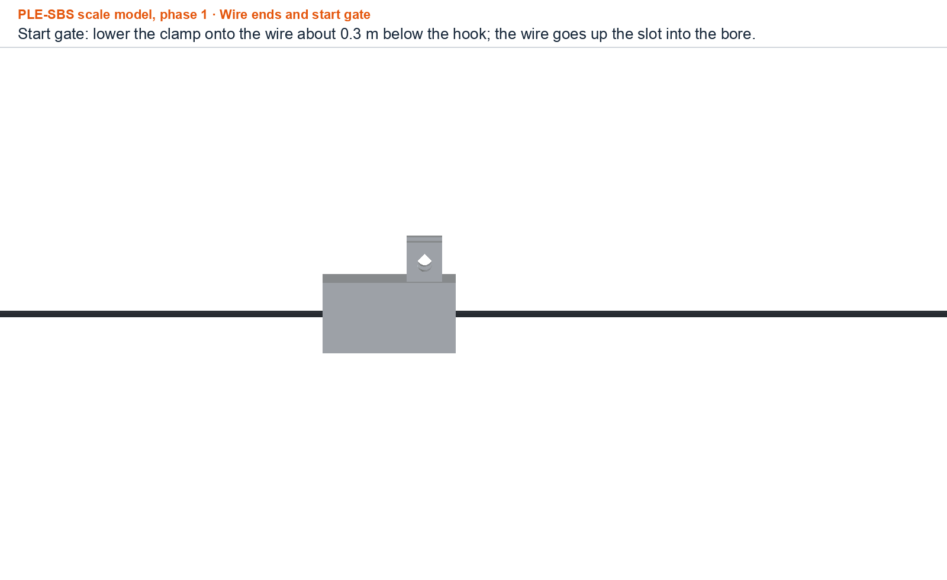
[picture p127: scale_down/assembly/steps/ends_03_gate.png]
Start gate: lower the clamp onto the wire about 0.3 m below the hook; the wire goes up the slot into the bore.


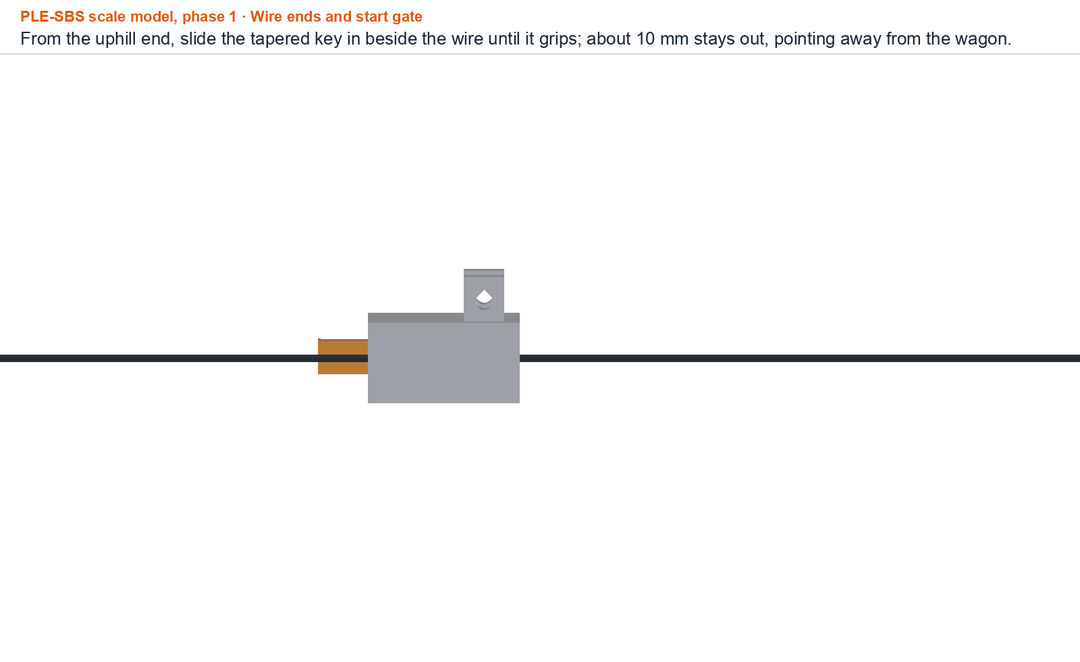
[picture p128: scale_down/assembly/steps/ends_04_key.png]
From the uphill end, slide the tapered key in beside the wire until it grips; about 10 mm stays out, pointing away from the wagon.


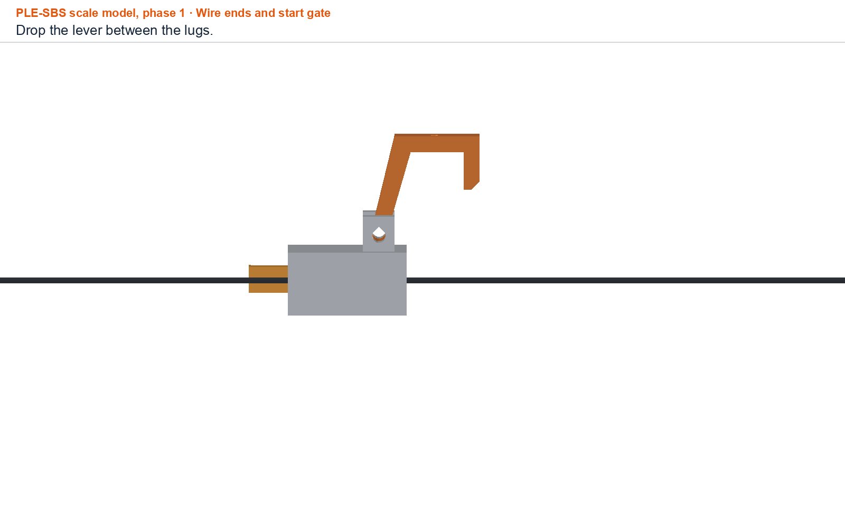
[picture p129: scale_down/assembly/steps/ends_05_lever.png]
Drop the lever between the lugs.


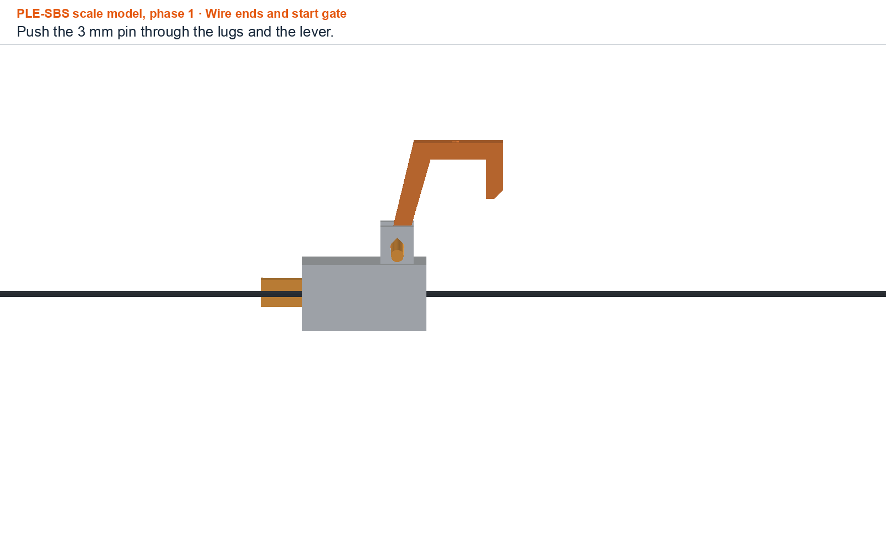
[picture p130: scale_down/assembly/steps/ends_06_pin.png]
Push the 3 mm pin through the lugs and the lever.


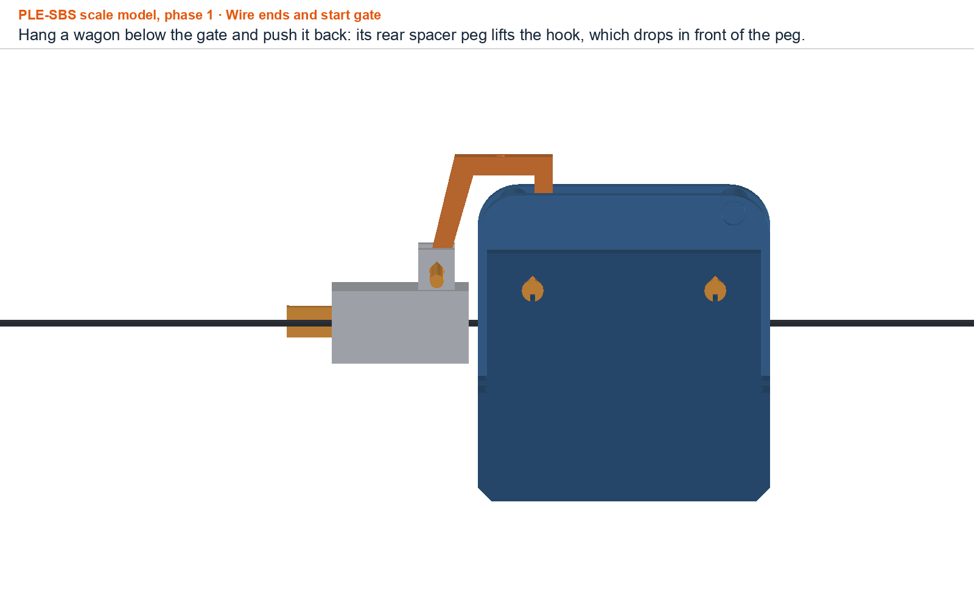
[picture p131: scale_down/assembly/steps/ends_07_latched.png]
Hang a wagon below the gate and push it back: its rear spacer peg lifts the hook, which drops in front of the peg.


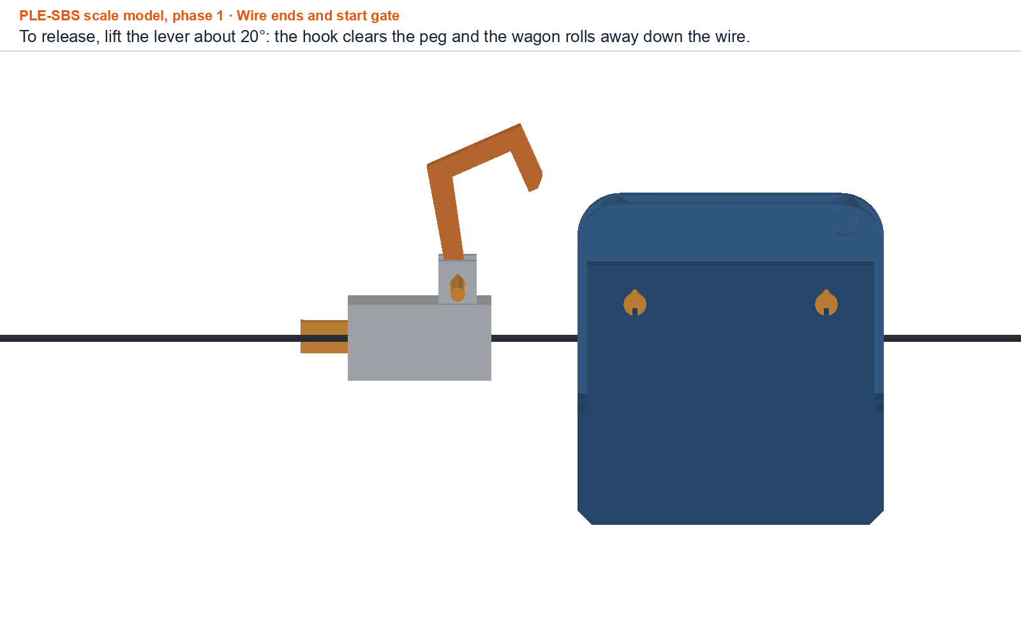
[picture p132: scale_down/assembly/steps/ends_08_release.png]
To release, lift the lever about 20°: the hook clears the peg and the wagon rolls away down the wire.


## Three wagons

Each wagon rolls down the wire, lands on the rail head at the same height, crosses the tongue, lifts the flap, and stops in its own bay. The flap rocks the escapement and the spring steps the tongue to the next bay.

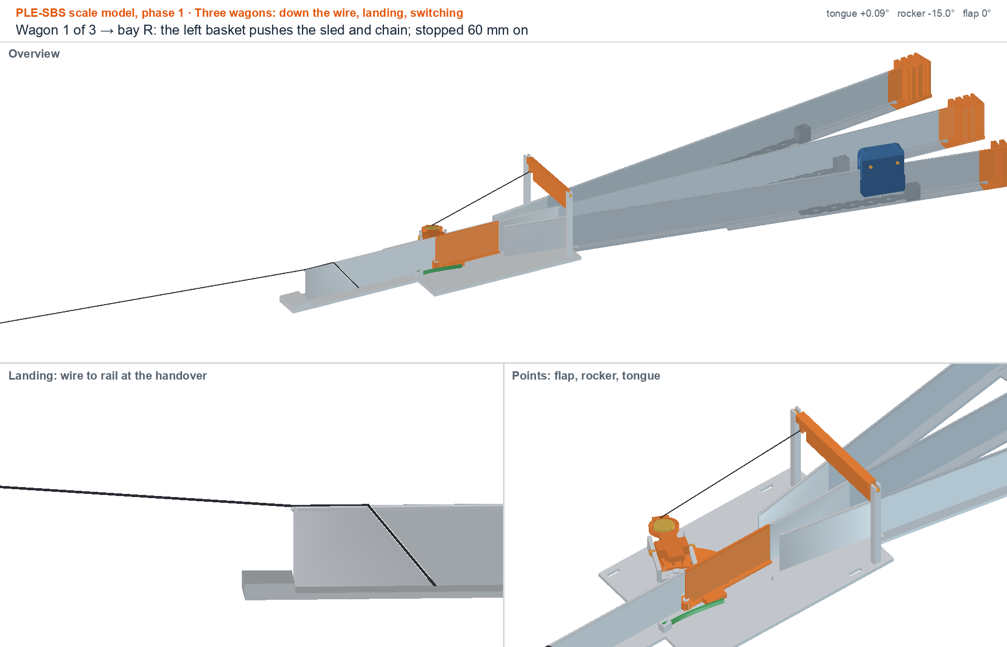
[picture p133: scale_down/assembly/steps/run_1_R_stopped.png]
Wagon 1 of 3 → bay R: the left basket pushes the sled and chain; stopped 60 mm on


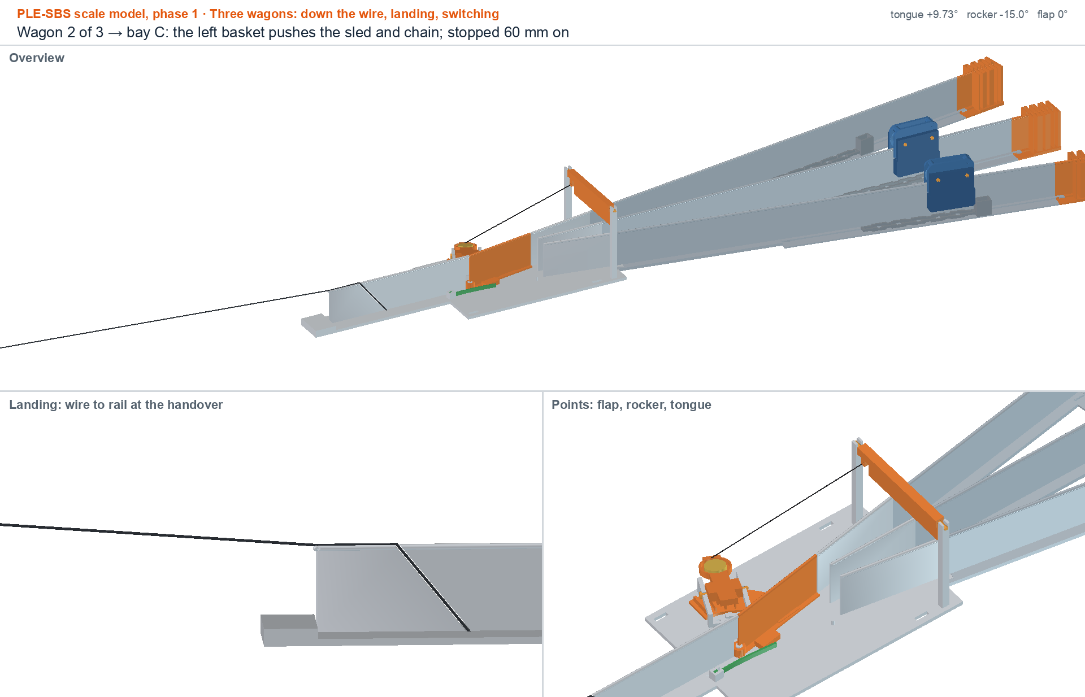
[picture p134: scale_down/assembly/steps/run_2_C_stopped.png]
Wagon 2 of 3 → bay C: the left basket pushes the sled and chain; stopped 60 mm on


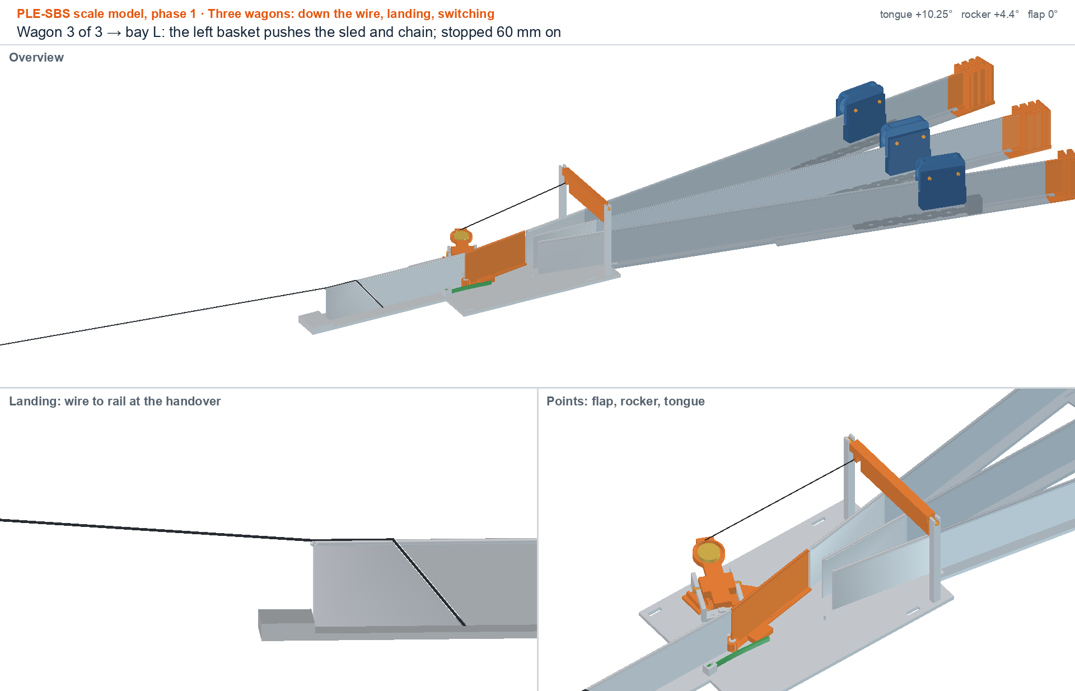
[picture p135: scale_down/assembly/steps/run_3_L_stopped.png]
Wagon 3 of 3 → bay L: the left basket pushes the sled and chain; stopped 60 mm on


## Moving parts

The positions every moving part can take, each checked against everything around it.

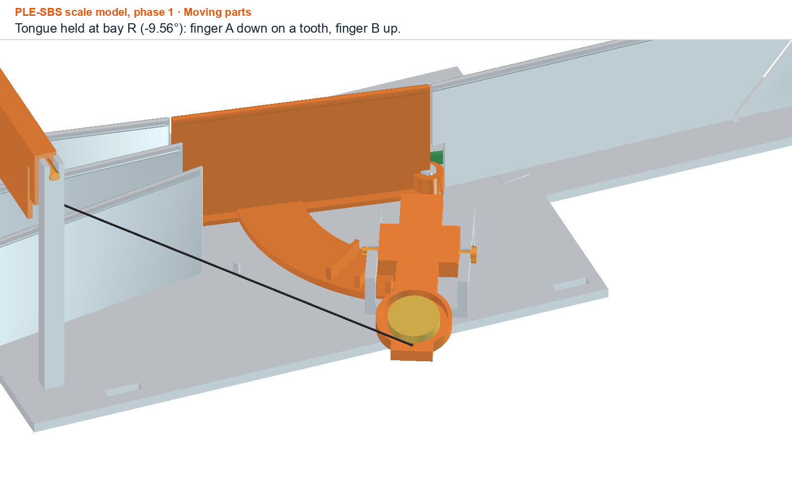
[picture p136: scale_down/assembly/steps/moving_tongue_R.png]
Tongue held at bay R (-9.56°): finger A down on a tooth, finger B up.


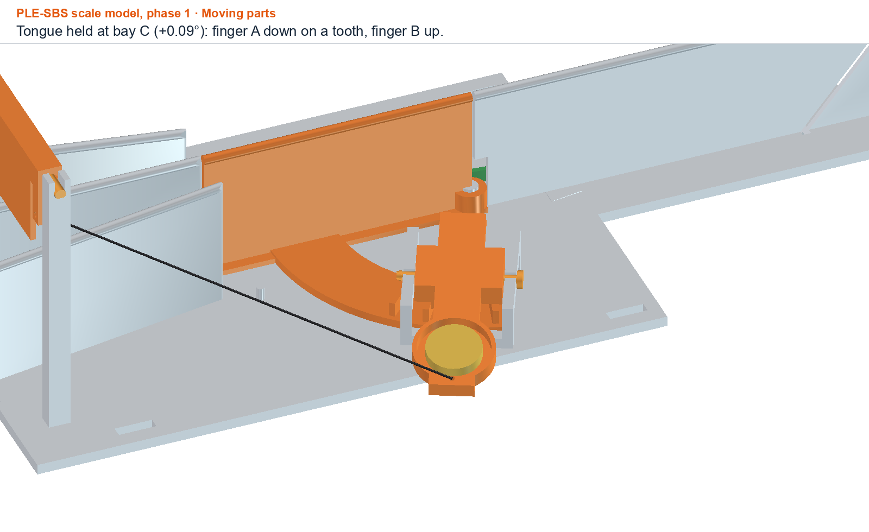
[picture p137: scale_down/assembly/steps/moving_tongue_C.png]
Tongue held at bay C (+0.09°): finger A down on a tooth, finger B up.


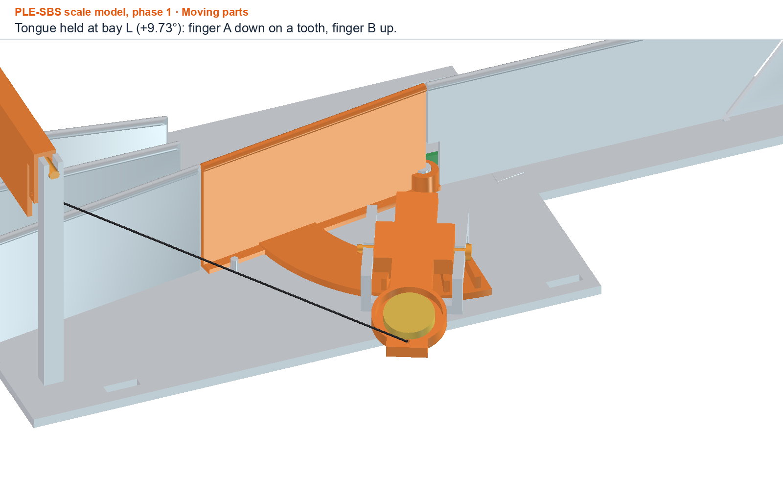
[picture p138: scale_down/assembly/steps/moving_tongue_L.png]
Tongue held at bay L (+9.73°): finger A down on a tooth, finger B up.


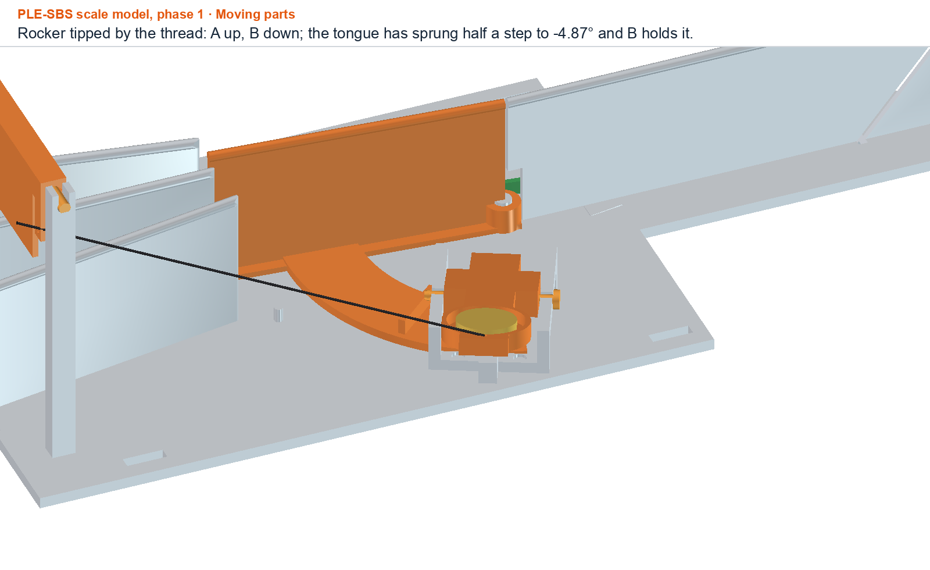
[picture p139: scale_down/assembly/steps/moving_rocker_tipped.png]
Rocker tipped by the thread: A up, B down; the tongue has sprung half a step to -4.87° and B holds it.


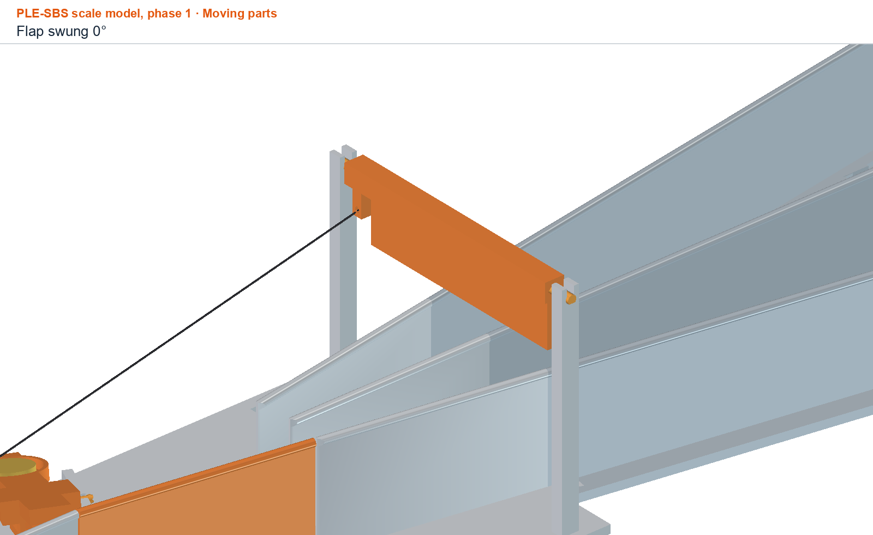
[picture p140: scale_down/assembly/steps/moving_flap_00.png]
Flap swung 0°


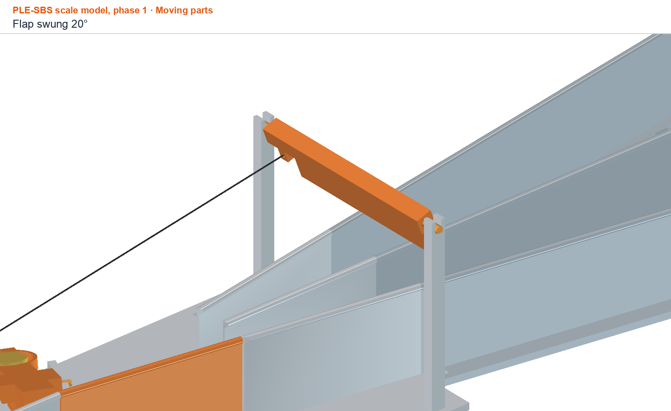
[picture p141: scale_down/assembly/steps/moving_flap_20.png]
Flap swung 20°


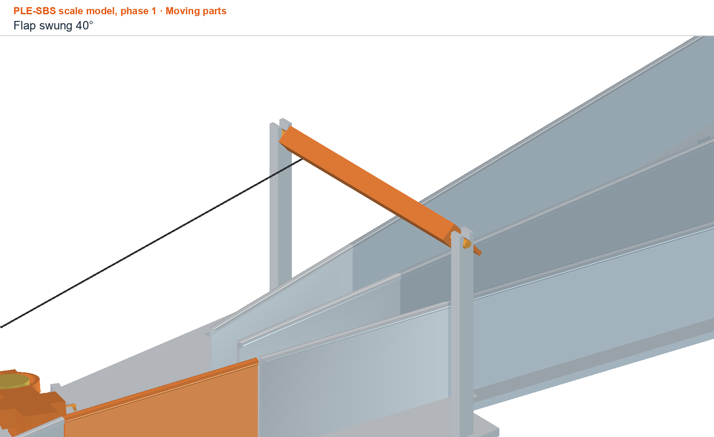
[picture p142: scale_down/assembly/steps/moving_flap_40.png]
Flap swung 40°
