AdithyaKesanJayakanth/PLE-SBS-Capstone/scale_down/print_pack/phase1/reprint_v2/set1/README.md

# Phase 1 version 2, Set 1: wagon, points and handover

12 files, 27 pieces, 423 g, 12h 07m of printing. Every file is in `stl/` (print orientation) and `sliced_p1s/` (Bambu Lab P1S, 0.4 mm nozzle, quantity already on the plate). Pictures and details of every part: `phase1_reprint_v2_set1_parts.pdf`.

Print this set first. Build one wagon with your existing wheels and roll it on an existing lead rail before printing the rest.

## Print these

| # | File | Qty | Filament | Colour | g | Time | Why it changed |
|---:|---|---:|---|---|---:|---|---|
| 1 | trolley_plate_x6 | 6 | PLA | Cobalt Blue | 49.1 | 1h 27m | pegs reach the other plate and carry shoulders that set the 9.2 mm gap; axle holes print round (the plate lies flat); lips 0.5 mm clear of the web; 3.6 thick with 0.4 bosses to suit 0.2 mm layers |
| 2 | pannier_x6 | 6 | PLA | Cobalt Blue | 105.2 | 2h 25m | new: one part for both sides, clamped by the axle pins, floor 12 mm above the strip; arm spacing for the 9.2 mm plate gap |
| 3 | axle_pin_x6 | 6 | PETG | Orange | 3.4 | 0h 52m | longer (28.4 mm shank) to pass through pannier, plate, wheel, plate, pannier; snap bump 0.7 mm clear |
| 4 | turnout_base_x1 | 1 | PLA | Light Grey | 159.9 | 3h 38m | new layout: lane spacing, pegs for the rocker bridge, gantry posts with 3.6 mm snap mouths, wire groove underneath; the entry rail's end lets the tongue slide under |
| 5 | tongue_x1 | 1 | PLA | Orange | 22.5 | 0h 41m | new: ring of four teeth and the spring tab |
| 6 | rocker_bridge_x1 | 1 | PLA | Light Grey | 6.6 | 0h 25m | new: carries the rocker over the tooth ring; separate so the tongue can be fitted first; beams 2.5 mm over the teeth, sliced with supports |
| 7 | rocker_x1 | 1 | PLA | Orange | 8.3 | 0h 28m | new: escapement rocker with a 26 mm coin cup |
| 8 | rocker_pin_x1 | 1 | PETG | Orange | 0.5 | 0h 14m | new |
| 9 | bias_spring_x1 | 1 | PETG | Orange | 1.0 | 0h 14m | new leaf spring |
| 10 | flap_x1 | 1 | PLA | Orange | 14.8 | 0h 25m | new trigger flap with a 16 mm crank |
| 11 | gantry_axle_x1 | 1 | PETG | Orange | 2.1 | 0h 12m | new |
| 12 | handover_x1 | 1 | PLA | Light Grey | 49.1 | 1h 06m | the wire now dives through it and runs on under the yard; head height matches the wheel seat |
| | **Total** | **27** | | | **423** | **12h 07m** | |

## Filament

| Filament | Colour | g |
|---|---|---:|
| PLA | Light Grey | 216 |
| PLA | Cobalt Blue | 154 |
| PLA | Orange | 46 |
| PETG | Orange | 7 |

## Keep these from the version-1 print (identical geometry, do not reprint)

| Keep | Used as |
|---|---|
| fit_coupon_x1 | fit_coupon_x1 |
| wheel_x6 | wheel_x6 |
| wedge_x2 (you have 2, need 1) | wedge_x1 |
| lead_rail_230_x3 | lead_rail_230_x3 |
| chain_11_links_x3 | chain_11_links_x3 |
| gate_key_x4 (you have 4, need 1) | gate_key_x1 |
| gate_pin_x3 (you have 3, need 1) | gate_pin_x1 |

Set aside, no longer used: indexer, star arms, the two v1 pannier types, v1 trolley plates, axle pins, start gates, gate levers, block marker flag, handover, turnout plate, tongue, combs, chain beds, bumpers and window hook.
