AdithyaKesanJayakanth/PLE-SBS-Capstone/scale_down/print_pack/phase1/reprint_v2/set2/README.md

# Phase 1 version 2, Set 2: bays, window hook and start gate

7 files, 15 pieces, 456 g, 13h 02m of printing. Every file is in `stl/` (print orientation) and `sliced_p1s/` (Bambu Lab P1S, 0.4 mm nozzle, quantity already on the plate). Pictures and details of every part: `phase1_reprint_v2_set2_parts.pdf`.

Print this set once set 1 is assembled and the wagon rolls. These parts are the bays, the wire's top end and the start gate.

## Print these

| # | File | Qty | Filament | Colour | g | Time | Why it changed |
|---:|---|---:|---|---|---:|---|---|
| 1 | window_hook_x1 | 1 | PETG | Orange | 49.6 | 1h 25m | pocket opens upward; rim prints without support |
| 2 | brake_comb_190_x3 | 3 | PLA | Light Grey | 150.5 | 3h 27m | v1 leaves stood 21.7 mm tall and would ram the baskets; v2 leaves reach 13.8 mm and end inside the segment |
| 3 | chain_bed_190_x3 | 3 | PLA | Light Grey | 132.9 | 2h 34m | trough runs to the end so the sled can reach the bumper; no stirrup ring |
| 4 | sled_x3 | 3 | PLA | Light Grey | 10.0 | 0h 23m | new: the left basket pushes it and the chain |
| 5 | bumper_x3 | 3 | PETG | Orange | 106.2 | 4h 45m | rail stub runs to the face plate; trough for the sled |
| 6 | start_gate_x1 | 1 | PLA | Light Grey | 5.8 | 0h 19m | v1 wire slot was 1 mm for a 1.5 mm wire and the key missed the wire; the slot now opens downward so the gate hangs on the wire |
| 7 | gate_lever_x1 | 1 | PLA | Light Grey | 1.4 | 0h 09m | new hook over the rear spacer peg |
| | **Total** | **15** | | | **456** | **13h 02m** | |

## Filament

| Filament | Colour | g |
|---|---|---:|
| PLA | Light Grey | 301 |
| PETG | Orange | 156 |

## Keep these from the version-1 print (identical geometry, do not reprint)

| Keep | Used as |
|---|---|
| fit_coupon_x1 | fit_coupon_x1 |
| wheel_x6 | wheel_x6 |
| wedge_x2 (you have 2, need 1) | wedge_x1 |
| lead_rail_230_x3 | lead_rail_230_x3 |
| chain_11_links_x3 | chain_11_links_x3 |
| gate_key_x4 (you have 4, need 1) | gate_key_x1 |
| gate_pin_x3 (you have 3, need 1) | gate_pin_x1 |

Set aside, no longer used: indexer, star arms, the two v1 pannier types, v1 trolley plates, axle pins, start gates, gate levers, block marker flag, handover, turnout plate, tongue, combs, chain beds, bumpers and window hook.
