AdithyaKesanJayakanth/PLE-SBS-Capstone/scale_down/check/assembly_report.md

# Phase 1 fit and motion check

## 1. Wagon
- Clashes between wagon parts: none
- front peg (plate R into L): reaches 3.0 mm into the 3.6 mm plate; 0.21 / 0.21 mm play in the hole
- rear peg (plate L into R): reaches 3.0 mm into the 3.6 mm plate; 0.21 / 0.21 mm play in the hole
- rear wheel: side play 0.20 / 0.20 mm to the thrust bosses; 0.21 mm radial play on the pin
- front wheel: side play 0.20 / 0.20 mm to the thrust bosses; 0.21 mm radial play on the pin
- plate gap: the plates close 0.00 mm before the peg shoulders meet (0 = the shoulders set the gap)
- axle pin: head to right pannier 0.00 mm; snap bump to left pannier face 0.73 mm (pin pushed home)
- right pannier: 0.00 mm to its plate (0 = clamped flat); floor 12.0 mm above the rail strip
- left pannier: 0.00 mm to its plate (0 = clamped flat); floor 12.0 mm above the rail strip

## 2. Wagon on a rail and on the wire
- wheels seated on the head: drop before contact 0.05 mm (0 = seated)
- lips under the head: the wagon lifts 0.75 mm before a lip hooks the head
- side play on the rail web: 0.50 / 0.50 mm
- clashes with the rail: none
- on the wire: wheels drop 0.00 mm to seat; wire to lip slot sides 3.86 / 3.86 mm; lips 6.00 mm below the wire

## 3. Yard: static fit
- modules joined by their dovetails, clashes: none
- dovetail play: 0.19 mm sideways, 0.20 mm along
- wire through the handover: clear; side play 0.21 mm
- wire through the turnout plate: clear; side play 0.45 mm

## 4. Tongue, spring and stops
- tongue swept -10.25 to 10.25 degrees against the plate: clear
- left overtravel stop: tongue 0.3 degrees past the outer lane overlaps the stop by 1.42 (must be > 0)
- right overtravel stop: tongue 0.3 degrees past the outer lane overlaps the stop by 1.42 (must be > 0)
- spring at tongue -10.25 deg: leaf bent 17.2 mm, force 1.50 N, strain 1.38 %, leaf vs plate clear
- spring at tongue -9.65 deg: leaf bent 16.9 mm, force 1.48 N, strain 1.35 %, leaf vs plate clear
- spring at tongue +0.00 deg: leaf bent 11.8 mm, force 1.03 N, strain 0.95 %, leaf vs plate clear
- spring at tongue +9.65 deg: leaf bent 7.1 mm, force 0.62 N, strain 0.57 %, leaf vs plate clear
- spring at tongue +10.25 deg: leaf bent 6.8 mm, force 0.60 N, strain 0.55 %, leaf vs plate clear

## 5. Escapement: three pods, three bays
- rocker tilted -15 to 22 degrees against the goalposts and stops: clear
- rest stop: 0.4 degrees beyond rest overlaps 0.43; limit stop 0.4 beyond overlaps 0.20 (both must be > 0: they are the stops)
- rocker pin in the notches: clear; pin in the rocker bore: clear
- rest: finger A tip at z 6.34, finger B tip at z 9.96 (teeth 2.5 to 8.5)
- triggered: finger A tip at z 9.96, finger B tip at z 6.34 (teeth 2.5 to 8.5)
- reset: tongue held by finger A at -9.56 deg (lane R is -9.65)
- pod 1 passes the flap: finger B catches the tongue at -4.87 deg; flap falls back, finger A stops it at +0.09 deg (want +0.00); largest push-back by a finger 0.05 deg
- pod 2 passes the flap: finger B catches the tongue at +4.77 deg; flap falls back, finger A stops it at +9.73 deg (want +9.65); largest push-back by a finger 0.05 deg
- trigger to only 9 deg: R to +0.09 deg
- trigger to only 22 deg: R to +0.09 deg
- escapement sequence: R, C, L as designed

## 6. A wagon through each lane
- lane R (tongue -9.65 deg): wagon pushes the flap to 40.3 deg
  - wheel steered by the head: wheel front / tongue from 280 to 292 mm along the path, up to 0.4; the wheel rides up at most 0.14 mm over the joint
  - wheel steered by the head: wheel rear / turnout plate from 308 to 320 mm along the path, up to 0.3; the wheel rides up at most 0.13 mm over the joint
  - intended: pannier R / brake R from 740 to 944 mm along the path, up to 169.3
  - intended: pannier L / sled from 904 to 984 mm along the path, up to 177.5
- lane C (tongue +0.00 deg): wagon pushes the flap to 40.3 deg
  - intended: pannier R / brake C from 736 to 940 mm along the path, up to 169.3
  - intended: pannier L / sled from 904 to 980 mm along the path, up to 194.4
- lane L (tongue +9.65 deg): wagon pushes the flap to 40.3 deg
  - wheel steered by the head: wheel front / tongue from 280 to 292 mm along the path, up to 0.4; the wheel rides up at most 0.14 mm over the joint
  - wheel steered by the head: wheel rear / turnout plate from 308 to 320 mm along the path, up to 0.3; the wheel rides up at most 0.13 mm over the joint
  - intended: pannier R / brake L from 740 to 944 mm along the path, up to 169.3
  - intended: pannier L / sled from 904 to 984 mm along the path, up to 177.5

## 7. Flap, thread and trigger
- flap swung 0 to 75 deg: clear of the posts and the axle
- axle in the snap notches: clear
- thread tied with 0.0 mm slack: at 40.3 deg of flap the rocker tilts to +17.3 deg (needs +9 or more); the rocker reaches its stop, and holds the flap, at 44.2 deg
- thread tied with 0.5 mm slack: at 40.3 deg of flap the rocker tilts to +15.1 deg (needs +9 or more); the rocker reaches its stop, and holds the flap, at 46.5 deg
- thread tied with 1.0 mm slack: at 40.3 deg of flap the rocker tilts to +13.0 deg (needs +9 or more); the rocker reaches its stop, and holds the flap, at 48.8 deg
- thread tied with 1.5 mm slack: at 40.3 deg of flap the rocker tilts to +11.1 deg (needs +9 or more); the rocker reaches its stop, and holds the flap, at 51.2 deg

## 8. Bumper, start gate, wire ends
- bumper: first contact with the zig-zag by plate R, plate L, pannier R, pannier L; front axle then 12 mm along a 60 mm rail stub
- sled pushed along the trough: runs 179 mm, then meets the bumper at z -2.0 to 20.0 (the zig-zag stands on z 0)
- sled and chain at rest: clear
- chain dragged behind the sled the whole way to the bumper, through the comb's and the chain bed's troughs: clear
- start gate clamp vs wagon: clear; gap to the wagon 2.00 mm
- gate lever latched: clear; the wagon moves 0.62 mm before the peg meets the hook
- gate lever vs clamp: clear
- gate key in place (its tail uphill) vs the latched wagon: clear
- release: lifting the lever 17.0 deg frees the wagon
- wire in the gate clamp: clear
  - gate key on a 1.4 mm wire: grips with 7.8 mm of key showing (clear of the body: True)
  - gate key on a 1.5 mm wire: grips with 9.8 mm of key showing (clear of the body: True)
  - gate key on a 1.6 mm wire: grips with 11.8 mm of key showing (clear of the body: True)
- window hook: wire in the pocket clear; the wedge grips a 1.5 mm wire with 7.9 mm of it showing past the hook's end

## 9. Printability, each STL as it sits on the bed
Downward-facing area not on the bed: flat ceilings must be bridges (both ends supported); steep is steeper than 45 degrees from vertical.

| File | Flat ceilings mm² | Steeper than 45° mm² | Largest flat ceiling span mm |
|---|---:|---:|---:|
| axle_pin_x6.stl | 4 | 0 | 1.9 |
| bias_spring_x1.stl | 0 | 0 | 0.0 |
| brake_comb_190_x3.stl | 24 | 3453 | 2.0 |
| bumper_x3.stl | 83 | 37 | 4.0 |
| chain_11_links_x3.stl | 1074 | 0 | 10.0 |
| chain_bed_190_x3.stl | 24 | 117 | 2.0 |
| fit_coupon_x1.stl | 0 | 0 | 0.0 |
| flap_x1.stl | 0 | 502 | 0.0 |
| gantry_axle_x1.stl | 0 | 17 | 0.0 |
| gate_key_x1.stl | 0 | 0 | 0.0 |
| gate_lever_x1.stl | 2 | 5 | 0.4 |
| gate_pin_x1.stl | 0 | 0 | 0.0 |
| handover_x1.stl | 227 | 107 | 7.3 |
| lead_rail_230_x3.stl | 24 | 142 | 2.0 |
| pannier_x6.stl | 84 | 394 | 1.4 |
| rocker_bridge_x1.stl | 292 | 0 | 4.0 |
| rocker_pin_x1.stl | 3 | 0 | 1.4 |
| rocker_x1.stl | 530 | 104 | 26.0 |
| sled_x3.stl | 0 | 4 | 0.0 |
| start_gate_x1.stl | 100 | 18 | 4.1 |
| tongue_x1.stl | 7 | 62 | 2.0 |
| trolley_plate_x6.stl | 0 | 0 | 0.0 |
| turnout_base_x1.stl | 572 | 201 | 14.0 |
| wedge_x1.stl | 0 | 0 | 0.0 |
| wheel_x6.stl | 0 | 253 | 0.0 |
| window_hook_x1.stl | 20 | 0 | 13.0 |
