AdithyaKesanJayakanth/PLE-SBS-Capstone/scale_down/print_pack/phase1/renders/axle_pin_x6.png

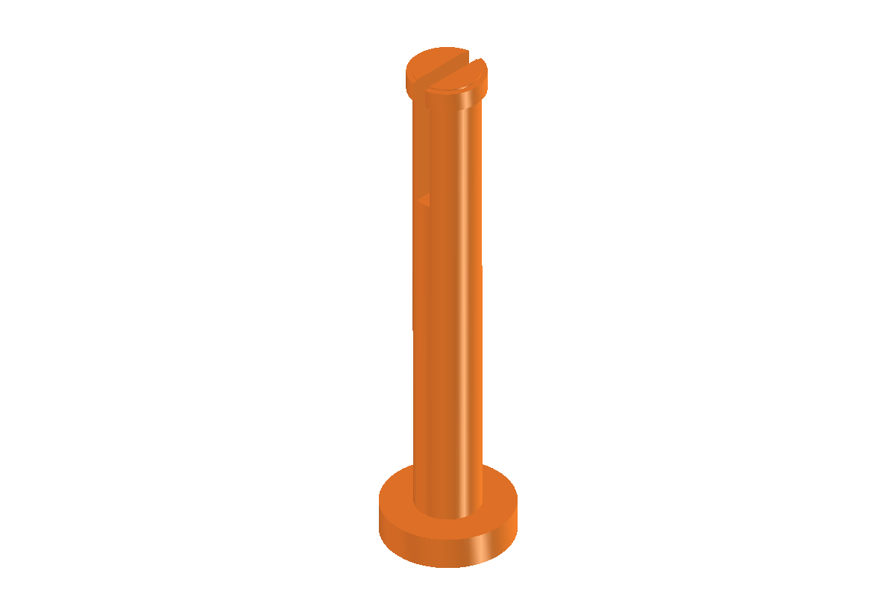
scale_down/print_pack/phase1/renders/axle_pin_x6.png
