AdithyaKesanJayakanth/PLE-SBS-Capstone/scale_down/print_pack/phase1/renders/rocker_bridge_x1.png

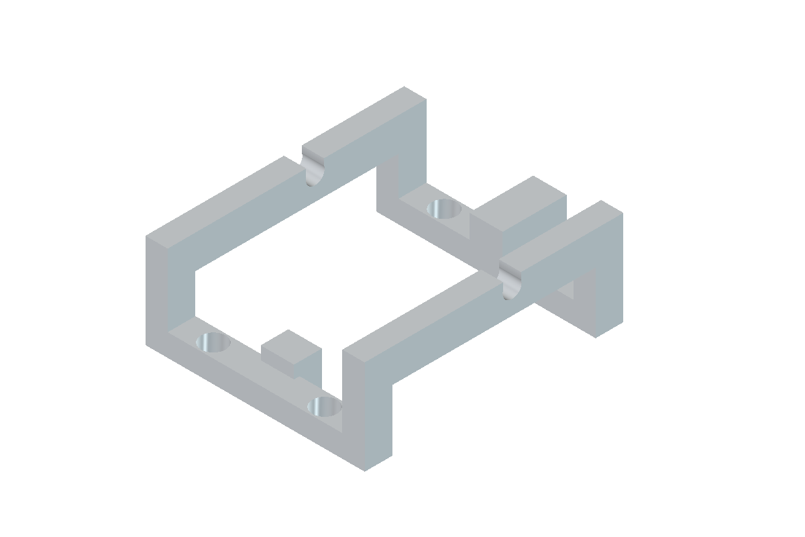
scale_down/print_pack/phase1/renders/rocker_bridge_x1.png
