AdithyaKesanJayakanth/PLE-SBS-Capstone/scale_down/print_pack/phase1/renders/start_gate_x1.png

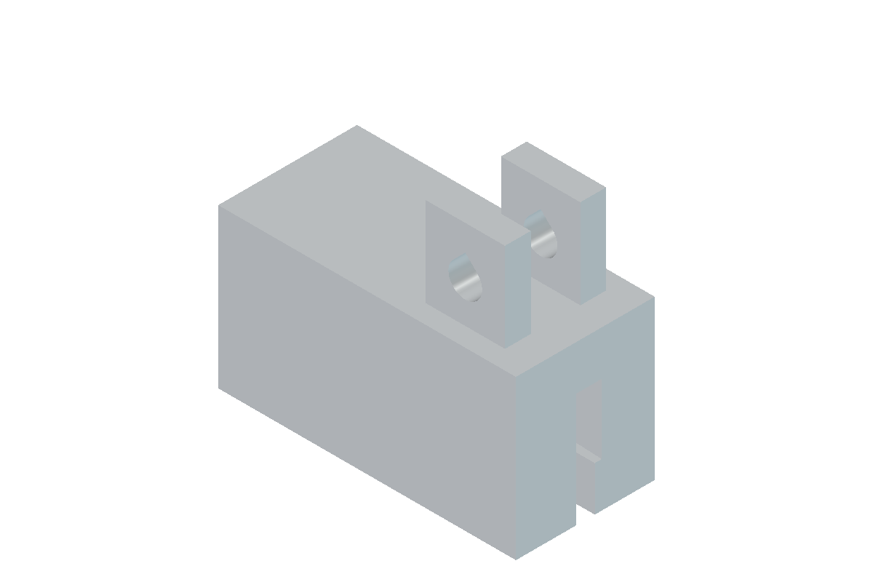
scale_down/print_pack/phase1/renders/start_gate_x1.png
