AdithyaKesanJayakanth/PLE-SBS-Capstone/scale_down/print_pack/phase1/renders/wheel_x6.png

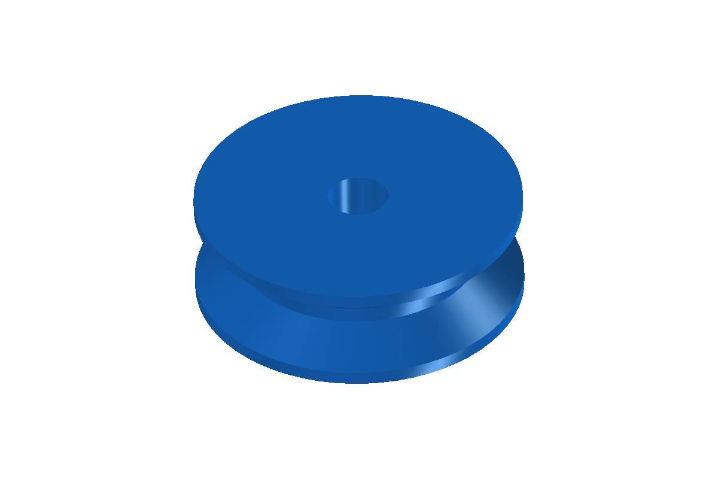
scale_down/print_pack/phase1/renders/wheel_x6.png
