AdithyaKesanJayakanth/PLE-SBS-Capstone/scale_down/print_pack/phase1/sheets/bias_spring_x1.png

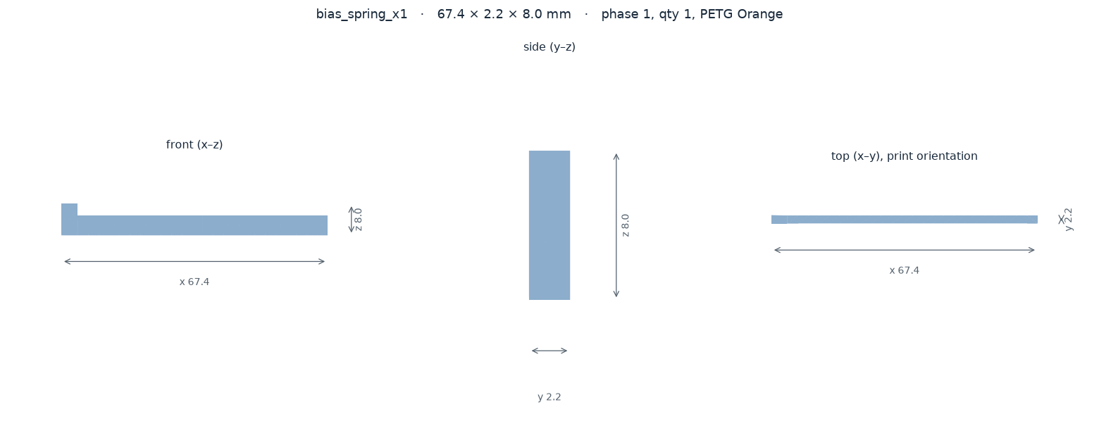
scale_down/print_pack/phase1/sheets/bias_spring_x1.png
