AdithyaKesanJayakanth/PLE-SBS-Capstone/scale_down/print_pack/phase1/sheets/brake_comb_190_x3.png

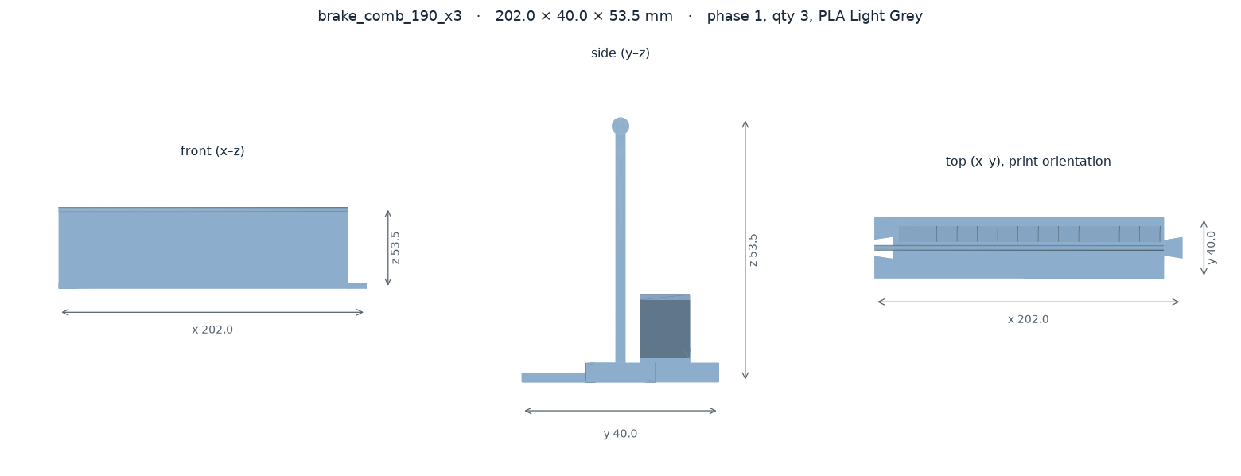
scale_down/print_pack/phase1/sheets/brake_comb_190_x3.png
