AdithyaKesanJayakanth/PLE-SBS-Capstone/scale_down/print_pack/phase1/sheets/chain_11_links_x3.png

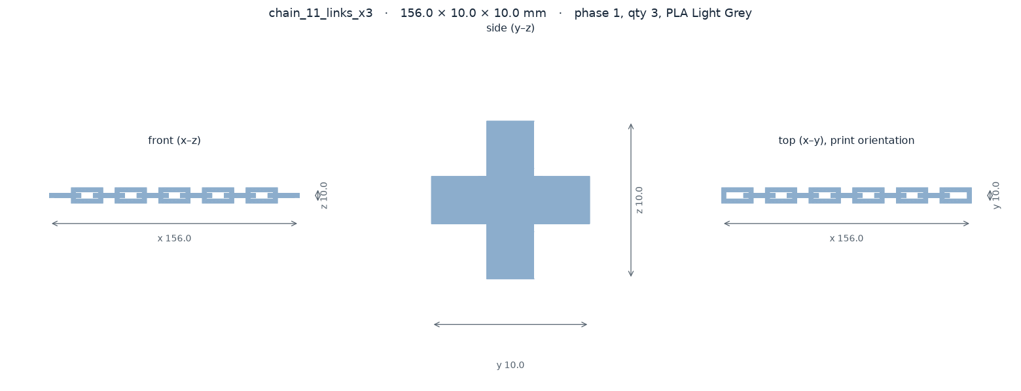
scale_down/print_pack/phase1/sheets/chain_11_links_x3.png
