AdithyaKesanJayakanth/PLE-SBS-Capstone/scale_down/print_pack/phase1/sheets/tongue_x1.png

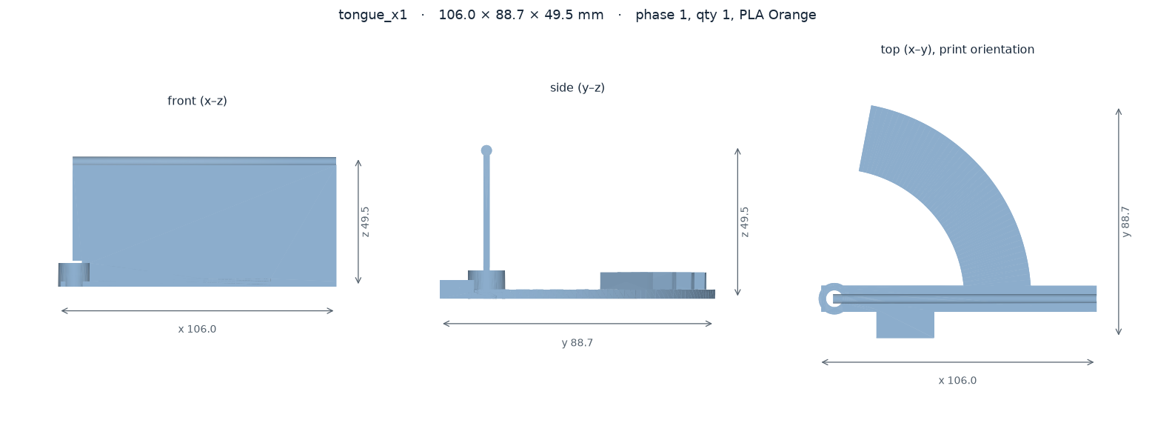
scale_down/print_pack/phase1/sheets/tongue_x1.png
