AdithyaKesanJayakanth/PLE-SBS-Capstone/scale_down/print_pack/phase1/sheets/trolley_plate_x6.png

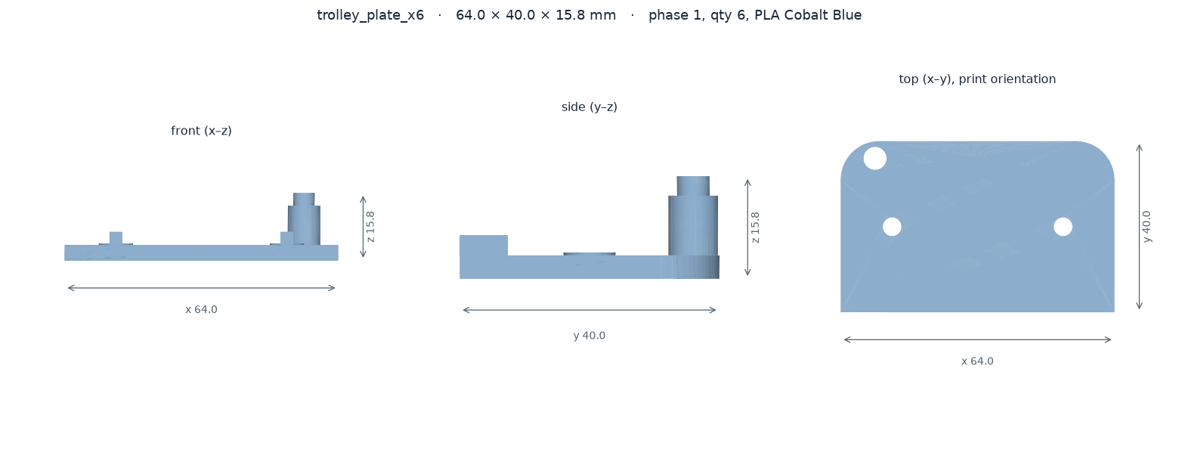
scale_down/print_pack/phase1/sheets/trolley_plate_x6.png
