AdithyaKesanJayakanth/PLE-SBS-Capstone/scale_down/print_pack/phase2/sheets/arm_bracket_x1.png

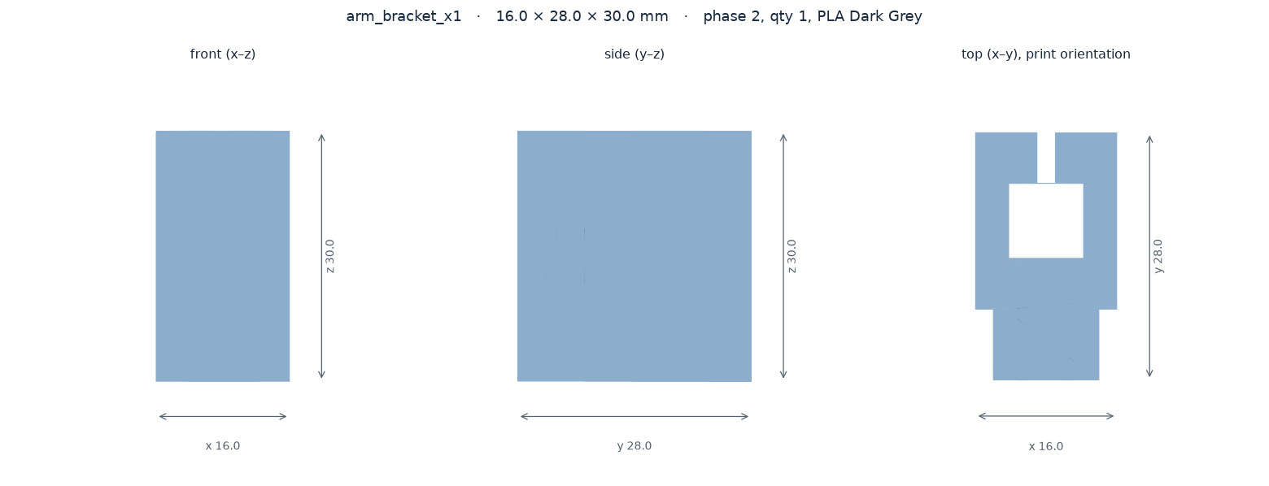
scale_down/print_pack/phase2/sheets/arm_bracket_x1.png
