AdithyaKesanJayakanth/PLE-SBS-Capstone/scale_down/print_pack/phase2/sheets/booster_lower_x2.png

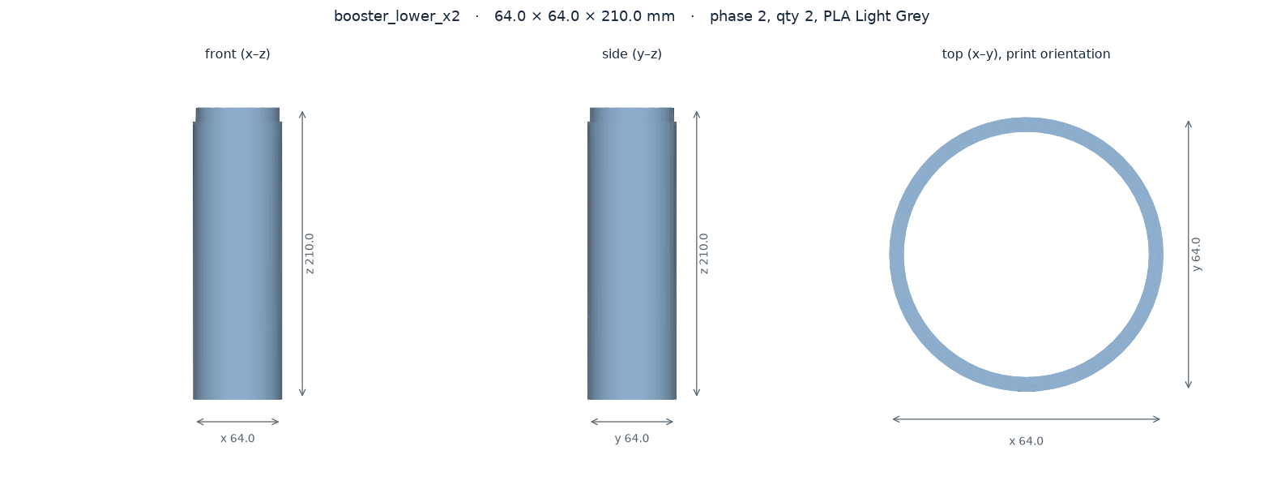
scale_down/print_pack/phase2/sheets/booster_lower_x2.png
