AdithyaKesanJayakanth/PLE-SBS-Capstone/scale_down/print_pack/phase2/sheets/booster_upper_x2.png

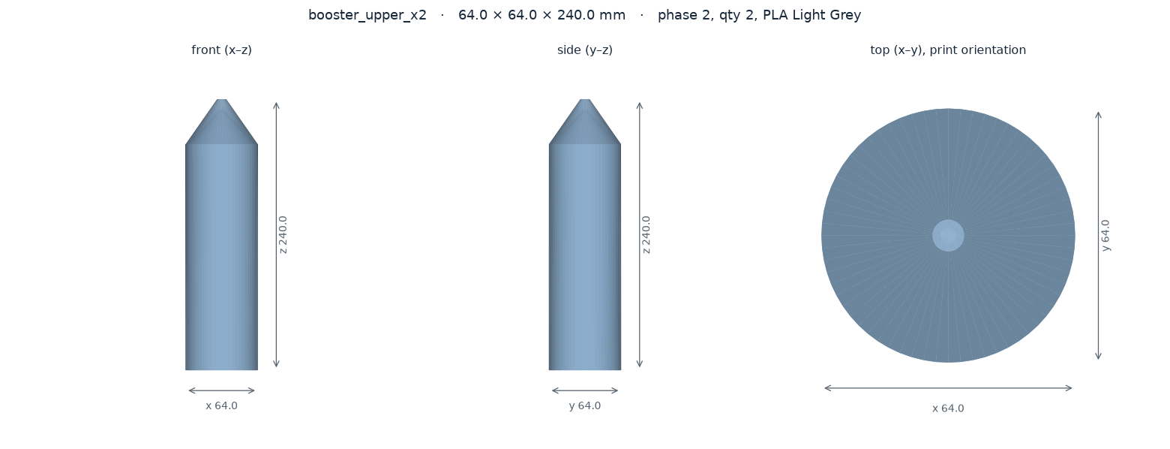
scale_down/print_pack/phase2/sheets/booster_upper_x2.png
