AdithyaKesanJayakanth/PLE-SBS-Capstone/scale_down/print_pack/phase2/sheets/platform_tile_x4.png

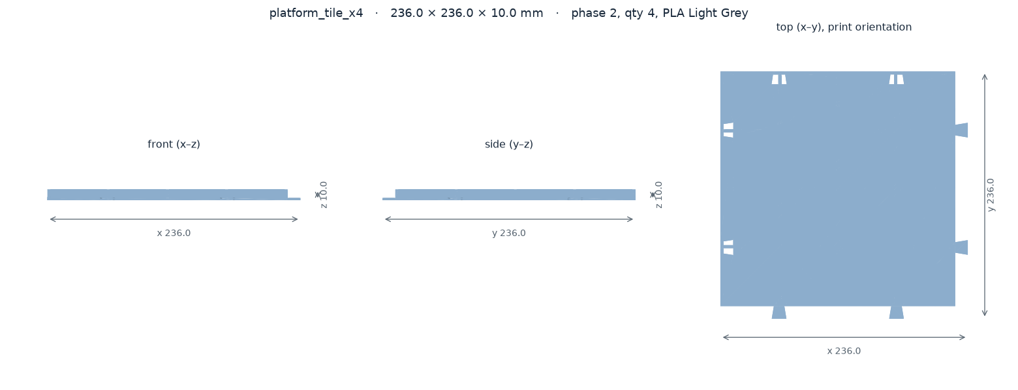
scale_down/print_pack/phase2/sheets/platform_tile_x4.png
