AdithyaKesanJayakanth/PLE-SBS-Capstone/scale_down/print_pack/phase2/sheets/tower_crown_x1.png

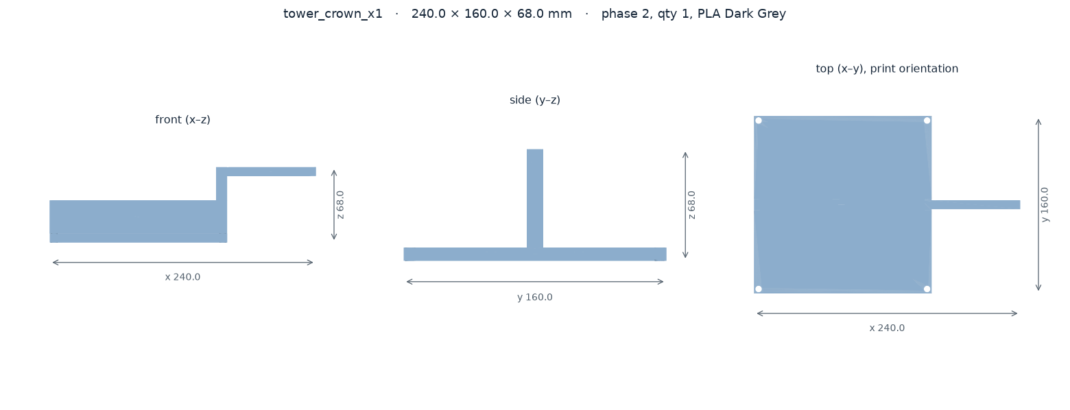
scale_down/print_pack/phase2/sheets/tower_crown_x1.png
