AdithyaKesanJayakanth/PLE-SBS-Capstone/scale_down/print_pack/phase2/sheets/tower_section_x4.png

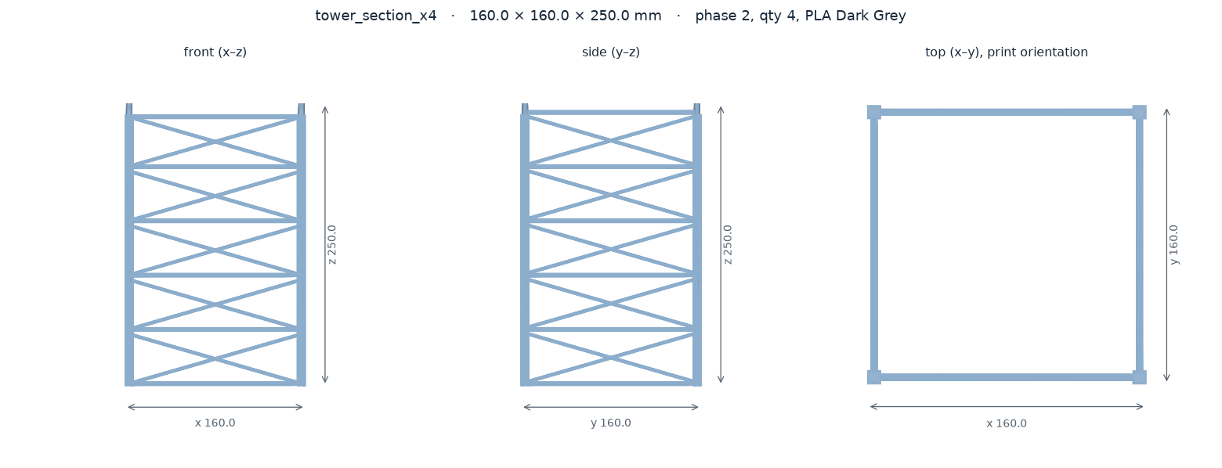
scale_down/print_pack/phase2/sheets/tower_section_x4.png
