AdithyaKesanJayakanth/PLE-SBS-Capstone/scale_down/print_pack/phase2/sheets/wire_saddle_x1.png

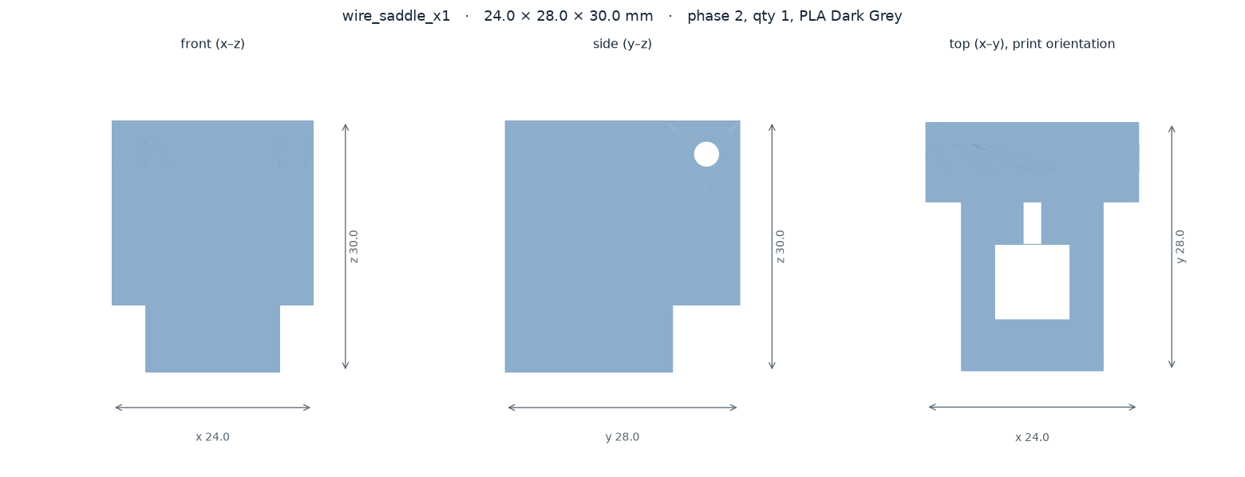
scale_down/print_pack/phase2/sheets/wire_saddle_x1.png
