AdithyaKesanJayakanth/PLE-SBS-Capstone/(commit log)

2026-06-02 Set up project: paper build script and template, data layout
    [scale_model.csv]
2026-06-04 Hazard model: propellant to TNT equivalent, blast and fireball distances, danger levels
2026-06-05 Cable model: counterweight-tensioned taut string; first tests against PL/4T and wL²/8T sag
2026-06-06 Pod dynamics: every pod on a wire integrated together with RK4; eddy-current brake sizing
2026-06-07 Terminal arresters: catch net, drag-chain bed and the switch-yard bay brake
2026-06-09 Evacuation model: people to pods to wires to the terminus, dispatch and headway; closed-form and hazard tests
2026-06-11 Materials and a bill of materials computed from the chosen design
2026-06-13 Browser simulator: any rocket on any pad, single dock or switch yard, brake failures, Materials & BOM tab
2026-06-14 Scale-model rig: parametric 3D-printed parts and a preview
    [basket_x2.stl, fin_clamp_x2.stl, hanger_x2.stl, keeper_sleeve_x4.stl, magnet_channel_150mm_x4.stl, start_gate_x1.stl, start_pin_x2.stl, trolley_plate_x4.stl]
2026-06-15 Rig layout and trolley drawings, parts list, test protocol and STL zip; README
    [scale-model-bom.csv]
2026-06-19 Highlight my special add-on: one wire, a switch yard and a bay for every pod
2026-06-21 Research poster (A0): from the coaster paper and the ISRO visit to the switch yard
2026-06-22 AI-use policy extended for the poster and the printed model
2026-06-23 Print-only 1:50 model: parametric parts for the pods, rails, turnout, bays and wire ends
    [axle_pin_x6.stl, block_marker_flag_x1.stl, brake_comb_190_x3.stl, bumper_x3.stl, chain_11_links_x3.stl, chain_bed_190_x3.stl, gate_key_x4.stl, gate_lever_x3.stl]
2026-06-24 Scale model: sketches, renders, BOM and room sizing; photo and results templates
    [results.csv]
2026-06-25 Paper Section 4 and Figure 8: the print-only scale model
2026-06-26 Scale model: a fit coupon to measure the clearance, and how to make the switch yard work first time
    [fit_coupon_x1.stl, parts.csv]
2026-06-26 Scale model, phase 2: the launch pad and rocket at 1:50, dimensioned drawing and bill of materials
2026-06-26 Phase 2: pad sketch, filament plan for both phases, mechanism print notes
2026-06-26 Phase 2: STL parts for the pad and rocket, preview, assembled render, updated plan
    [access_arm_x1.stl, arm_bracket_x1.stl, arm_pin_x1.stl, booster_lower_x2.stl, booster_strut_x4.stl, booster_upper_x2.stl, capsule_x1.stl, core_segment_x4.stl]
2026-06-26 Phase 2: open the capsule's cavity into its socket so it prints as one shell
    [capsule_x1.stl]
2026-06-26 Phase 2: bill of materials
2026-06-27 Phase 2: renders in the print colours, two views
2026-06-27 Print pack: the tower sections, sliced for the P1S (four plates, 664 g)
    [tower_section_x4.gcode.3mf, tower_section_x4.stl]
2026-06-27 Print pack for the P1S: both phases, STLs in print orientation, dimension sheets, sliced files, grams and times; 0.2 mm clearances; 200 mm core segments; dimensioned elevation
    [access_arm_x1.gcode.3mf, access_arm_x1.stl, arm_bracket_x1.stl, arm_pin_x1.gcode.3mf, arm_pin_x1.stl, axle_pin_x6.stl, block_marker_flag_x1.stl, booster_lower_x2.gcode.3mf]
2026-06-27 Overall renders: both phases assembled, perspective and dimensioned elevation and plan
2026-06-27 Print pack: full parts table with plate numbers
2026-06-27 Print pack: parts table split by phase, with per-phase totals and filament
2026-06-27 Scale model BOM: full wire specification, tension by sag, cutting and ends
2026-06-27 Fits: star sockets, gate pin holes and post clips to 0.2 mm per side; tolerance table in the BOM; re-sliced the five changed parts
    [arm_bracket_x1.gcode.3mf, arm_bracket_x1.stl, gate_lever_x3.stl, index.csv, indexer_x1.stl, start_gate_x3.stl, wire_saddle_x1.gcode.3mf, wire_saddle_x1.stl]
2026-06-27 Print pack: phase-1 reprint folder with the three corrected parts
    [gate_lever_x3.stl, indexer_x1.stl, start_gate_x3.stl]
2026-06-28 Audit of version 1 against itself: where the printed parts missed each other
2026-06-29 Phase 1 version 2: every height from where the wheel seats on the wire and the rail; flap-driven two-finger escapement replaces the star indexer
    [axle_pin_x6.stl, bias_spring_x1.stl, block_marker_flag_x1.stl, brake_comb_190_x3.stl, bumper_x3.stl, chain_11_links_x3.stl, chain_bed_190_x3.stl, fit_coupon_x1.stl]
2026-06-30 Fit-and-motion check in place and in FreeCAD; version 2 re-sliced with a reprint list; paper, poster and READMEs updated
    [axle_pin_x6.stl, bias_spring_x1.gcode.3mf, bias_spring_x1.stl, block_marker_flag_x1.stl, brake_comb_190_x3.stl, bumper_x3.gcode.3mf, bumper_x3.stl, chain_11_links_x3.gcode.3mf]
2026-07-01 Phase 1 assembly: FreeCAD renders of every step and the storyboard
2026-07-02 Phase 1 assembly guide, animations and motion checks; assembly fixes
    [brake_comb_190_x3.stl, chain_bed_190_x3.stl, index.csv, parts.csv, rocker_bridge_x1.stl, sled_x3.stl, start_gate_x1.stl, turnout_base_x1.stl]
2026-07-03 Phase 1 red-team fixes: positive plate gap, wider lips, layer-true plate, eased snaps, bridge clearance
    [axle_pin_x6.gcode.3mf, axle_pin_x6.stl, brake_comb_190_x3.gcode.3mf, chain_bed_190_x3.gcode.3mf, flap_x1.gcode.3mf, flap_x1.stl, gate_lever_x1.gcode.3mf, gate_lever_x1.stl]
2026-07-03 Scale model README: first runs with empty pods at the full drop; a low drop stalls a heavy pod
2026-07-03 Phase 1: one video of assembly, fitting and motion; wagon stacked flat, nuts in the sled
2026-07-03 Assembly guide: full phase-1 video at the top
2026-07-03 Phase 1: spring tab extended toward the pivot; parts catalogue PDF with a render of every part; reprint zip refreshed
    [index.csv, phase1_assembly.FCStd, tongue_x1.gcode.3mf, tongue_x1.stl]
2026-07-04 Reprint split into set 1 (wagon, points, handover) and set 2 (bays, hook, gate): separate folders, zips, tables and PDFs
    [axle_pin_x6.gcode.3mf, axle_pin_x6.stl, bias_spring_x1.gcode.3mf, bias_spring_x1.stl, brake_comb_190_x3.gcode.3mf, brake_comb_190_x3.stl, bumper_x3.gcode.3mf, bumper_x3.stl]
2026-07-06 Paper dated 6 July: the scale model has 26 printed parts; PDF and DOCX rebuilt
2026-07-06 Poster and README: 26 printed parts; poster PDF rebuilt
